WykwalifikowanyProgramista2000/Moj_Chwd_Pytak/Piękne chwytacisko.PNG

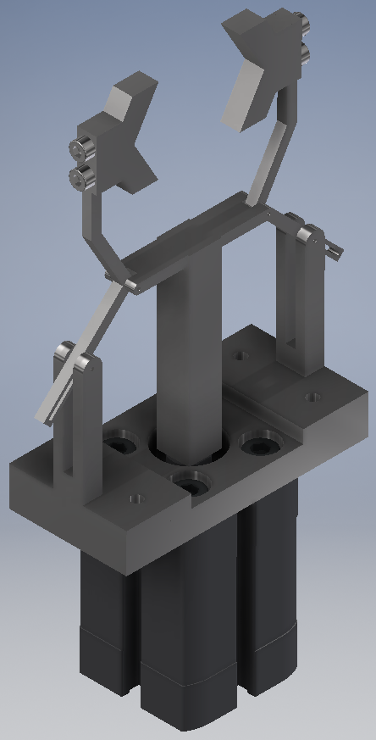
Piękne chwytacisko.PNG
