WykwalifikowanyProgramista2000/Moj_Chwd_Pytak/Fajne Chwytaki/Chwytak.pdf

# Projekt techniczny chwytaka typu

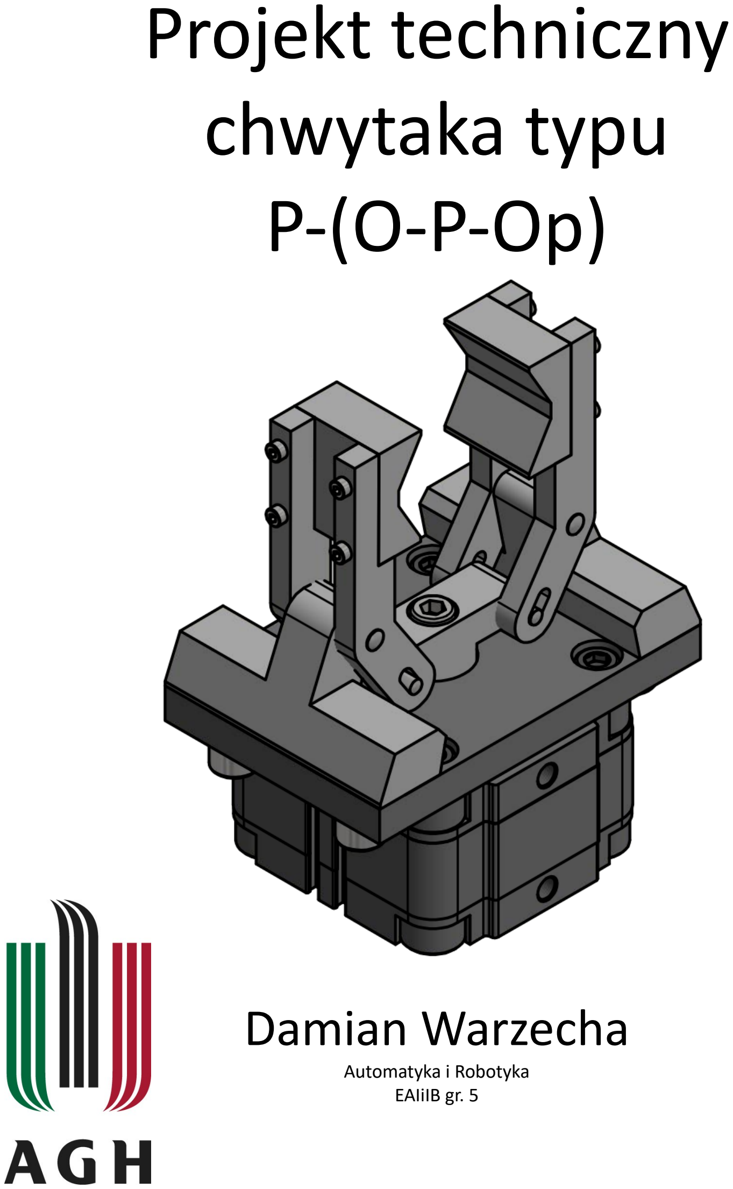
[picture p29: page 1]

# P-(O-P-Op)

# Damian Warzecha

Automatyka i Robotyka
EAIiIB gr. 5

Zadanie projektowe:
Zaprojektować chwytak do manipulatora przemysłowego o zadanym schemacie kinematycznym spełniający następujące wymagania:
- chwytak ma za zadanie uchwycić transportowany obiekt znajdujący się w położeniu początkowym, utrzymywać go w trakcie transportu, oraz wypuścić w położeniu docelowym,
- transportowanym obiektem są wałki stalowe o średnicy d = 70mm oraz długości
maksymalnej lmax | 500 mm,
- siłownik chwytaka zasilany jest sprężonym powietrzem o ciśnieniu pn | 0,6 MPa ,
- należy uwzględnić transport wałków w pozycji pionowej.

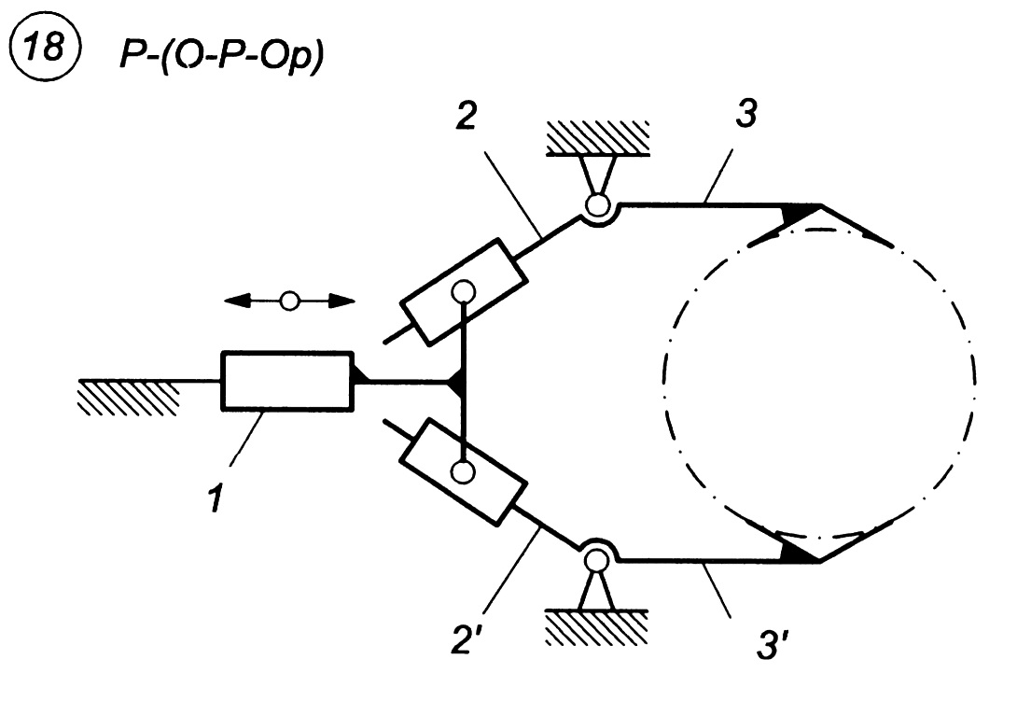
[picture p30: figure]

Rys. 1. Zadany schemat kinematyczny

### 1. Obliczenie ruchliwości chwytaka

Jako, że elementy chwytaka mogą poruszać się tylko w jednej płaszczyźnie, to ruchliwość chwytaka w obliczam ze wzoru:
w=3⋅n−p4−2⋅p5

, gdzie n to ilość członów ruchomych, a px to ilość par kinematycznych klasy x.

W moim przypadku n = 5, p4 = 0, p5 = 7 – {(0,1),(1,2),(1,2'),(2,3),(2,3'),(0,3),(0,3')}
w=3⋅5−0−2⋅7=1
Można z tego wyniku wyciągnąć wniosek, że do pracy chwytak będzie wymagał jednego siłownika liniowego.

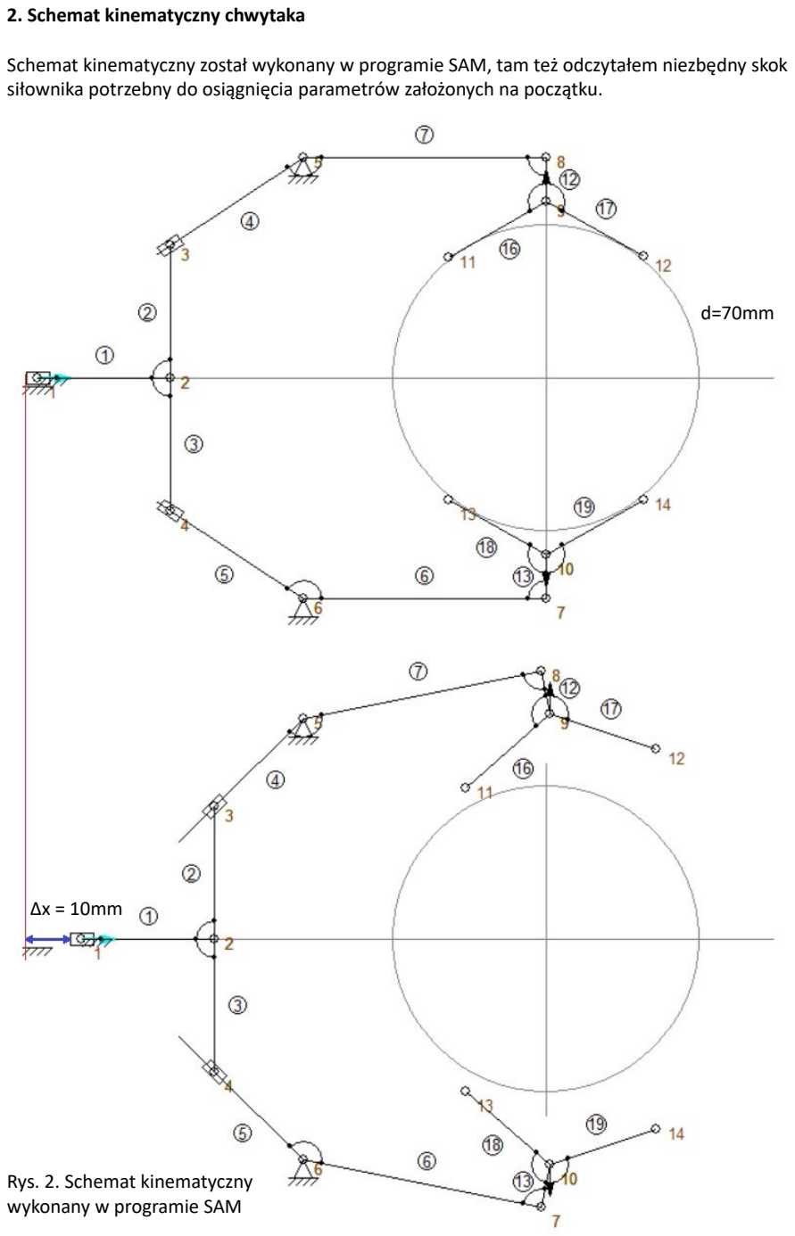
[picture p31: page 3]

### 2. Schemat kinematyczny chwytaka

Schemat kinematyczny został wykonany w programie SAM, tam też odczytałem niezbędny skok siłownika potrzebny do osiągnięcia parametrów założonych na początku.

d=70mm

Δx = 10mm

Rys. 2. Schemat kinematyczny wykonany w programie SAM

### 3. Obliczenie wymaganej siły chwytu

Maksymalny ciężar przenoszonego przedmiotu wyznaczam ze wzoru: , gdzie:
d – średnica transportowanego obiektu,
lmax – maksymalna długość obiektu,
- ciężar właściwy materiału, z którego wykonany jest przedmiot.

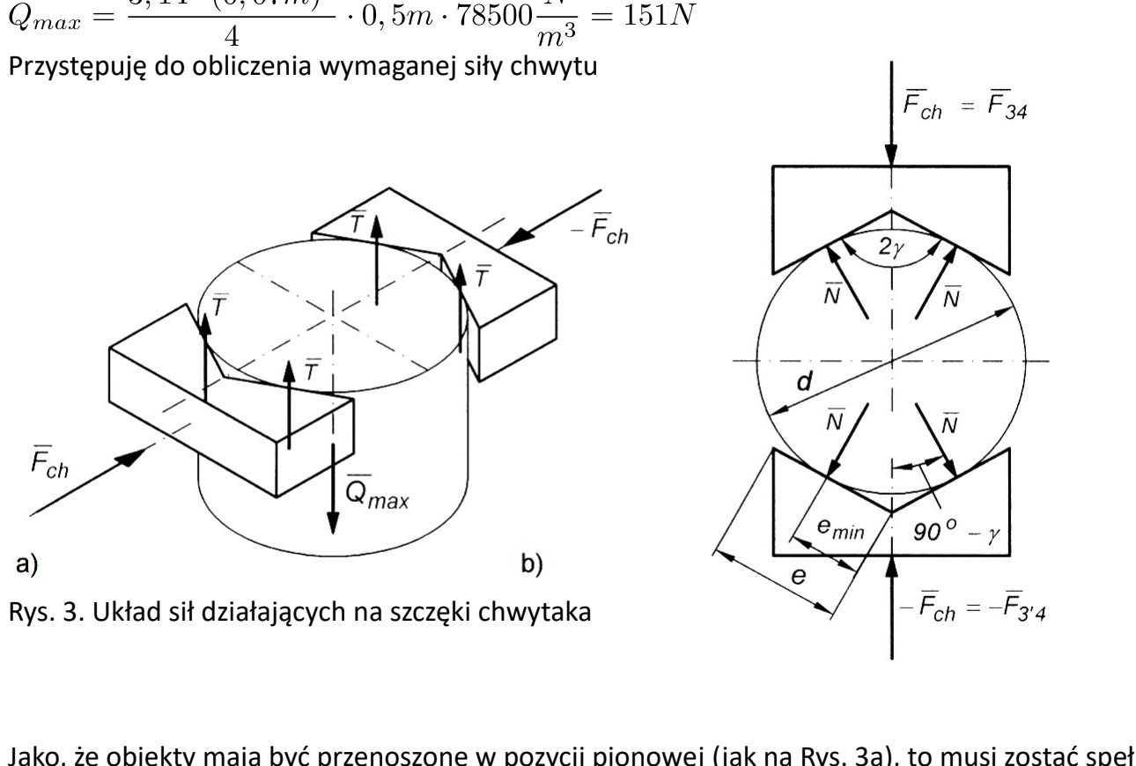
[picture p32: figure]

Przystępuję do obliczenia wymaganej siły chwytu

Rys. 3. Układ sił działających na szczęki chwytaka

Jako, że obiekty mają być przenoszone w pozycji pionowej (jak na Rys. 3a), to musi zostać spełniony warunek:
, gdzie n – współczynnik przeciążenia.

Z zależności trygonometrycznych na podstawie Rys. 4b wyznaczam :

po przekształceniu:

Korzystam teraz ze wzoru na tarcie statyczne:

Stąd otrzymujemy:

Ponownie przekształcamy wzór do ostatecznej postaci:

,
(uznaję, że w momencie rozruchu chwytak doznaje przyspieszenia równego g), ,
(współczynnik tarcia statycznego stal-stal),

Po podstawieniu do wzoru:

Od razu wyznaczam rozmiar szczęki e, jako: e > emin Aby wyznaczyć emin korzystam z zależności:
,
a więc przyjmuję rozmiar e swoich szczęk = 25mm

### 4. Charakterystyka przemieszczeniowa chwytaka

Wykres charakterystyki przemieszczeniowej został wykonany w programie SAM dla węzła nr 8

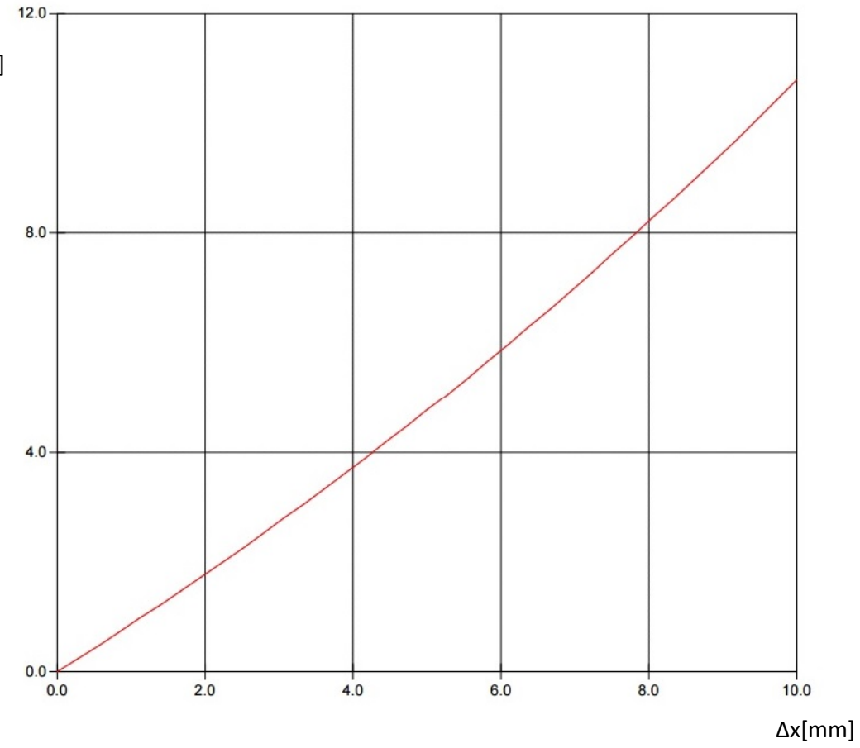
[picture p33: figure]

Δy[mm]

Rys. 4. Charakterystyka przemieszczeniowa chwytaka

## fv max = 1,4

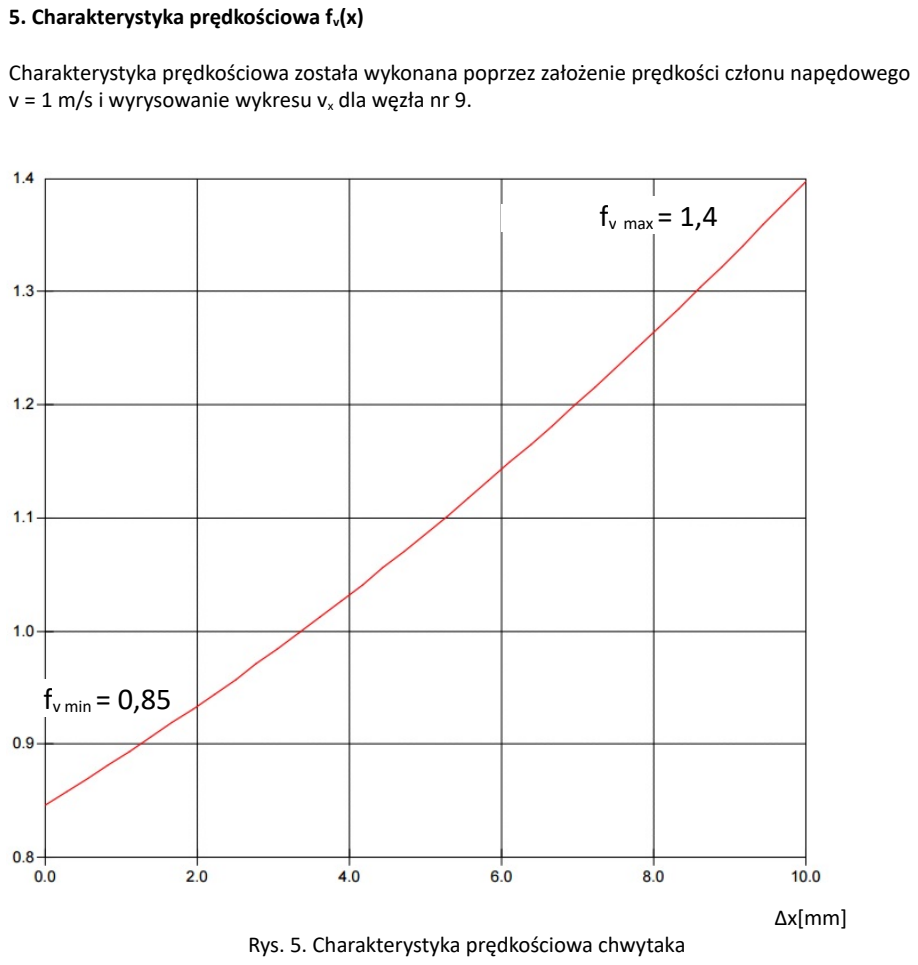
[picture p34: page 6]

### 5. Charakterystyka prędkościowa fv(x)

Charakterystyka prędkościowa została wykonana poprzez założenie prędkości członu napędowego v = 1 m/s i wyrysowanie wykresu vx dla węzła nr 9.

## fv min = 0,85

Δx[mm]
Rys. 5. Charakterystyka prędkościowa chwytaka

### 6. Charakterystyka siłowa chwytaka

Charakterystykę tą wykonałem poprzez obciążenie symetrycznie szczęk chwytaka siłami, których wartość jest równa uprzednio wyliczonej Fch i odczytanie wartości siły w kierunku x na członie zasilającym.

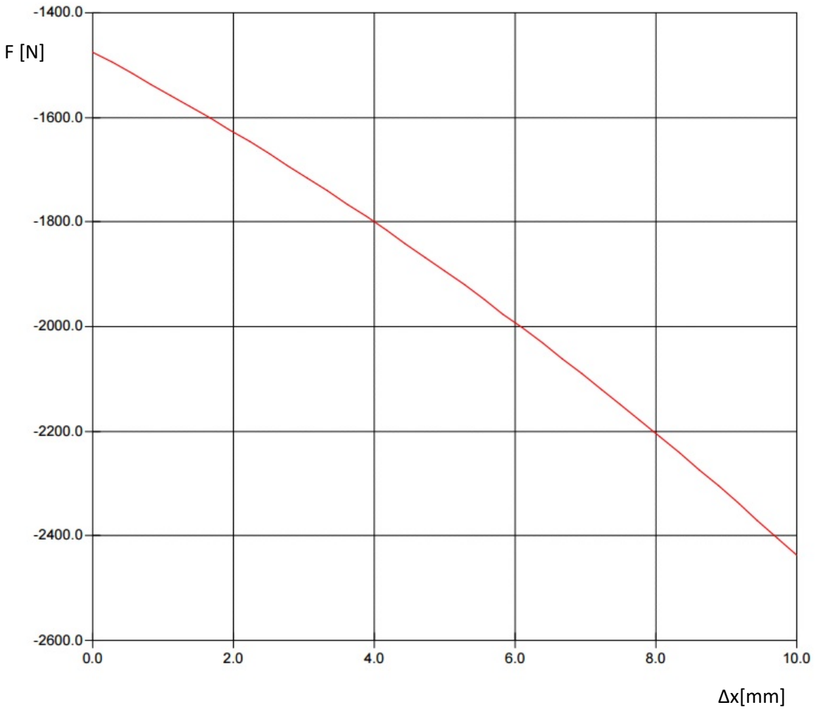
[picture p35: figure]

Rys. 6. Charakterystyka siłowa chwytaka

Jak widać w chwili zaciśnięcia szczęk chwytaka siła, jaką musi dostarczyć siłownik aby utrzymać wałek w pozycji zamkniętej jest równa 1500N. Nie przewiduję możliwości transportowania nim wałków o innych średnicach, więc pomijam pozostałą część wykresu.

Jednak siła F=1500N jest jedynie teoretyczną wartością i należy uwzględnić pewien współczynnik przeciążenia k, który zazwyczaj przyjmuje się jako k = 1,2 ÷ 1,5. Jest to dodatkowa forma zabezpieczenia, która uwzględnia np. sytuacje uderzenia przenoszonym elementem w pewną przeszkodę.
Ja przyjmę współczynnik k = 1,5 ponieważ transportowane przez mój chwytak elementy będą posiadały maksymalną masę równą 15kg, przez co upuszczone mogą stanowić znaczne zagrożenie.

A więc siła, którą będę używał do dalszych obliczeń ma wartość Fs = 2250 N.

### 7. Dobór odpowiedniego siłownika pneumatycznego

Chwytak o zadanym schemacie kinematycznym zaciska swe szczęki przy ruchu członu napędowego w kierunku przeciwnym do reszty mechanizmu, a więc siłownik jaki wybiorę musi działać w trybie ciągnącym.

Kolejnym ważnym parametrem siłownika jest średnica jego tłoka, ponieważ to od niej zależy siła, którą będzie mógł on wygenerować.

Siłę siłownika wyraża się wzorem | ,

stąd średnica tłoka

Podstawiam dane uzyskane z charakterystyki siłowej, oraz podane w treści zadania ciśnienie nominalne powietrza zasilającego chwytak.

Jako, że średnice siłowników należą do pewnego szeregu normalnego, to muszę wybrać pierwszą większą od Dmin
Dostępne średnice:
12mm | 16mm | 20mm | 25mm | 32mm | 40mm | 50mm | 63mm | 80mm | 100mm | 125mm

Wybieram średnicę D = 80mm.

Stosowny siłownik znalazłem w ofercie firmy Festo. Jest to model ADVULQ-80-10-P-A o średnicy tłoka 80mm, skoku 10mm oraz obustronnym trybie działania. Jak podaje producent przy ciśnieniu 0,6 MPa siła ciągnąca wynosi 2827 N.

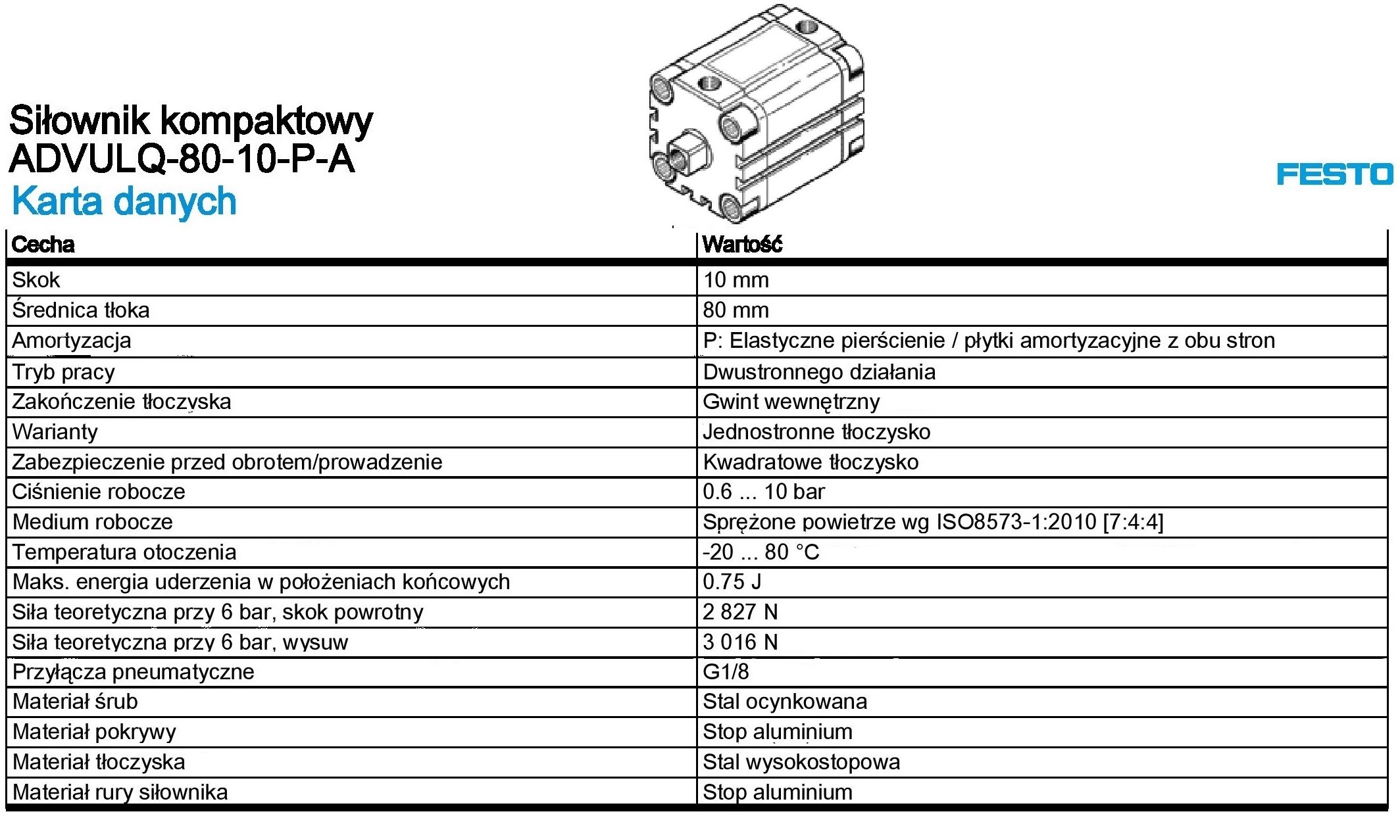
[picture p36: figure]

### 8. Obliczenia wytrzymałościowe – warunek wytrzymałości na ścinanie sworznia

Przy zadanym schemacie kinematycznym tylko 2 symetryczne względem siebie pary kinematyczne posiadają połączenia sworzniowe (węzły 5 i 6 (Rys. 2.)) , a więc wystarczy sprawdzić warunek wytrzymałości na ścinanie dla tylko jednego sworznia.
Warunek wytrzymałościowy na ścinanie ma postać: | , gdzie:
Ft | – siła działająca na sworzeń,
A – pole powierzchni, na które działa siła,

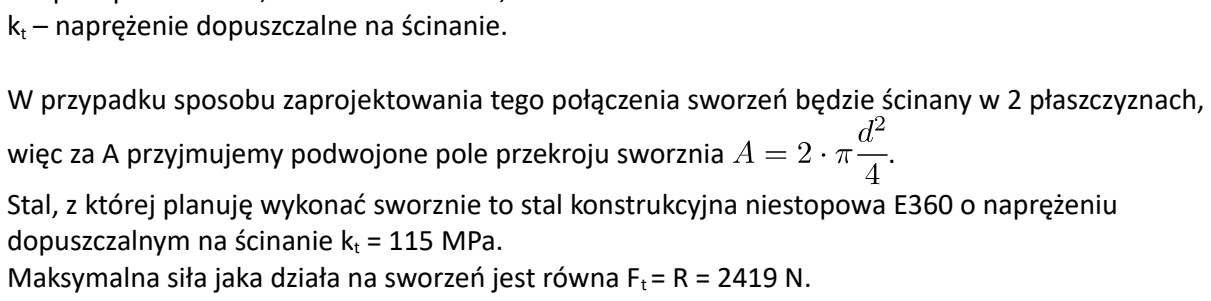
[picture p37: figure]
– naprężenie dopuszczalne na ścinanie.; dopuszczalnym na ścinanie kt; = 115 MPa.

W przypadku sposobu zaprojektowania tego połączenia sworzeń będzie ścinany w 2 płaszczyznach,
więc za A przyjmujemy podwojone pole przekroju sworznia | .
Stal, z której planuję wykonać sworznie to stal konstrukcyjna niestopowa E360 o naprężeniu

Maksymalna siła jaka działa na sworzeń jest równa Ft = R = 2419 N.

Obliczam minimalną średnicę sworznia ze wzoru:

### 9. Obliczenia wytrzymałościowe – warunek wytrzymałościowy na zginanie ramion chwytaka

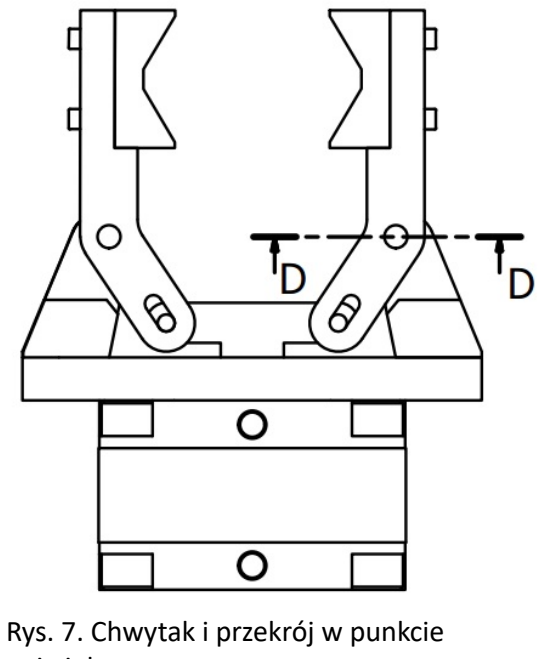
[picture p38: figure]
Rys. 7. Chwytak i przekrój w punkcie
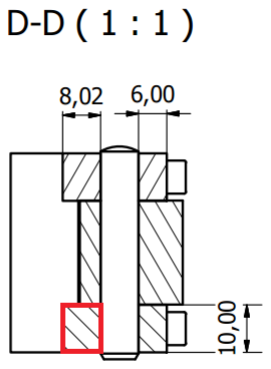
[picture p39: figure]

największego momentu gnącego

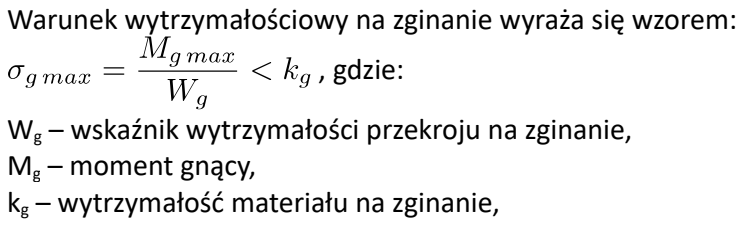
[picture p40: figure]
, gdzie:; Mg – moment gnący,

Warunek wytrzymałościowy na zginanie wyraża się wzorem:

Wg – wskaźnik wytrzymałości przekroju na zginanie,

kg – wytrzymałość materiału na zginanie,

Ramię chwytaka wykonane zostanie ze stali konstrukcyjnej E360 o kg = 210 MPa.

Największy moment gnący będzie występował w przekroju D-D i jego wartość jest równa: ,
zgadza się to z wynikiem uzyskanym w Autodesk ForceEffect

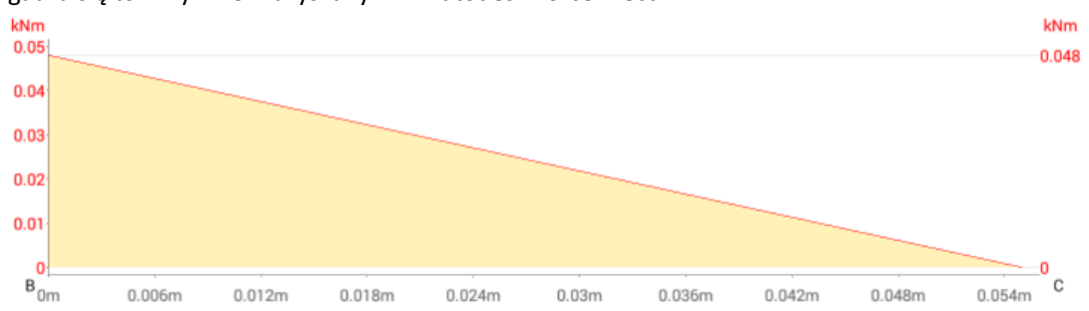
[picture p41: figure]

Jak widać na Rys. 7. przekrój nie jest symetryczny, lecz jeśli policzymy wartość wskaźnika wytrzymałości na zginanie zakładając, że część zaznaczona na czerwono ma tylko 6mm szerokości i pozostałe 2,02mm nie przenosi żadnych obciążeń, to:

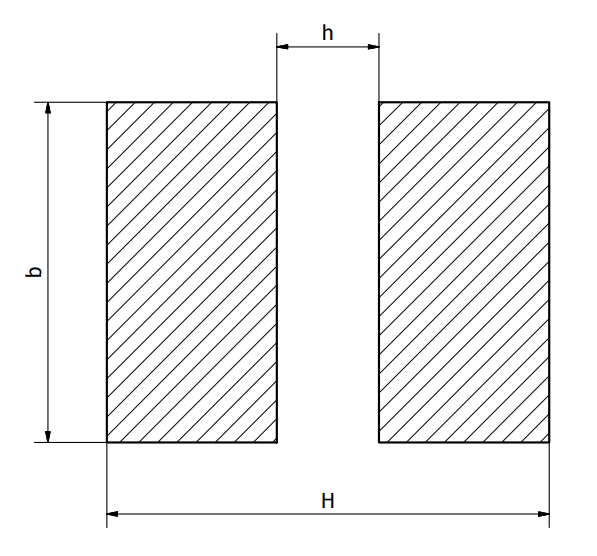
[picture p42: figure]

Jako, że ramie składa się z dwóch elementów, to wielkość b może zostać pomnożona razy 2.

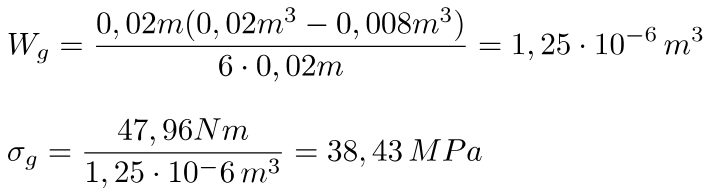
[picture p43: figure]

Czyli jest to zdecydowanie mniej niż dopuszczone dla tego materiału 210 MPa.

### 10. Projekt konstrukcyjny chwytaka

Załączniki:
1. Rysunek złożeniowy chwytaka,
2. Rysunek wykonawczy ramienia chwytaka.
