WykwalifikowanyProgramista2000/Moj_Chwd_Pytak/Fajne Chwytaki/chwytak 20 wzór.pdf

# PROJEKT CHWYTAKA

NR 20

## Dariusz Papierniak EAIiE II rok AiR

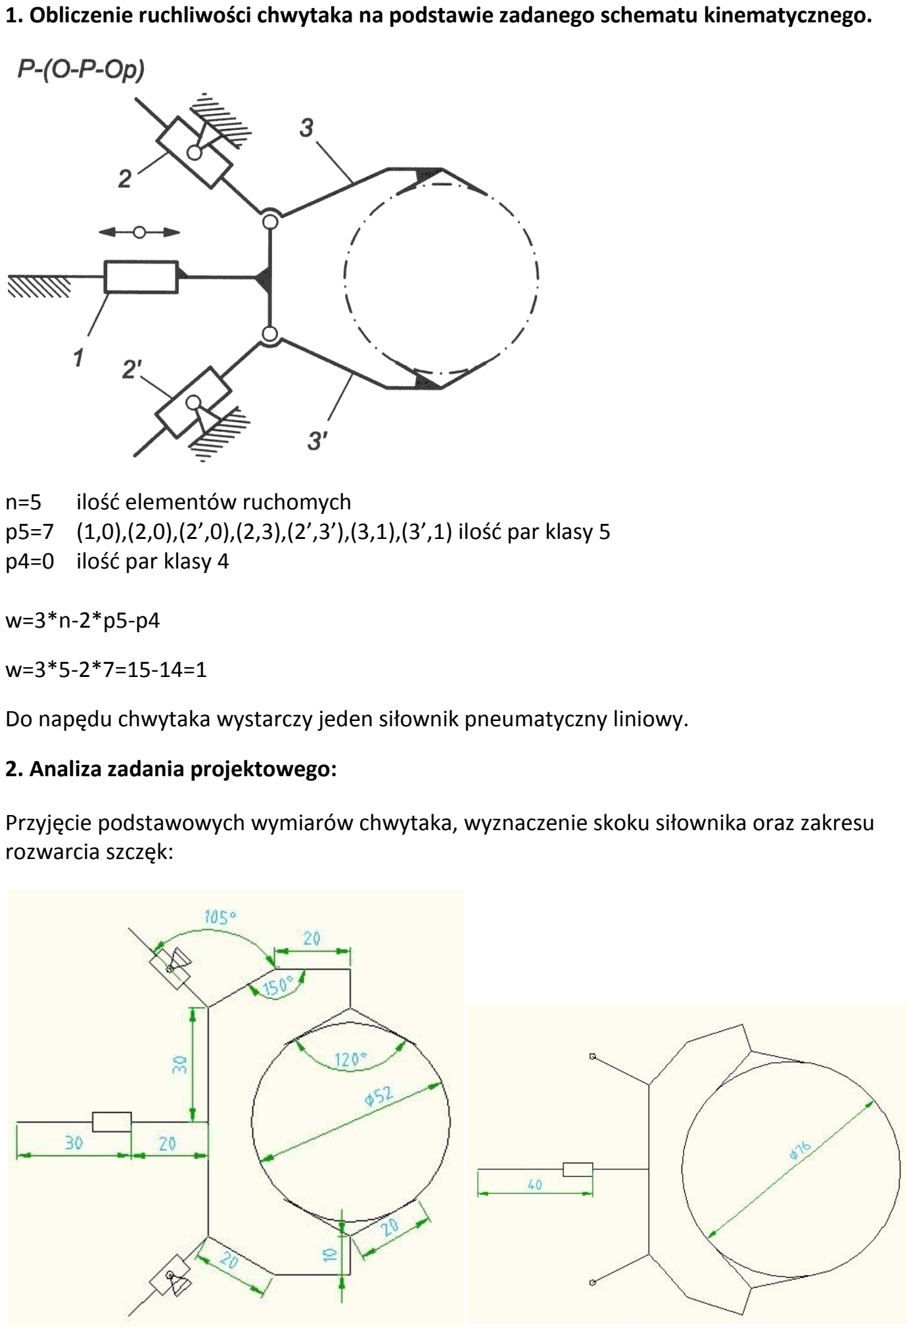
[picture p44: page 2]

1. Obliczenie ruchliwości chwytaka na podstawie zadanego schematu kinematycznego.

n=5 ilośd elementów ruchomych
p5=7 (1,0),(2,0),(2’,0),(2,3),(2’,3’),(3,1),(3’,1) ilośd par klasy 5 p4=0 ilośd par klasy 4

w=3*n-2*p5-p4

w=3*5-2*7=15-14=1

Do napędu chwytaka wystarczy jeden siłownik pneumatyczny liniowy.

### 2. Analiza zadania projektowego:

Przyjęcie podstawowych wymiarów chwytaka, wyznaczenie skoku siłownika oraz zakresu rozwarcia szczęk:

Maksymalny ciężar obiektu transportowanego obliczam ze wzoru:

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
dmax = 76,00 [mm] = 0,076 [m] | - średnica największego wałka,
dmin = 52,00 [mm] = 0,052 [m] | - średnica najmniejszego wałka,
lmax = 0.4 [m] | - maksymalna długośd chwytanego obiektu,
γ = 78000 [N/m³
] | - ciężar właściwy transportowanego materiału (stal).

Obliczone wartości Q wynoszą:

Q1 = 141,54 N | - maksymalny ciężar obiektu dla dmax
Q2 = 66,26 N | - maksymalny ciężar obiektu dla dmin

Współczynniki przyjmuję następująco:

μ = 0,2 | - współczynnik tarcia (metal-metal)
n = 2 | - współczynnik bezpieczeostwa
2γ = 120° | - kąt nachylenia szczęk chwytaka

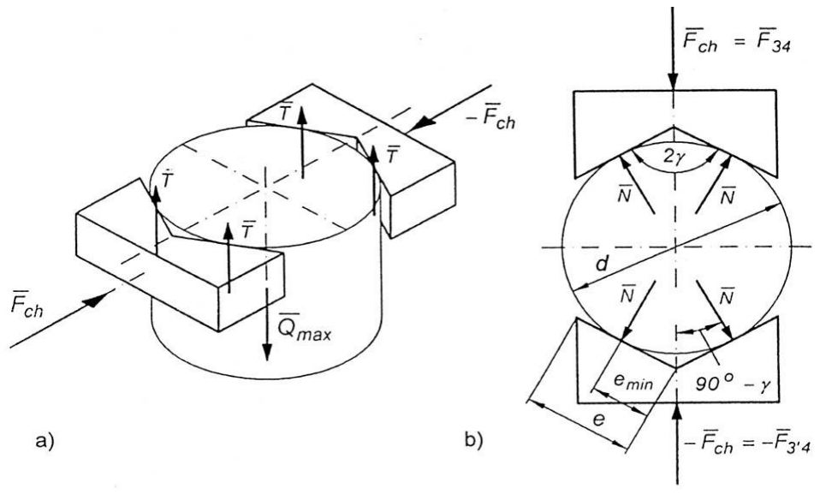
[picture p45: figure]

Wyznaczenie koniecznej siły chwytu Fch i obliczenie wymiarów szczęk:

Układ sił działających na chwytak:

a) rozkład sił tarcia podczas chwytania
b) rozkład sił normalnych podczas chwytania

F = 2N cos(90°-γ )
ch | 2cos(90 | γ ) | 2sinγ
Fch | Fch N | =
| ° -

=

γ

µ
µ
2sin

·
= | =
Fch T | N

Siły tarcia muszą spełniad warunek:

Q n

F
T
ch | ≥ ·

·
=
γ

µ
sin

2
4

stąd

µ

γ
2

Q nsin Fch
·
≥

Wstawiając dane do równania (ciężar obiektu Q2) otrzymuję:

Fch=286,91 N

Do dalszych obliczeo przyjmuję Fch=300 N

Obliczenie minimalnej wielkości szczęk

tgγ

d
e
2

min =

w moim przypadku emin=15,01 mm

Przyjęte przeze mnie e=20 mm

### 3. Obliczenie charakterystyki przesunięciowej chwytaka

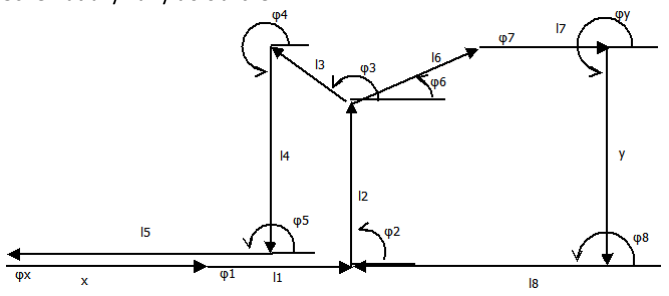
[picture p46: figure]

Schemat używany do obliczeo:

Każdemu wektorowi odpowiada kąt skierowany. Wielkości które nie ulegają zmianie w trakcie ruchu chwytaka to:

l1=20 mm, l2=30 mm, l4=40 mm, l5= 40 mm, l6=20 mm, l7=20 mm,

φx=0° , φ1=0°, φ2=90°, φ4=270°, φ5=180°, φy=270°, φ8=180°

ponadto znane są zależności:

φ6=φ3-105°, φ7=φ3-135°

Pozostałe wielkości zależą od wartości x.

Zgodnie z przyjętymi wcześniej wielkościami x zmienia się w przedziale od 30 do 40 mm

Korzystam z metody analitycznej.

Dla zamkniętego wieloboku wektorowego zapisuję równanie:

Z którego wyznaczam wartośd φ3 potrzebną do dalszych obliczeo:

Rzut na oś x:

xcos(φx)+l1cos (φ1)+ l2cos (φ2)+ l3cos (φ3)+ l4cos (φ4)+ l5cos (φ5)=0

Po uwzględnieniu znanych kątów:

x+l1+l3cos(φ3)-l5=0

więc

l3cos(φ3)=l5-x-l1

Rzut na oś y:

xsin(φx)+l1sin(φ1)+ l2sin(φ2)+ l3sin(φ3)+ l4sin(φ4)+ l5sin(φ5)=0

Po uwzględnieniu znanych kątów:

l2+l3sin(φ3)-l4=0

więc

l3sin(φ3)=l4-l2 po wyrugowaniu l3 otrzymuję:

funkcja arctg zwraca kąt z przedziału -90°,90°, ponieważ kąt φ3 jest kątem rozwartym

Natomiast z jedynki trygonometrycznej otrzymuję:

l3=

Zapisuję równanie wektorowe dla drugiego wieloboku:

Do wyznaczenia wartości y wystarczy rzut na oś y:

ysin(φy)+l2sin(φ2)+ l6sin(φ6)+ l7sin(φ7)+ l8sin(φ8)=0

Po wstawieniu znanych wartości kątów:

y=l2+l6sin(φ3-105°)+ l7sin(φ3-135°)

Oto charakterystyka przesunięciowa otrzymana za pomocą programu Excel:

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
30 | 31 | 32 | 33 | 34 | 35 | 36 | 37 | 38 | 39 | 40 y, mm

x, mm

Charakterystyka przesunięciowa chwytaka

4. Wyznaczenie charakterystyki prędkościowej chwytaka.

W celu otrzymania charakterystyki prędkościowej chwytaka należy zróżniczkowad charakterystykę przesunięciową.

fV(x)=

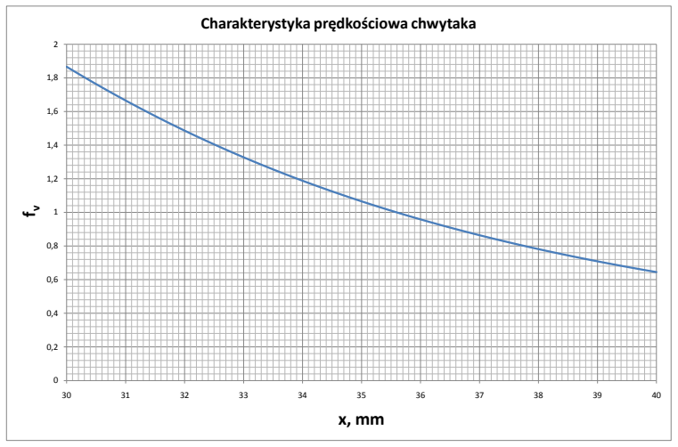
[picture p47: figure]
Charakterystyka prędkościowa chwytaka

Powyżej znajduje się charakterystyka prędkościowa uzyskana za pomocą programu Excel. Poniżej zamieszczam natomiast obie charakterystyki uzyskane w programie SAM.

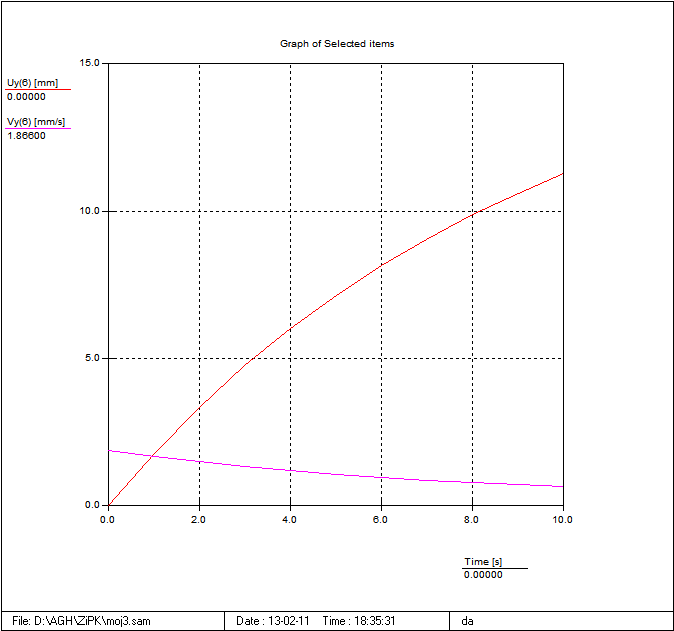
[picture p48: figure]

W obu przypadkach charakterystyki te są identyczne.

### 5. Wyznaczenie charakterystyki siłowej chwytaka

gdzie:

- siła chwytu
- siła na wyjściu siłownika
- przełożenie siłowe mechanizmu chwytaka

Model obliczeniowy do wyznaczenia charakterystyki siłowej

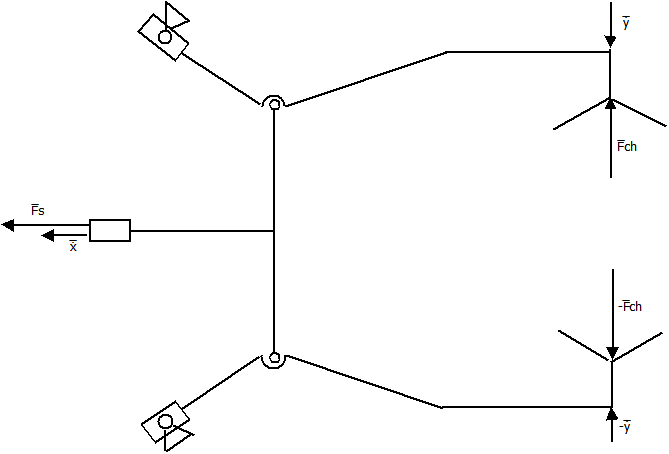
[picture p49: figure]

Dokonuję obliczeo dla chwytaka w pozycji zamkniętej. Wówczas stosując te same oznaczenia kątów i wektorów co w pkt 3:

φ3=135°, φ6=30°, φ7=0 °

Po uwolnieniu od więzów górne ramię wygląda następująco:

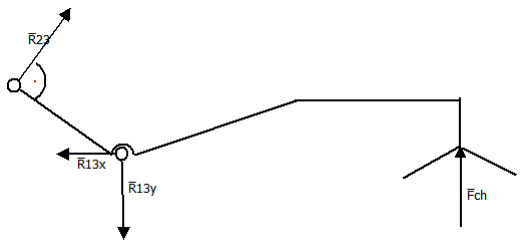
[picture p50: figure]

Siła R23 jest prostopadła do l3, zatem jest pod kątem φ3-90°. W rozpatrywanej sytuacji

R23x= R23y= R23

Z warunków równowagi dla sił i momentów możemy zapisad:

skąd otrzymuję następujące zależności:

R23x=R13x

R13y=Fch+R23y

korzystając z wcześniej obliczonego wzoru na l3 mogę zapisad:

skąd dla Fch=300N

R23=791,68 N więc R23x=R23y=559,8 N

Dla pozostałej części chwytaka mamy:

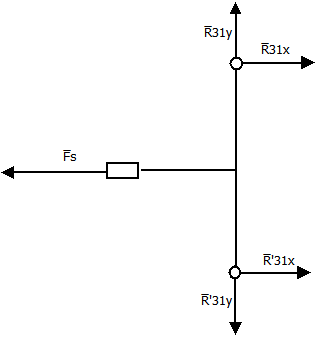
[picture p51: figure]

ponieważ R31=R’31 mamy:

Fs=2 R31x

ponadto

więc w początkowym położeniu wymagana siła Fs=1119,6 N

Wprowadzając zależności analityczne możemy równanie momentów dla ramienia zapisad następująco:

minus przy cos po prawej stronie pojawił się gdyż interesuje nas długośd rzutu wektora l3 na oś x.

Ponieważ R23 ma byd prostopadłe do l3 mamy zależnośd między składową poziomą i pionową:

ponadto:

Otrzymuję

po uwględnieniu wcześniej wyprowadzonych wzorów otrzymuję:

6. Sprawdzenie charakterystyki siłowej metodą mocy chwilowych. Model chwytaka do wyznaczenia bilansu mocy chwilowych:

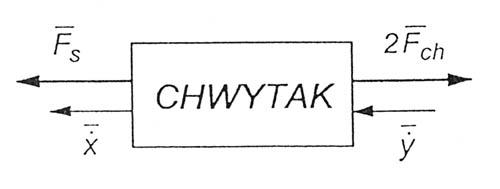
[picture p52: figure]

Bilans mocy chwilowych przy pominięciu tarcia, sił ciężkości oraz bezwładności:

NWE+NWY=0

2 ( )

1
( )
2 | 0

f x

f x

F x | F | y

v

F

S | ch
=
- - · =

Otrzymana charakterystyka jest identyczna jak w pkt 5. Oto jej wykres:

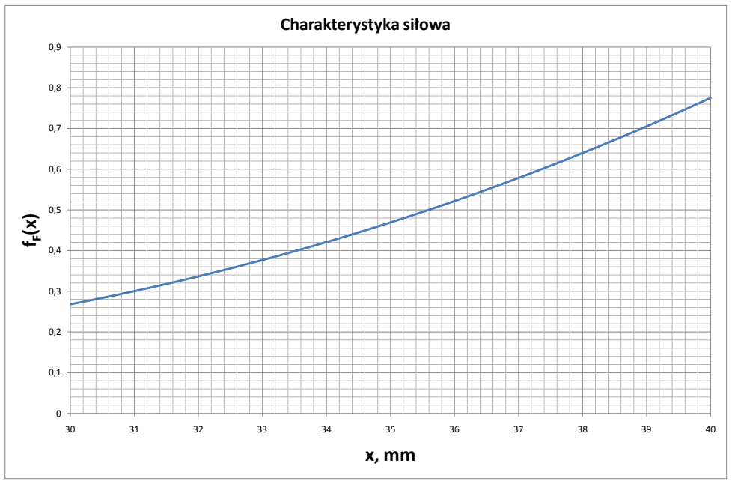
[picture p53: figure]
Charakterystyka siłowa

### 7. Obliczenia wytrzymałościowe

a) najbardziej obciążonego sworznia na ścinanie

Najbardziej obciążonym sworzniem jest ten, na którym obraca się ramię. Działa na niego siła F31. Dla położenia x=30 mm jest ona największa i wynosi około 800N (wartośd wyliczona na podstawie równao z pkt 5). Siła tnąca T wynosi więc 400N, gdyż ramię chwytaka jest podwójne. Sworzeo ma średnicę 5mm i jest wykonany ze stali st3, dla której dopuszczalne naprężenie na ścinanie wynosi kt=54 MPa.

a więc warunek wytrzymałości na ścinanie został spełniony.

b) ramienia na zginanie

Maksymalny moment gnący występuje w miejscu w którym przez ramię przechodzi sworzeo dla x=30 mm. Działający wówczas na ramię moment wynosi:

11,2 Nm

Ramię jest podwójne więc na każdą częśd działa moment równy 5,6 Nm.

Każda częśd ramienia będzie miała w przekroju kwadrat o boku 10mm. Ponieważ przez ramię w tym miejscu przechodzi sworzeo o średnicy 5mm przyjmuję h=5 mm.

wzór na naprężenie:

po wstawieniu danych daje wartośd

Dla stali st5, z której zostanie wykonane ramię kg=160 MPa, więc również ten warunek wytrzymałości został spełniony.

8. Obliczenie wymaganych parametrów napędu pneumatycznego chwytaka.

Teoretyczna siła pchająca sylindra pneumatycznego:

Teoretyczna siła ciągnąca napędu pneumatycznego:

Siłownik musi spełniad zasadę:

Fs max obliczam z charakterystyki siłowej i wynosi ona:

Fs max | N

dla k=1,5 potrzebna siła ciągnąca wynosi 1680 N

Z katalogu firmy FESTO wybieram standardowy siłownik o średnicy tłoka 63mm i skoku 10mm

Podana przez producenta siła ciągnąca wynosi 1750 N.

Oznaczenie siłownika to ADVC-63-10-A-P.
