WykwalifikowanyProgramista2000/Moj_Chwd_Pytak/Gotowy projekt v1.pdf

Zapis i Podstawy Konstrukcji. Projekt chwytaka P-(O-P-Op)

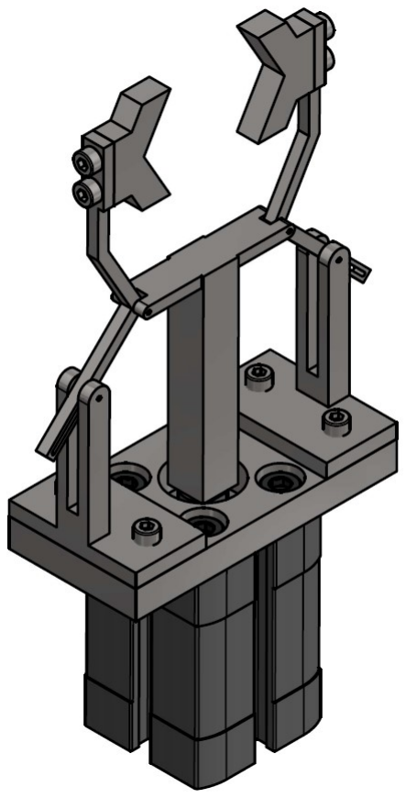
[picture p54: figure]

1

# PROJEKT CHWYTAKA TYPU P-(O-P-Op)

# Wojciech Dziuba

### Automatyka i Robotyka

### WEAIiIB


2

## Zadanie projektowe

Zaprojektować chwytak do manipulatora przemysłowego według zadanego schematu kinematycznego spełniający następujące wymagania:

a) w procesie transportu urządzenie chwytające ma za zadanie pobrać (uchwycić) obiekt w położeniu początkowym, trzymać go w trakcie trwania czynności transportowych i uwolnić go w miejscu docelowym
b) obiektem transportu są wałki oraz tuleje ze stali o średnicy d = 34mm
i długości l = 100mm
c) manipulator zasilany jest sprężonym powietrzem o ciśnieniu nominalnym pn = 0,6 MPa.
d) wałki transportowane są wyłącznie w pozycji pionowej

Rys. 1. Schemat kinematyczny chwytaka

## 1. Obliczenie ruchliwości chwytaka

Ruchliwość mechanizmu chwytaka obliczono korzystając z poniższego wzoru

w = 3n − 2p5 − p4 | (1)

Gdzie:

w | – ruchliwość chwytaka
n | - liczba członów ruchomych
p5 | - liczba par kinematycznych klasy piątej obrotowych i postępowych
p4 | - liczba par klasy czwartej

Zapis i Podstawy Konstrukcji. Projekt chwytaka P

Dla chwytaka P-(O-P-Op):

n = 5 | p5 = 7 (1,0) (2,0

Ruchliwość mechanizmu chwytaka w = 1, w związku z czym do napędzania chwytaka wykorzystano pojedynczy siłownik pneumatyczny o ruchu liniowym.

## 2. Analiza zadania projektowego


Rys. 2. Schemat kinematyczny chwytaka w założonych położeniach krańcowych wykonany w programie SAM 7.0
Pozycja A –
Pozycja B – rozwarcie maksymalne szczęk d

3

) (2’,0) (2,3) (2’,3’) (3,1) (3’,1)

w = 3 ∗ 5 − 2 ∗ 7 − 0 = 1

emat kinematyczny chwytaka w założonych położeniach krańcowych przy skoku członu napędzającego rozwarcie minimalne szczęk dA = 34mm rozwarcie maksymalne szczęk dB = 60mm

p4 = 0

∆x = 15mm

mm

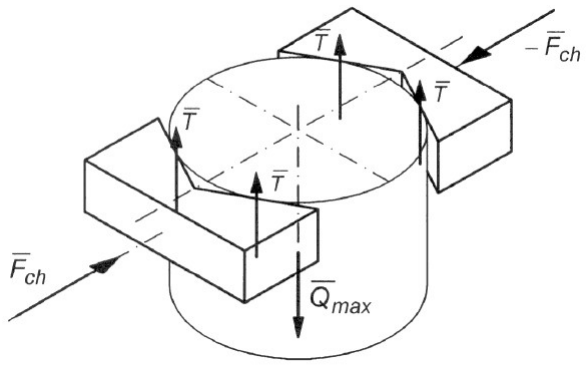
[picture p55: figure]

4

## 3. Wyznaczenie koniecznej siły chwytu Fch

Transportowany obiekt powinien być chwytany w pozycji którą pokazano na Rys. 3. oraz Rys. 4.

Rys. 3. Rozkład sił tarcia podczas chwytania obiektu


Rys. 4. Rozkład sił
normalnych podczas
chwytania obiektu

Maksymalny ciężar transportowanego obiektu Qmax wyznaczono ze wzoru (2) rozpatrując sytuację w pozycji A Rys. 2.

Qmax =

π dmax

2
4
lmax ∗ ρ [N] | (2)

Gdzie:

dmax | - maksymalna średnica przenoszonego obiektu
lmax | - maksymalna długość przenoszonego obiektu
ρ | - ciężar właściwy transportowanego obiektu

Zatem:

Dla pozycji A | QA max =

π ∙ 0,0342
4
- 0, 1 ∙ 78, 5 ∙ 103
≅ 7, 20 [N]

5

Następnie konieczną siłę chwytu szczęk chwytaka wyznaczono za pomocą przekształconego wzoru (3) w następujący sposób

Fch = 2Ncos(90° − γ) = 2Nsin(γ) | (3)

N =

Fch
2sin(γ)

T = μN =

μFch
2sin(γ)
Aby transportowany element został uchwycony prawidłowo musi być spełniony warunek:

4T =

2μFch
sin(γ)
≥ Q ∙ n | stąd | Fch ≥

Qn sinγ
2μ

Gdzie:

N - siła normalna
2γ | - kąt rozwarcia szczęk chwytaka
μ | - współczynnik tarcia pomiędzy stalowymi szczękami chwytaka, a
stalowym obiektem
n | - Współczynnik przeciążenia chwytaka (przyjęty za równy 2)

Dla pozycji A z Rys. 2. wymagana siła chwytu Fch wynosi:

FA ch ≥

7, 2 ∙ 2 ∙ sin(60°)
2 ∙ 0, 15 ≅ 42 [N]

Minimalne wymiary szczęki chwytaka obliczono na podstawie poniższych wzorów, kształtu ramion chwytaka (Rys. 4.) oraz kształtu transportowanego obiektu:

tgγ =

d

2emin

stąd | e > emin =

d
2tgγ
Zatem dla przenoszenia wałków o średnicy d = 34 mm:

emin =

34
2 ∙ tg(60°) ≅ 11 mm

Dla dalszych obliczeń przyjęto zatem e = 15 mm.


6

## 4. Charakterystyka przemieszczeniowa chwytaka

Rys. 5. Model chwytaka do wyznaczania charakterystyki przemieszczenia przy wykorzystaniu metody zamkniętego wieloboku.

Wielkości stałe:

l1 | = 25mm
l2 | = 20mm
l4 | = 34mm
l5 | = 31mm
l6 | = 20mm
l7 | = 20mm
φx | = 0°
φy | = 270°
φ1 | = 0°
φ2 | = 90°
φ4 | = 270°
φ5 | = 180°
φ8 | = 180°
Pozostałe wielkości:
φ6 = φ3 – 105 | φ7 = φ3 – 135

Są one zależne od wartości x. Delta x wynosi ∆x = 15mm, a długość x zmienia się od 20mm do 35mm.

### 4.1 Wielobok L

Korzystając z metody analitycznej suma wszystkich wektorów wieloboku wektorowego L musi być równa 0.

x + l1 ⃗ + l2 ⃗ + l3 ⃗ + l4 ⃗ + l5 ⃗ = 0

Następnie wykonano rzut na OY oraz OX.

xcos(φx) + l1cos(φ1) + l2cos(φ2) + l3cos(φ3) + l4cos(φ4) + l5cos(φ5) = 0 xsin(φx) + l1sin(φ1) + l2sin(φ2) + l3sin(φ3) + l4sin(φ4) + l5sin(φ5) = 0

15 Przemieszczenie [mm]; Wysunięcie suwaka [mm]; Charakterystyka przemieszczeniowa

7

x + l1 + l3cos(φ3) − l5 = 0 l2 + l3sin(φ3) − l4 = 0

l3cos(φ3) = l5 − x − l1
l3sin(φ3) = l4 − l2
Zatem:

l3sin(φ3)
l3cos(φ3)

= tg(φ3) =

l4 − l2
l5 − x − l1 | φ3 = arctg

l4 − l2
| l5 − x − l1 + 180°
[l3cos(φ3)]

2 = [l5 − x − l1]

2
[l3sin(φ3)]

2 = [l4 − l2]

2

l32cos(φ3) | 2 + sin(φ3) 2 = [l5 − x − l1]

2 + [l4 − l2]

2

l3 = [l5 − x − l1]2 + [l4 − l2]2

### 4.2 Wielobok P

Równanie dla wieloboku P:

y⃗ + l2 ⃗ + l6 ⃗ + l7 ⃗ + l8 ⃗ = 0

ysin(φy) + l2sin(φ2) + l6sin(φ6) + l7sin(φ7) + l8sin(φ8) = 0

y = l2 + l6sin(φ3 − 105°) + l7sin(φ3 − 135°)

Rys. 6. Charakterystyka przemieszczeniowa otrzymana w programie Excel 2007


8

Rys. 7. Charakterystyka przemieszczeniowa otrzymana w programie SAM 7.0 Oś pozioma x – wysunięcie suwaka [mm] Oś pionowa y – przemieszczenie [mm]

Otrzymane charakterystyki są bardzo zbliżone i różnice pomiędzy kolejnymi wartościami znajdują się na drugim miejscu po przecinku

| Wysunięcie suwaka [mm] | Przemieszczenie [mm]
Początkowe | 0 | 0
Końcowe | 15 | 11,744

## 5. Charakterystyka prędkościowa chwytaka

Charakterystykę prędkościową chwytaka wyznaczono różniczkując charakterystykę przesunięciową po x

dy
dx =

d
dx (l2 + l6 sin(φ3 − 105°) + l7 sin(φ3 − 135°))

dy
dx = l2

dφ3
dx + l6 sin(φ3 − 105°)

dφ3
dx + l7 sin(φ3 − 135°)

dφ3
dx

dy
dx = l6 ∙ sin(φ3 − 105°)

dφ3
dx + l7 ∙ sin(φ3 − 135°)

dφ3
dx

dφ3
dx =

l4 − l2
(l5 − x − l1)

2 + (l4 − l2)

2

fv

(x) =

dy
dx =

(l4 − l2) ∙ ((l6 ∙ cos(φ3 − 105°) + l7 ∙ cos(φ3 − 135°)) (l5 − x − l1)2 + (l4 − l2)2

15 Prędkość [mm/s]; Wysunięcie suwaka [mm]; Charakterystyka prędkościowa fv

9

Rys. 6. Charakterystyka prędkościowa otrzymana w programie Excel 2007

Rys. 7. Charakterystyka prędkościowa otrzymana w programie SAM 7.0 Oś pozioma x - wysunięcie suwaka [mm]
Oś pionowa y – prędkość [mm/s]
| Wysunięcie suwaka [mm] | Prędkość [mm]
Początkowe/a | 0 | 0
Końcowe/a | 15 | 11,744

Zapis i Podstawy Konstrukcji. Projekt chwytaka P

## 6. Charakterystyka siłowa chwytaka

Charakterystyka siłowa określona jest poniższym wzorem

Gdzie:
fF(x) | - Przełożenie siłowe mechanizmu chwytaka
Fch | - Siła chwytu
Fs | - Siła na wyjściu zespołu napędowego (siłownika) chwytaka

Można ją jednak wyznaczyć stosując metod
wykorzystać wzór fv(x) wcześniej policzonej charakterystyki prędkościowej chwytaka

Gdzie:
fF(x) | - Przełożenie siłowe mechanizmu chwytaka
fv(x) | - Charakterystyka prędkościowa
| fF (x) = 2(l4 −

Zamiast charakterystyki siłowej wyrażonej powyższym wzorem wykonano charakterystykę siły na członie napędzającym
założeniu, obciążenia ramion chwytaka symetrycznym układem sił Maksymalna siła na członie napędzającym wyniosła


Rys. 8. Model do wykonania charakterystyki siłowej w programie SAM 7.0

10

fF

(x) =

Fch
FS

Przełożenie siłowe mechanizmu chwytaka

Siła na wyjściu zespołu napędowego (siłownika) chwytaka

ę mocy chwilowych, w której można wcześniej policzonej charakterystyki prędkościowej

fF

(x) =

1
2 ∙ fv(x)

Przełożenie siłowe mechanizmu chwytaka

(l5 − x − l1)

2 + (l4 − l2)

2
l2) ∙ ((l6 ∙ cos(φ3 − 105°) + l7 ∙ cos(φ3 − 135

w programie SAM 7.0

FSmax = 111N

Model do wykonania charakterystyki siłowej w programie SAM 7.0

135°)

przy
Fch = 42N

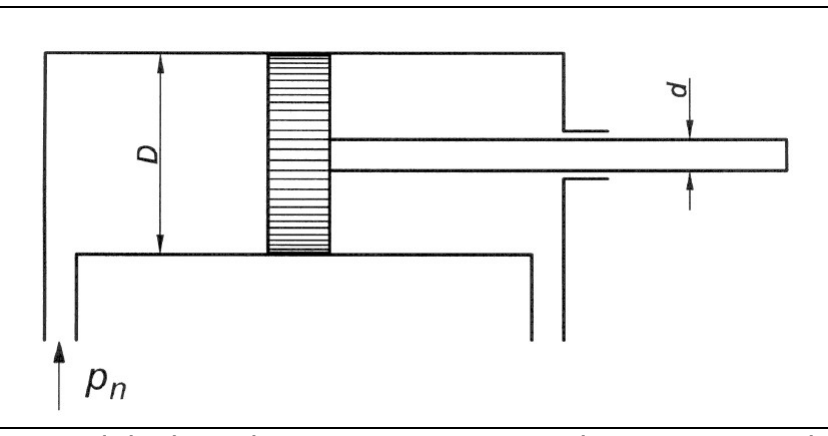
[picture p56: figure]

11

Rys. 9. Charakterystyka siły na członie napędzającym wykonana w SAM 7.0 Oś pozioma – wysunięcie suwaka [mm] Oś pionowa – siła na członie napędzającym (suwaku) [N]

## 7. Obliczenie wymaganych parametrów napędu pneumatycznego chwytaka

Rys. 10. Model siłownika pneumatycznego dwustronnego działania

Przy założeniu ciśnienia zasilania pneumatycznego pn = 0,6MPa i sile na członie napędzającym FS = 111N wymaganą minimalną średnicę tłoka Dmin obliczono za pomocą poniższego wzoru

Dmin =
4 ∙ FSmax
π ∙ pn

≅ 0, 016 m

Następnie na podstawie wyznaczonej minimalnej średnicy tłoka dobrano odpowiedni siłownik stosując zasadę


12

Pt

≥ Pw = k ∙ FSmax
Gdzie:
Pt | - teoretyczna siła pchająca lub ciągnąca siłownik
Pw | - obliczona wymagana siła na tłoczysku
k = 1,2 | - współczynnik przeciążenia
FSmax | - Siła na wyjściu siłownika chwytaka

Zatem:

Pt

≥ Pw = 1, 2 ∙ 111 ≅ 134N
Oznacza to że interesuje nas siłownik o parametrach
Pt ≥ 134N | D ≥ 16mm | ∆x = 15mm

## 8. Dobór siłownika na podstawie wymaganych parametrów

Biorąc pod uwagę wymagania wyznaczone w punkcie 7. dobrano odpowiedni siłownik z oferty firmy Festo[1]

Rys. 11. Karta danych siłownika


13

## 9. Obliczenia wytrzymałości chwytaka

### 9.1 Sprawdzenie warunku wytrzymałościowego na ścianie dla najbardziej obciążonego sworznia

Rys. 13. Charakterystyka siły Fabs absolutnej działającej w przegubie 10 (Rys.8.) zestawiona z charakterystyką siły Fx na członie napędzającym

Na podstawie Rys. 13. oraz Rys. 8. można określić że największe obciążenie występuje w sworzniu 10 oraz 11 w pozycji chwytu. Siła reakcji na tym przegubie wynosi Rs

≅ 79N i jest jednocześnie maksymalną siłą reakcji ma tym przegubie.

Na materiał do wykonania sworzni oraz konstrukcji chwytaka została wybrana stal 20HG, [2] której wytrzymałość na ścinanie wynosi kt = 240 MPa, a sworznie w całym mechanizmie mają średnicę d = 1mm.
Sworznie ścinane są w dwóch płaszczyznach zatem warunek wytrzymałościowy ma postać

τmax =

2 ∙ Rs
π ∙ d2 ≅ 51 MPa < kt = 240 MPa

Wynika z tego że warunek wytrzymałości na ścinanie został spełniony.

Ponieważ obliczenia były wykonywane dla najbardziej obciążonego sworznia można uznać, że pozostałe sworznie również będą odporne na ścinanie

### 9.1 Sprawdzenie warunku wytrzymałościowego na zginanie ramion chwytaka

Moment gnący ramię obliczono na podstawie wzoru

Mg = r ∙ Fch

Gdzie:
r | - ramię siły
F - siła chwytu

14

Maksymalny moment gnący znajduje się w miejscu w którym ramię przechodzi przez sworzeń przy zamkniętym położeniu szczęk chwytaka. Moment siły w tamtym miejscu to:

Fch ∙ (l6 cos(30°) + l7) ≅ 1, 6 Nm
Co pokrywa się z wartością wyliczoną przez SAM 7.0, który podaje Mg ≅ 1,6 Nm.

Ramie chwytaka ma przekrój kwadratu o boku a = 3mm, a sworzeń przechodzący przez ramię w miejscu przegubu osłabia konstrukcję, więc wzór na wskaźnik wytrzymałości przyjmuje postać

Wg =

a(a

3 − d

3
)
6a ≅ 4, 3 ∙ 109 m3

Na podstawie wyżej wyznaczonych wartości wyznaczono warunek wytrzymałościowy wyrażony poniższym wzorem

σgmax =

Mg
Wg

≅ 370 MPa < kg = 450 MPa

Stal 20HG[2] hartowana i nawęglana którą wybrano na wykonanie ramion chwytaka posiada wytrzymałość na zginanie kg = 450 MPa, co oznacza że warunek wytrzymałości na zginanie został spełniony.

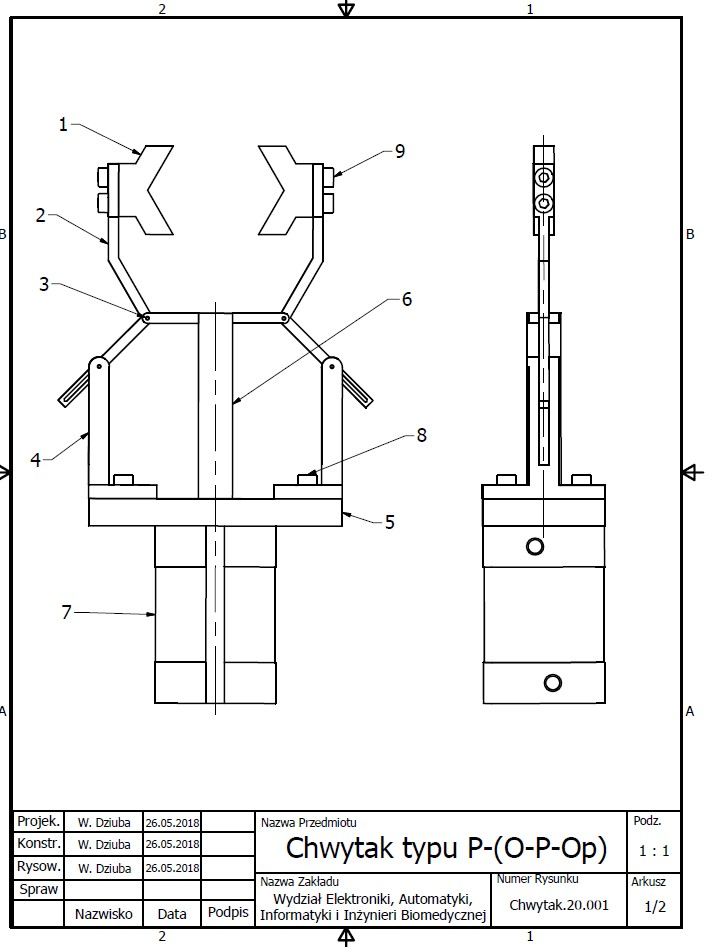
[picture p57: figure]

15

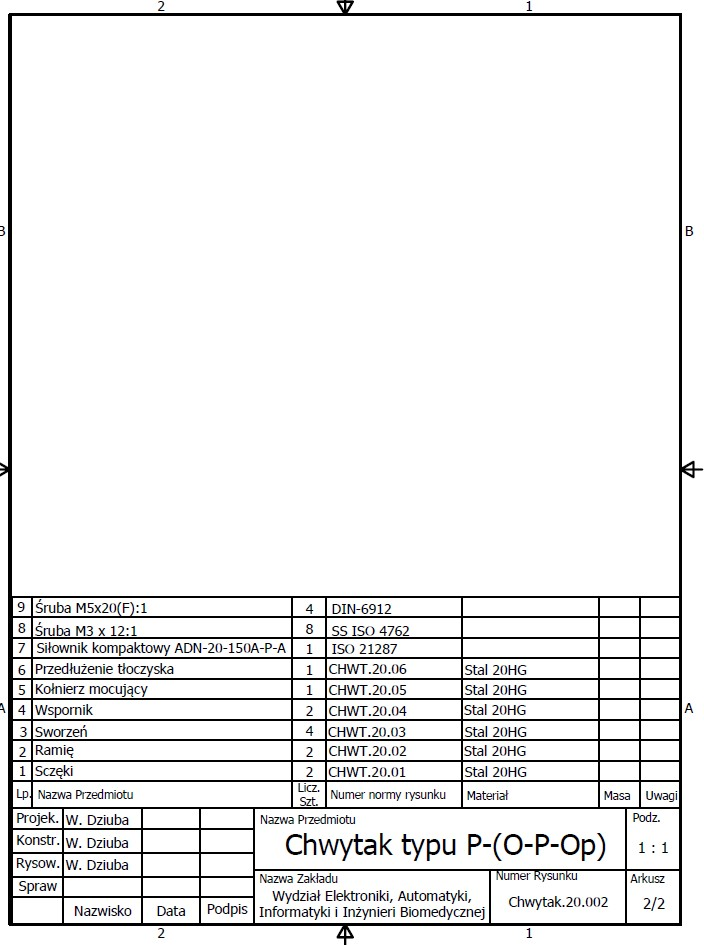
[picture p58: figure]

16

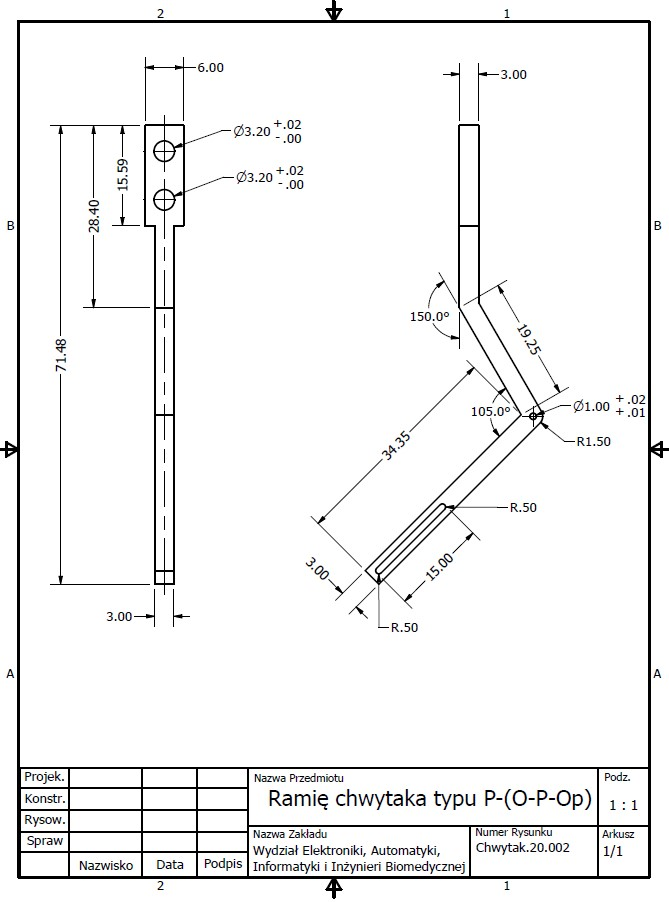
[picture p59: figure]

17

18

## Bibliografia

[1] https://www.festo.com/cat/pl_pl/products 25.05.2018
[2] http://gemini.net.pl/~marshall/pkm/tablice/tab01.htm 26.05.2018
