WykwalifikowanyProgramista2000/Moj_Chwd_Pytak/DO DRUKU/3 Chwytak-20-001 Rysunek główny 2.pdf

1

2

B | B

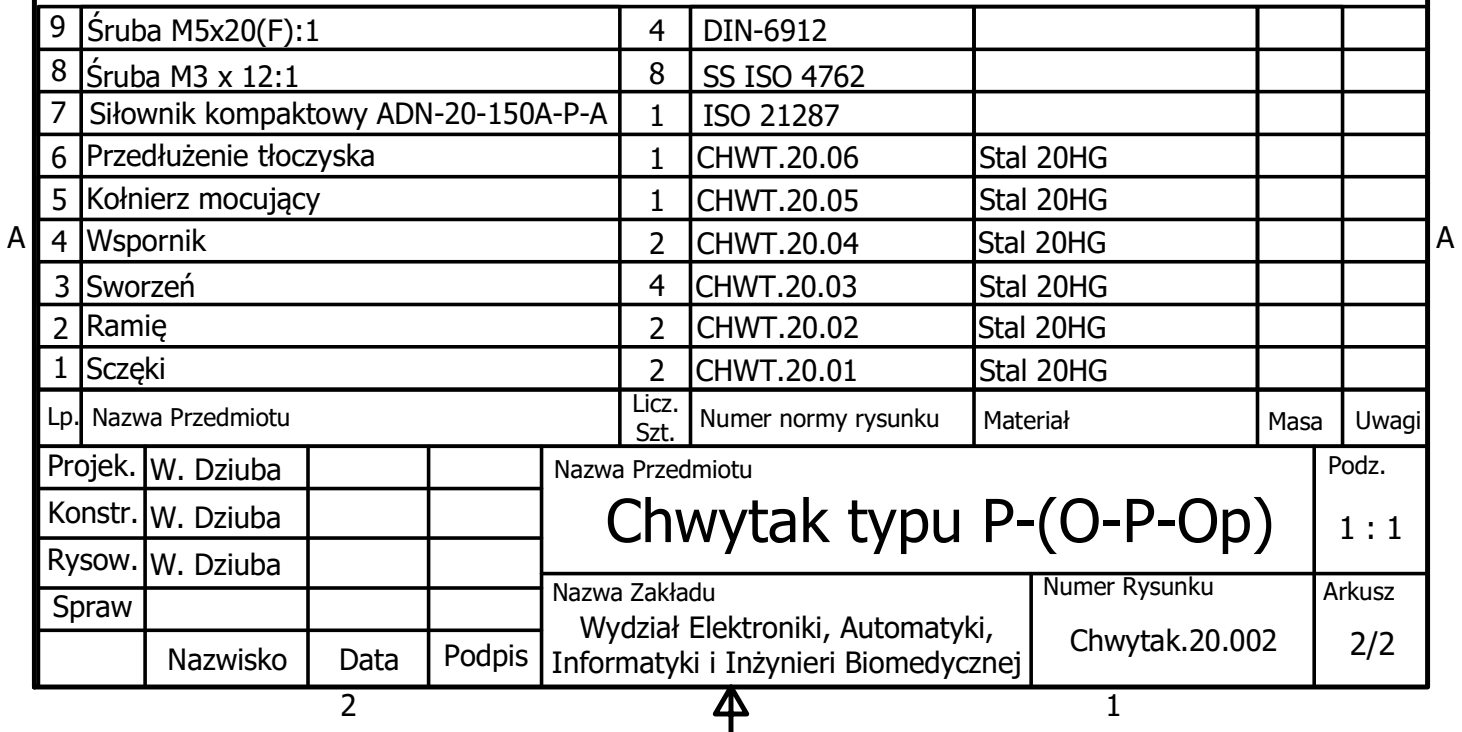
[picture p60: figure]
Projek.; Konstr.; Rysow.; Spraw; Nazwisko; Data; Podpis; Nazwa Zakáadu Wydziaá Elektroniki, Automatyki, Informatyki i Inynieri Biomedycznej; Nazwa Przedmiotu Chwytak typu P-(O-P-Op); Podz.; Numer Rysunku; Chwytak.20.002; Arkusz; Nazwa Przedmiotu; Licz. Szt.; Numer normy rysunku; Materiaá; Masa; Uwagi; Sczki; Rami; Sworze; Wspornik; Koánierz mocujcy; Przedáuenie táoczyska; Siáownik kompaktowy ADN-20-150A-P-A; ruba M3 x 12:1; SS ISO 4762; ruba M5x20(F):1; DIN-6912; ISO 21287; CHWT.20.01; CHWT.20.02; CHWT.20.03; CHWT.20.04; CHWT.20.05; CHWT.20.06; Stal 20HG; W. Dziuba
