WykwalifikowanyProgramista2000/Moj_Chwd_Pytak/Fajne Chwytaki/Projekt chwytaka 2017 numer 10.pdf

# PROJEKT CHWYTAKA

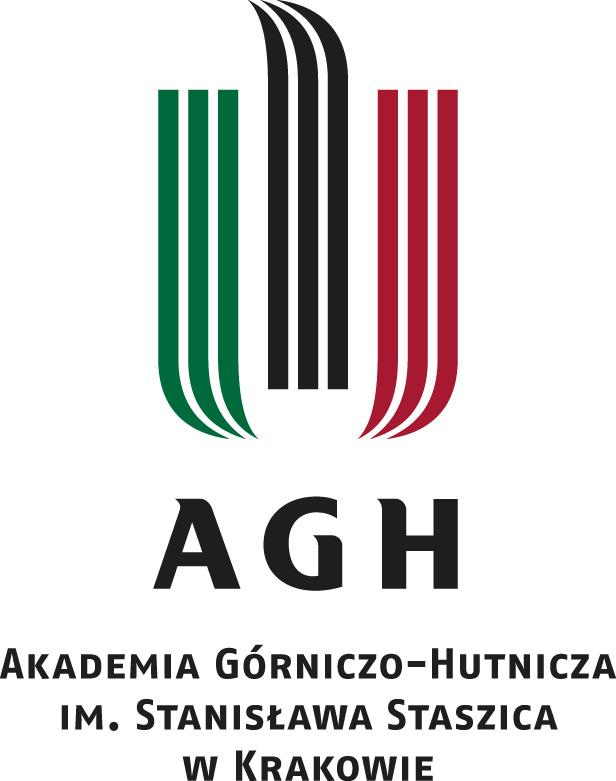
[picture p61: figure]

### PRZYGOTOWAŁA: Zuzanna Gunia

AUTOMATYKA I ROBOTYKA
WEAIIB

### Zapis i Podstawy Konstrukcji. Projekt chwytaka P-(O-O-O)

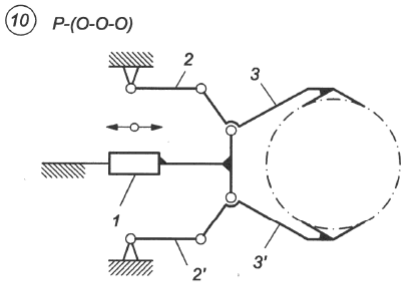
[picture p62: figure]
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

Zaprojektować chwytak do manipulatora przemysłowego wg zadanego schematu kinematycznego spełniający następujące wymagania:

1) w procesie transportu urządzenie chwytające ma za zadanie pobrać (uchwycić) obiekt w położeniu początkowym, trzymać go w trakcie trwania czynności transportowych i uwolnić go w miejscu docelowym,
2) obiektem transportu są wałki ze stali o średnicy d =90mm, długości
l = 100mm ,
3) siłownik chwytaka zasilany jest sprężonym powietrzem o ciśnieniu nominalnym ......pn = 0.6 MP
d) wałki transportowane są w pozycji pionowej.

OBLICZENIE RUCHLIWOŚCI CHWYTAKA NA PODSTAWIE ZADANEGO SCHEMATU KINEMATYCZNEGO

Ruchliwość chwytaka obliczamy ze wzoru ogólnego (dla mechanizmów płaskich):

W = 3n − 2p5 − p4

Gdzie:

n – liczba członów ruchomych,
p5 – liczba par kinematycznych klasy V (obrotowych i postępowych), p4 – liczba par kinematycznych klasy IV (obrotowych i postępowych),

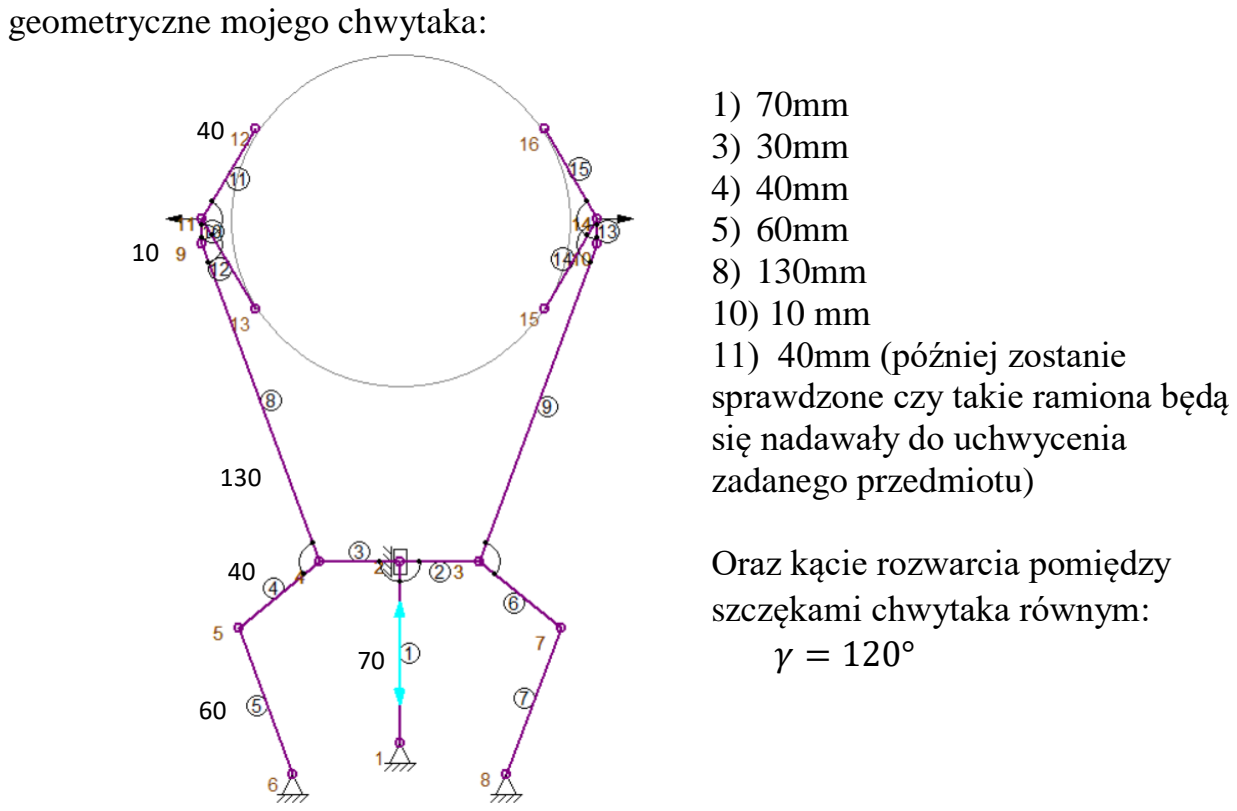
[picture p63: figure]
geometryczne mojego chwytaka:; 1) 70mm 3) 30mm 4) 40mm 5) 60mm 8) 130mm 10) 10 mm 11) 40mm (później zostanie sprawdzone czy takie ramiona będą się nadawały do uchwycenia zadanego przedmiotu); Oraz kącie rozwarcia pomiędzy szczękami chwytaka równym: γ = 120°

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

Dla zadanego schematu kinematycznego mamy:

Człony ruchome:

n = (1),(2),(2’),(3),(3’) = 5

Pary kinematyczne klasy V:

p5 = (0,1),(0,2),(0,2’),(1,3),(1,3’),(2,3),(2’,3’) = 7

Pary kinematyczne klasy IV:

p4 = 0

Podstawiam otrzymane dane do wzoru i wyznaczam ruchliwość chwytaka:

W = 3n − 2p5 − p4 = 3 ∙ 5 − 2 ∙ 7 − 0 = 1

Wniosek: Do napędu chwytaka potrzebować będziemy jednego siłownika pneumatycznego.

ANALIZA ZADANIA PROJEKTOWEGO

### 1. Przyjęcie podstawowych wymiarów elementów chwytaka

Na podstawie analizy chwytaka w programie SAM przyjęłam następujące wymiary

Rys.1. Schemat chwytaka w pozycji maksymalnie rozwartej

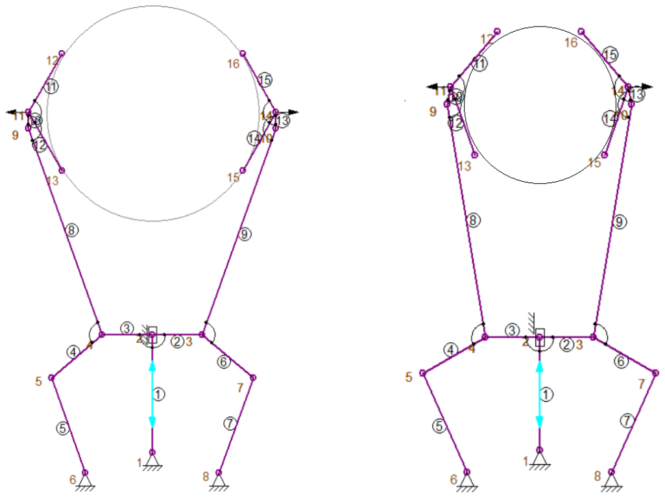
[picture p64: figure]
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

Maksymalny ciężar obiektu transportowanego wyliczam ze wzoru:

Q =

π d

2
4

l γ

gdzie:

d = 0,09 m – średnica wałka l = 0,1 m - wysokość wałka γ = 78300 N
m³

– ciężar właściwy stali

Tak więc po podstawieniu danych otrzymuję ostatecznie:

Q =

3,1415 ∙ (0,09)

2

4

0,1 ∙ 78300 = 49,81 ≅ 50 N

### 2. Wyznaczenie skoku siłownika oraz zakresu rozwarcia szczęk

Rys.2. Pozycja maksymalnie otwarta | Rys.3. Pozycja maksymalnie zamknięta

Przy pomocy programu SAM ustaliłam skok siłownika równy 10mm, oraz sprawdziłam, że

powyższy chwytak będzie mógł przenosić przedmioty o średnicy 90mm, nie osiągając przy

tym swoich skrajnych położeń.

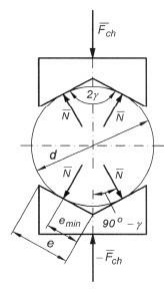
[picture p65: figure]
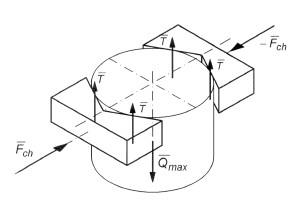
[picture p66: figure]
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

### 3. Wyznaczenie koniecznej siły chwytu i wymiaru szczęk chwytaka

Rys.5 Układ sił działających na chwytak: a) rozkład sił tarcia podczas chwytania obiektu,
b) rozkład sił normalnych podczas chwytania obiektu

b)
a)

Wyznaczanie siły chwytu:

Fcℎ = 2N cos(90° − β) | N =

Fcℎ
2 cos(90° − γ)

=

Fcℎ
2 sinγ

T = μN =

Fcℎ μ
2 sinγ

Aby prawidłowo uchwycić obiekt musi być spełniony poniższy warunek:

Qn

F
T

ch ≥·

- =
γ

µ
sin

2
4

stąd siła chwytu:

µ

γ
2

Qnsin Fch≥

Po podstawieniu danych:

Q = 50 [N] | - wyliczony ciężar wałka
n = 2 | - współczynnik przeciążenia
γ = 60º | - połowa kąta rozwarcia szczęk
μ = 0,15 | - współczynnik tarcia między szczękami chwytaka a obiektem

Otrzymujemy nierówność:

Fcℎ ≥

Qnsinγ
2μ

=

50 ∙ 2 ∙

√3
2
2 ∙ 0,15 = 288,68

Wniosek: Aby zagwarantować pewne uchwycenie obiektu i efektywne nim manipulowanie,

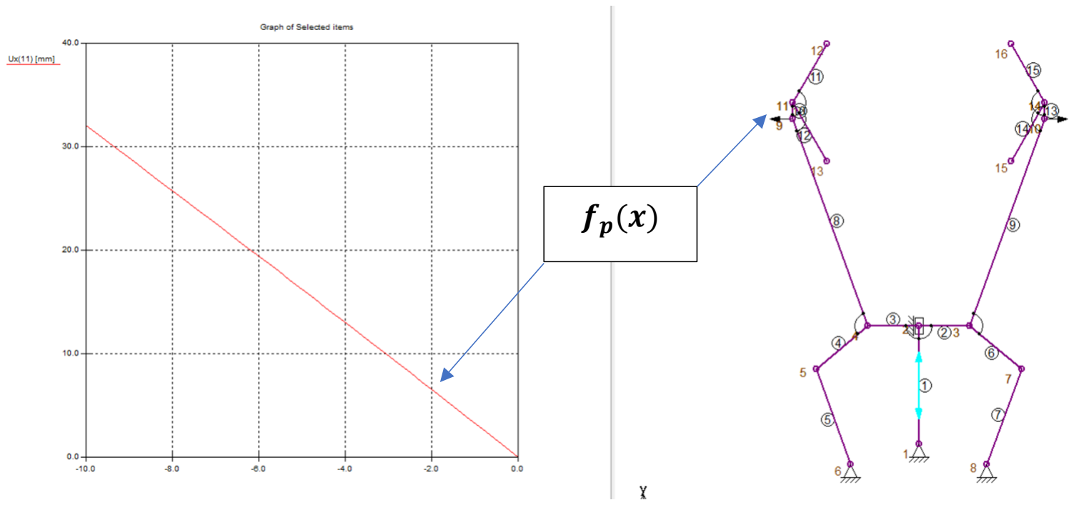
[picture p67: figure]
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

musi być spełniony warunek:

Fcℎ≥ 288,68 [N ]

Dla dalszych obliczeń przyjmuję Fcℎ= 290 N

Wyznaczenie wymiaru szczęki

Dodatkowo do prawidłowego uchwycenia wałka potrzeba tak dobrać wymiary szczęk, aby spełniały warunek:

e > emin =

d
2tgγ

, (wyznaczono z: tgγ =

d

2emin

)

Po podstawieniu danych otrzymujemy e > 25,98mm ≅ 26 mm, a więc przyjęte początkowo wymiary szczęk chwytaka spełniają powyższy warunek.

### 4. Wyznaczanie charakterystyki przemieszczeniowej chwytaka y = fp(x)

Charakterystyka przemieszczeniowa chwytaka została wyznaczona w programie SAM

Rys.5. Charakterystyka przemieszczeniowa chwytaka

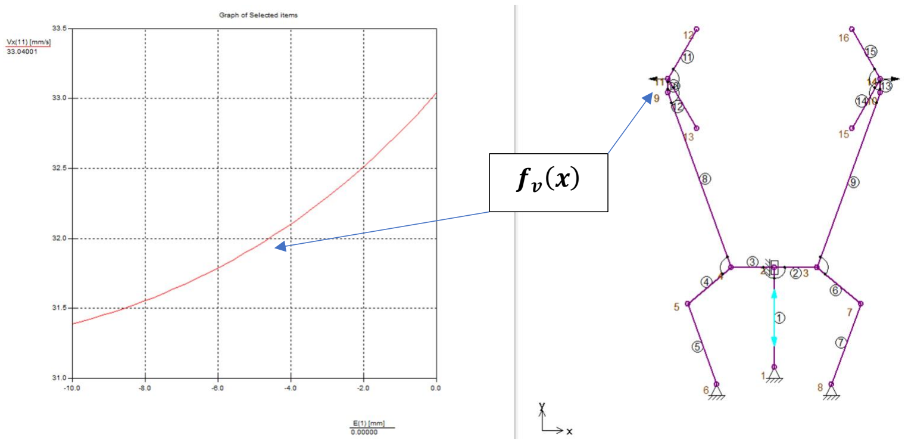
[picture p68: figure]
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

### 5. Wyznaczenie charakterystyki prędkościowej chwytaka fv

(x) =

ẏ
ẋ
W przypadku przyjęcia prędkości członu napędzającego v=1 m/s otrzymamy w programie SAM fv

(x) = ẏ(x)

Rys.6. Charakterystyka prędkościowa chwytaka fv

(x) = ẏ

Analiza wykresu w programie umożliwia wyznaczenie:

fv min = ẏmin = 31.4

mm
s

fv max = ẏmax = 33 mm
s
Oraz w pozycji chwytu:
fv cℎ = ẏcℎ ≈ 31.6

mm
s

### 6. Charakterystyka siłowa chwytaka

Charakterystyka siłowa fF

(x) =

Fcℎ
Fs

gdzie:
Fs − siła na wyjściu zespołu napędowego (siłownika) chwytaka, Fcℎ − siła chwytu,
fF

(x) − przełożenie siłowe mechanizmu chwytaka

Zamiast charakterystyki siłowej zgodnie z powyższym wzorem znacznie prostsze jest sporządzenie charakterystyki siły na członie napędzającym fs

(x) w programie SAM.

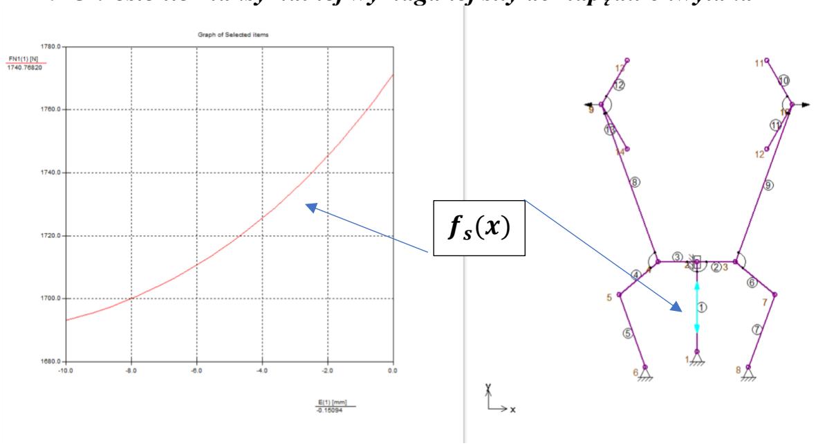
[picture p69: figure]
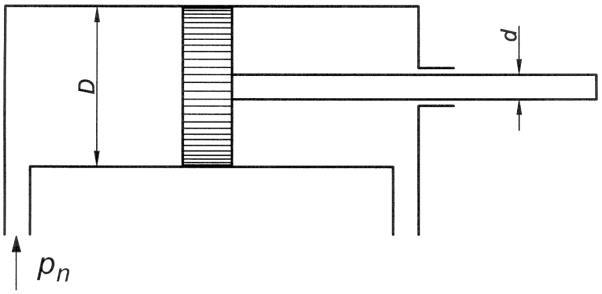
[picture p70: figure]
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

Przy założeniu obciążenia ramion chwytaka symetrycznym układem sił
Fcℎ = 290N otrzymam wymaganą do realizacji zadania projektowego (utrzymania przedmiotu) siłę na siłowniku. Na tej podstawie dobiorę odpowiedni siłownik.

### 7. Określenie maksymalnej wymaganej siły do napędu chwytaka

Rys.7. Charakterystyka siły na członie napędzającym fs(x)

Analiza wykresu w programie umożliwia wyznaczenie:

FS max = 1771 N

Dla wybranej średnicy oraz wysokości przenoszonych walców FS ≈ 1700 N

### 8. Obliczenie średnicy tłoka siłownika napędowego przy założeniu

ciśnienia zasilania pneumatycznego 0,6 MPa

Wymaganą średnicę D tłoka obliczymy przy założeniu Fs = 1700 N

Fs =

πD2
4
pn | Dmin = √
4Fs
| πpn

pn

= 0,6MP

Więc po podstawieniu danych otrzymuję:
Dmin = √
4 ∙ 1700
π ∙ 0,6 ∙ 10⁶ = 0,06 m

Tak więc należy dobrać siłownik o średnicy:
Rys.8 Model siłownika pneumatycznego
D ≥ 60 mm | obustronnego działania

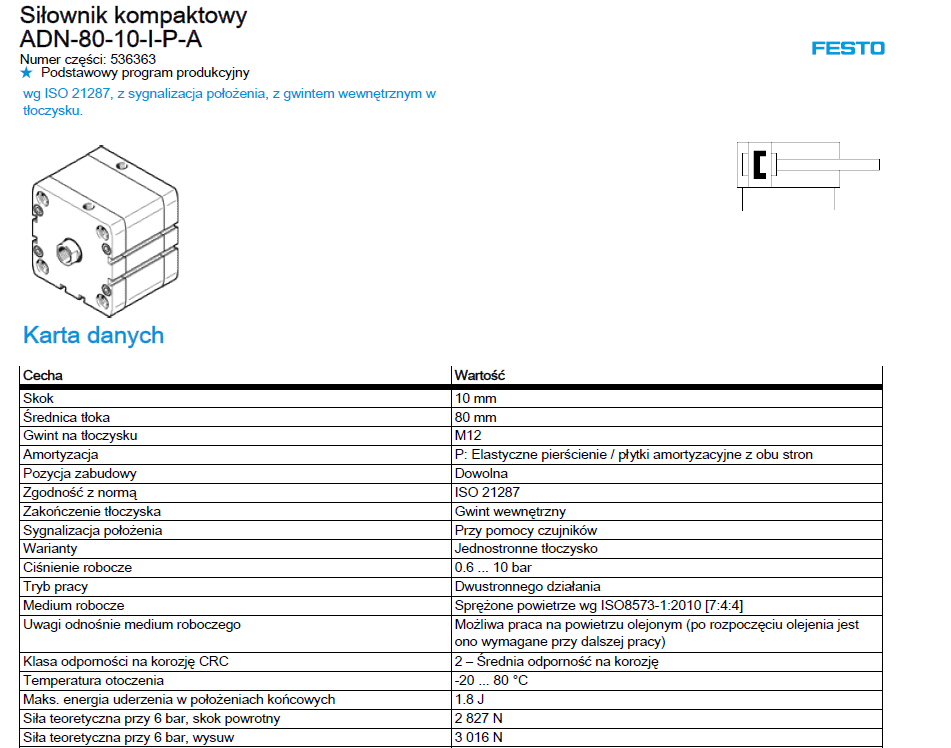
[picture p71: figure]
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

### 9. Dobór siłownika na podstawie wymaganej średnicy tłoka i skoku tłoka

oraz siły pchającej na tłoczysku

Zasada doboru siłownika: Pt ≥ Pw = k ∙ Fs

gdzie:
Pt
- teoretyczna siła pchająca lub ciągnąca siłownika,
k = 1,2 ÷ 1,5 - współczynnik przeciążenia (przyjmuję k=1,25),

Po podstawieniu danych otrzymuję więc:

Pt ≥ Pw = k ∙ Fs = 1,25 ∙ 1700 N = 2125 N

Biorąc pod uwagę otrzymane dane dobieram odpowiedni siłownik z katalogu Festo (www.festo.com). Dobieram siłownik ADN-80-10-I-P-A. o średnicy tłoka D=80 mm i skoku s =10 mm. Dodatkowo dobieram mocowanie kołnierzowe na którym zostanie posadowiony mechanizm chwytaka.

Rys.9 Karta dobranego siłownika

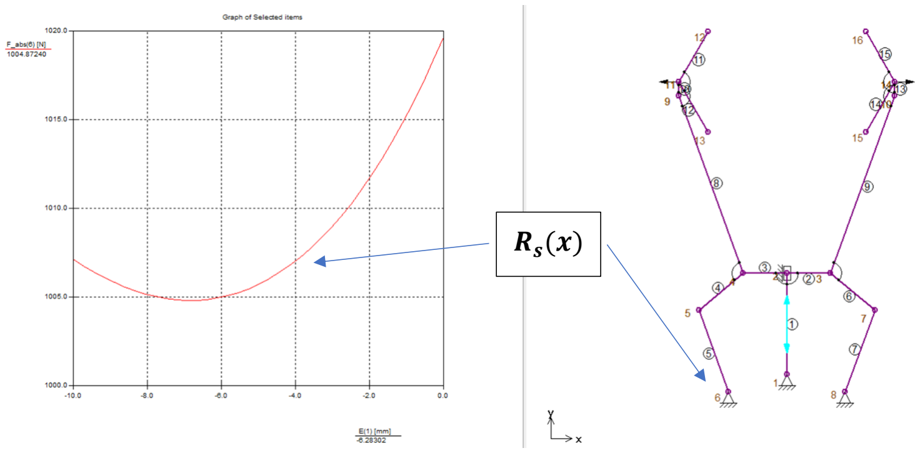
[picture p72: figure]
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

10.Obliczenia sił przyłożonych do elementów konstrukcyjnych chwytaka

Siły wywołujące naprężenia w elementach konstrukcyjnych chwytaka zostały wyznaczone na podstawie modeli w programie SAM.

Rys.10 Charakterystyka siły reakcji Rs

(x) w przegubie chwytaka

Analiza wykresu w programie umożliwia wyznaczenie:

RS max = 1019 N

W pozycji, w której chwytak będzie chwytał wybrany walec RS ≈ 1006 N, co jest wartością bliską wartości minimalnej RS min = 1004 N .

Obliczenia sprawdzające sił reakcji w parach kinematycznych chwytaka

Obliczenia sprawdzające zostały wykonane przy użyciu programu ForceEffect w pozycji chwytu chwytaka.

Analiza chwytaka w programie Force effect wykazała, że wyznaczone przeze mnie w programie SAM siły działające na poszczególne fragmenty konstrukcyjne chwytaka zostały wyznaczone poprawnie. Drobne różnice wynikają z minimalnie niedokładnego rysunku stworzonego w programie Force effect.

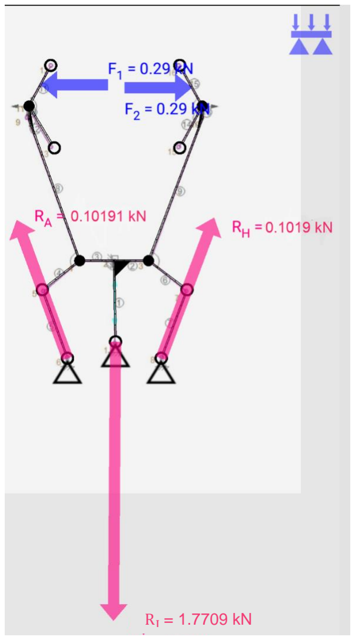
[picture p73: figure]
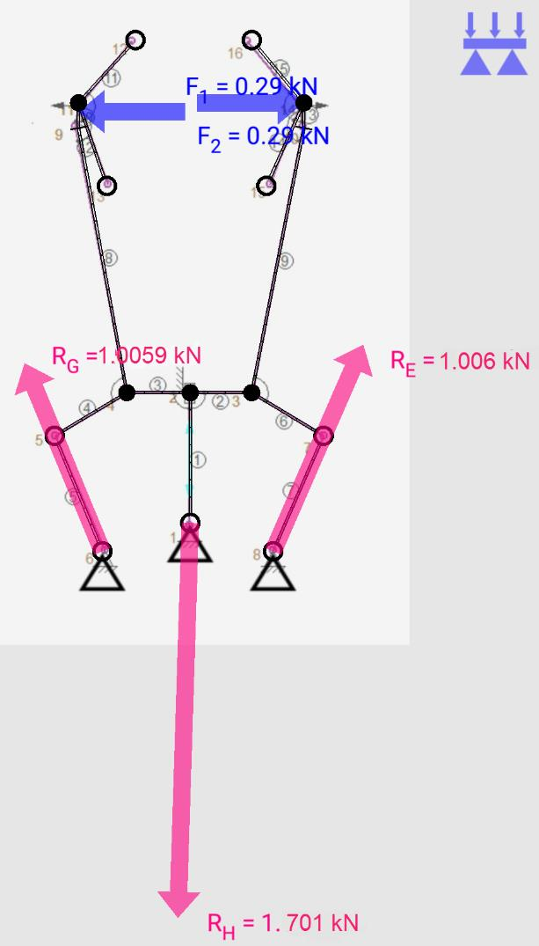
[picture p74: figure]
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

Rys.11 Rozkład sił w chwytaku wyznaczony za pomocą programu Force effect (po lewej dla maksymalnie rozwartych szczęk, po prawej w pozycji chwytu)

OBLICZENIA WYTRZYMAŁOŚCIOWE CHWYTAKA

### 1. Sprawdzenie warunku wytrzymałościowego na zginanie ramion

chwytaka:

Moment gnący ramię wyraża się wzorem:
Mg = r ∙ Fcℎ
gdzie:
r – odległość punktu od końcówki ramienia na którą działa siła Fch

Można zauważyć, że moment gnący jest największy, wtedy kiedy r jest największe - czyli równe długości ramienia. Zatem najbardziej narażonym na uszkodzenia jest miejsce, w którym ramię obraca się na osi. Dodatkowo przekrój w tym miejscu jest pomniejszony o otwór na sworzeń, co osłabia konstrukcję.

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

Zatem w miejscu obrotu ramienia moment gnący wynosi:

Mg = 0,13 ∙ 290 = 37,7 m ∙ N

Jako, że prostokątny przekrój ramienia jest osłabiony otworem na sworzeń o średnicy d=5mm, wzór na wskaźnik wytrzymałości przyjmuje postać:

Wg =

b(ℎ

3 − d

3
)
6h

Znając moment gnący jak i wskaźnik wytrzymałości policzyć można naprężenia normalne występujące w danym miejscu konstrukcji:

σg =

Mg
Wg

Aby spełniony był warunek na zginanie dla ramienia, maksymalne naprężenie musi być mniejsze od dopuszczalnej wytrzymałości na zginanie materiału konstrukcyjnego. W tym przypadku materiałem konstrukcyjnym będzie stal E295 (według normy PN-EN 10277-2:2002). Jej współczynnik wytrzymałości na zginanie wynosi kg =170 [MPa], zatem:

σgmax =

Mg
Wg

=

Mg
b(ℎ

3 − d

3)
6h

< kg

Przyjmijmy w tym miejscu wymiary ramienia i średnicę otworu na sworzeń: b = 15mm
h = 20mm
d = 5mm //średnica sworznia

σgmax =

37,7
(0,015)((0,02)

3 − (0,005)

3)
6(0,02)

[Pa] = 38,3[MPa]

Warunek wytrzymałościowy na zginanie ramienia ma postać:

σgmax < kg

Tak więc po podstawieniu danych otrzymuję

38,3 [MPa] < 170[MPa]

Obliczenia wytrzymałościowe wykazały, że zaproponowana konstrukcja chwytaka spełnia warunki wytrzymałościowe z dużym zapasem wytrzymałości. Oznacza to możliwość przenoszenia wałków o znacznie większej masie.

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

### 2. Sprawdzenie warunku wytrzymałościowego na ścinanie dla najbardziej

obciążonego sworznia:

Pary obrotowe (przeguby) w mechanizmie chwytaka są zrealizowane jako połączenia sworzniowe. Wszystkie sworznie posiadają średnicę d = 5mm.

Na podstawie analizy sił (Rys. 10,11) wiadomo, że największe obciążenie występuje w sworzniu łożyskowym dźwigni ramienia chwytaka i w pozycji chwytu wynosi Rs = 1006N Jako materiał sworzni przyjęto stal C45, o wytrzymałości na ścinanie kt = 130MPa. Każdy sworzeń ścinany jest w dwóch płaszczyznach, a więc:

τmax =

Ft max
2A

=

Rs
2A =

4Rs
2πd

2

Warunek wytrzymałościowy na ścinanie przyjmuje postać:

τmax < kt
gdzie:

Ft max - maksymalna siła tnąca,

kt
- naprężenia dopuszczalne na ścinanie materiału sworznia,

A = 2π

d

2

4

– powierzchnia przekroju sworznia, w przypadku ścinania sworznia w dwóch

płaszczyznach przyjmujemy 2A

d - średnica sworznia

Tak więc w przypadku mojego chwytaka otrzymuję:

τmax =

4Rs
2πd

2 =

4 × 1006
2π(0,005)

2

[Pa] = 25,62[MPa] < kt = 65[MPa]

Z powyższej nierówności wynika, że warunek wytrzymałości na ścinanie został spełniony dla najbardziej narażonego na ścinanie sworznia, można więc stąd wyciągnąć wniosek, że także pozostałe sworznie będą odporne na ścinanie.

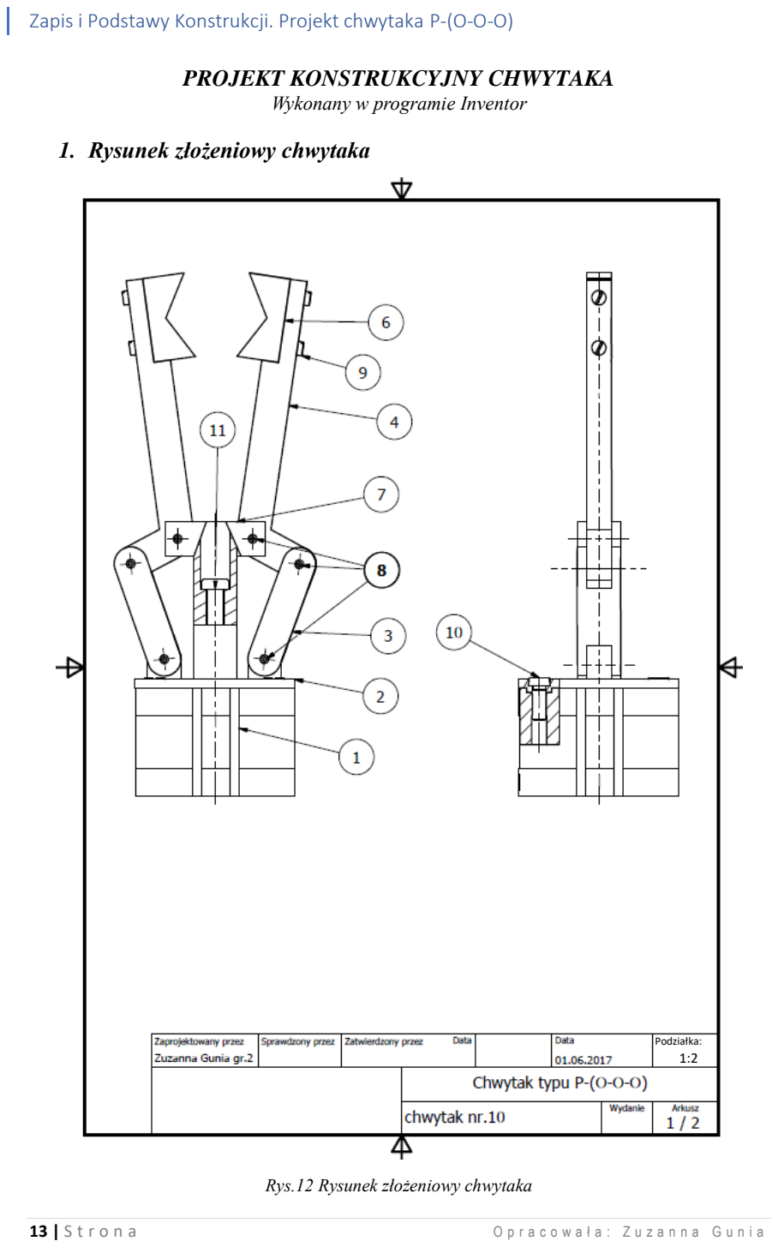
[picture p75: page 14]
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

PROJEKT KONSTRUKCYJNY CHWYTAKA Wykonany w programie Inventor

### 1. Rysunek złożeniowy chwytaka

Rys.12 Rysunek złożeniowy chwytaka

Podziałka:
1:2

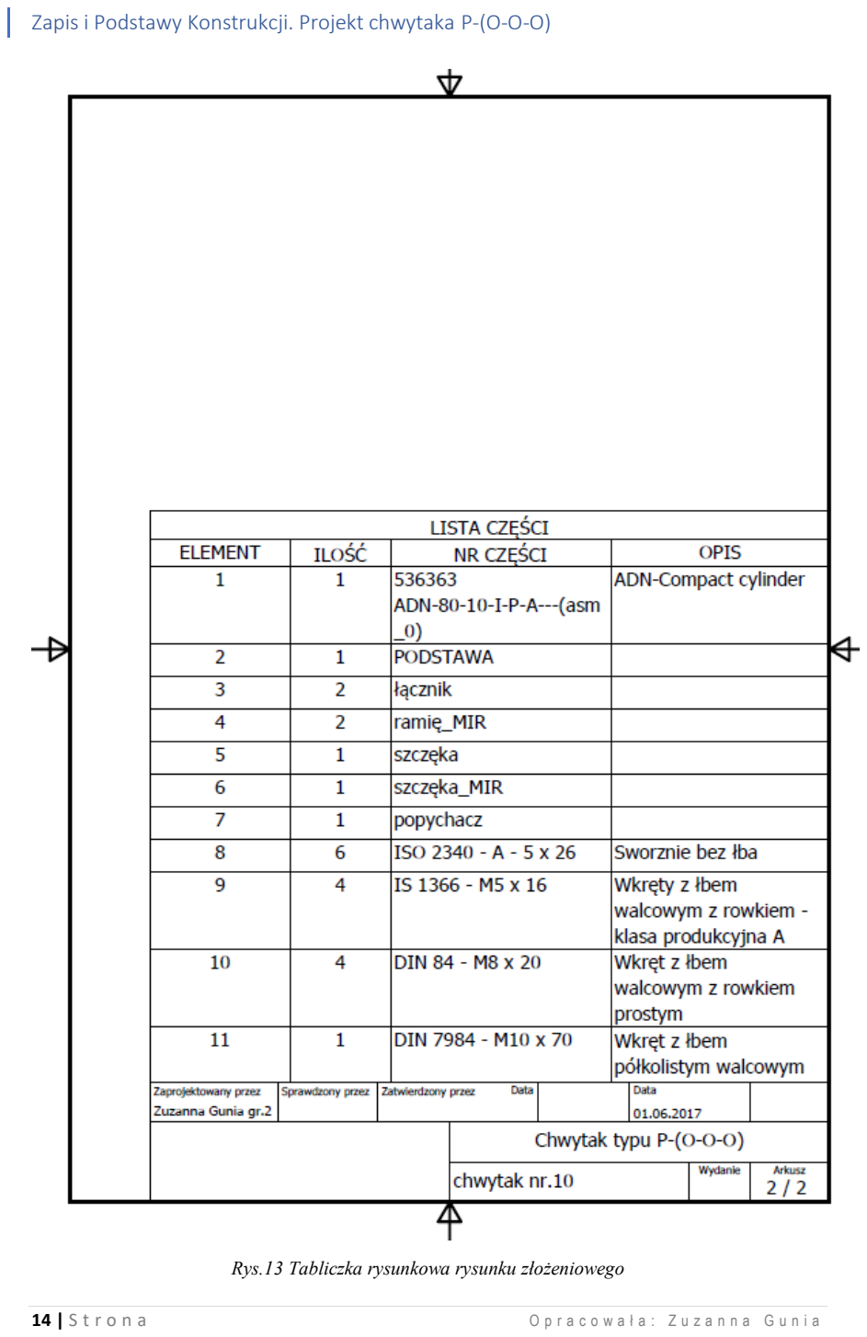
[picture p76: page 15]
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

Rys.13 Tabliczka rysunkowa rysunku złożeniowego

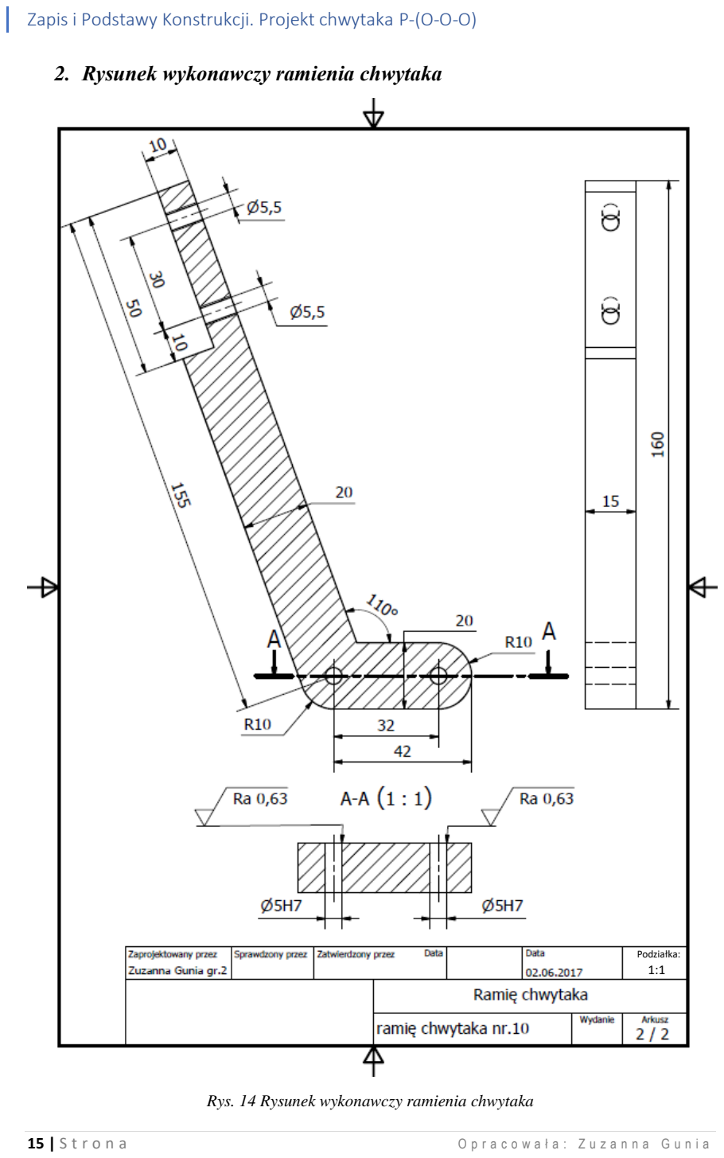
[picture p77: page 16]
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

### 2. Rysunek wykonawczy ramienia chwytaka

Rys. 14 Rysunek wykonawczy ramienia chwytaka

Podziałka:
1:1

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

## UWAGI MARCZUKA:

- aż do projektu konstrukcyjnego nie czepił się chyba niczego
- najbardziej cośtam mu nie pasowało przy wymiarowaniu (polecam robić jak najprostsze to wszystko)
- na rysunku złożeniowym brakuje jakiegoś przekroju połączenia
- ogólnie to tabliczka wygenerowana z Inventora została uznana za tragiczną karygodną i beznadziejną. Trzeba numerować w drugą stronę dorobić kolumny osobno norma osobno numer części osobno nazwa itd.

OCENA: 4.0
