WykwalifikowanyProgramista2000/Moj_Chwd_Pytak/Fajne Chwytaki/chwytak_nr2-caly.pdf

# Projekt chwytaka

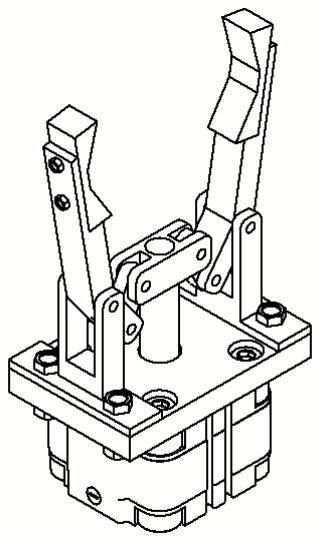
[picture p78: figure]

Dorota Dydo-Rożniecka

Wydział Elektroniki, Automatyki, Informatyki i Inżynierii Biomedycznej

Akademia Górniczo-Hutnicza w Krakowie

2016/2017

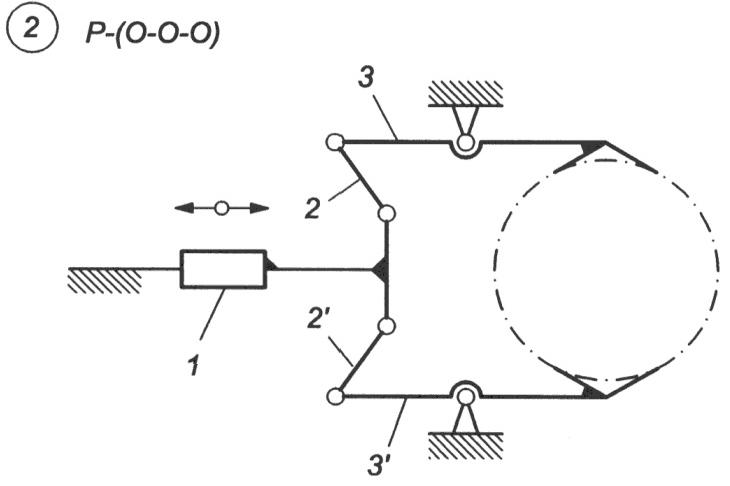
[picture p79: figure]

Projekt Chwytaka, Dorota Dydo-Rożniecka

I. Ogólne zasady zaprojektowanego chwytaka:
- urządzenie zostało zaprojektowane na podstawie schematu z Rys. 1.
- obiektem transportowym są wałki ustawione w pozycji pionowej o zakresie średnic
i długości | .
- urządzenie ma za zadanie uchwycić przedmiot w pozycji początkowej, utrzymać je podczas zmiany położenia oraz pozostawić go w miejscu końcowym

Rys. 1. Schemat kinematyczny chwytaka

II. | Obliczanie ruchliwości chwytaka
5; | ; | ;
Po podstawieniu do wzoru otrzymujemy ruchliwość mechanizmu | . Oznacza to,
że do napędzania mechanizmu wystarczy użyć jednego członu napędzającego.

III. Modelowanie schematu kinematycznego, przyjmowanie wymiarów oraz skoku członu napędowego

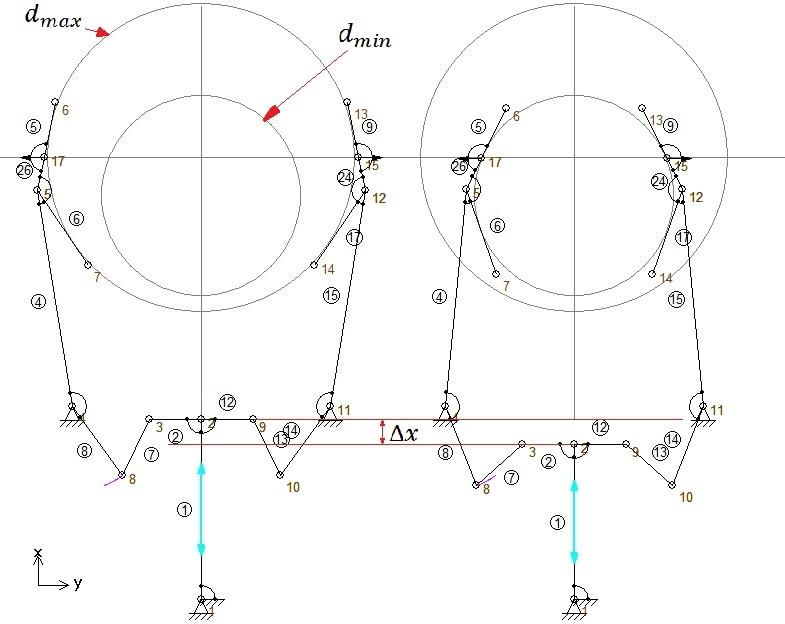
[picture p80: figure]

a) b)

Rys. 2. Model chwytaka w programie SAM. Dwa skrajne położenia przy przyjętym skoku
członu napędzającego | =10mm a) dla maksymalnego rozwarcia szczęk | =60 mm; b)dla
minimalnego rozwarcia szczęk | = 39 mm.
IV. | Wyznaczanie koniecznej siły chwytu do podniesienia wałków o przyjętych wymiarach.

Maksymalny ciężar przedmiotu stalowego przedmiotu obliczono ze wzoru:

Gdzie:

- maksymalna długość przedmiotu o maksymalnej średnicy | ;
– przybliżona gęstość stali;

– przyśpieszenie ziemskie;

Siłę potrzebną do uchwytu przedmiotu o ciężarze obliczono w następujący sposób, korzystając z danych:

– współczynnik tarcia wstępującego między szczękami i przedmiotem stalowym

– współczynnik przeciążenia chwytaka wynikający z uwzględnienia siły bezwładności przy przenoszeniu przedmiotu z pewnym przyspieszeniem (zakładamy maksymalne przyspieszenie przy przenoszeniu równe przyśpieszeniu ziemskiemu)

- kąt rozwarcia szczęk chwytaka, dane odczytane z programu SAM.

Pozycję transportowania przedmiotu ilistruje Rys. 3.

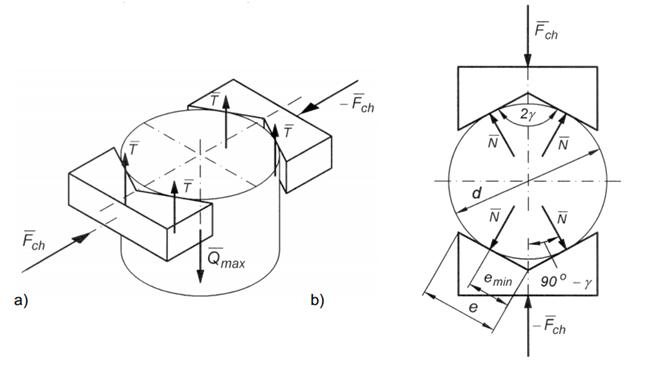
[picture p81: figure]

Rys. 3. Zobrazowanie sił działających na chwytak podczas chwytania przedmiotu: a) rozkład sił tarcia; b) rozkład sił normalnych.

Aby prawidłowo uchwycić przedmiot musi być spełniony warunek:

Stąd wyznaczamy warunek na siłę chwytu:

Dla pozycji początkowej a) warunek wygląda następująco:

V. Charakterystyka przemieszczeniowa

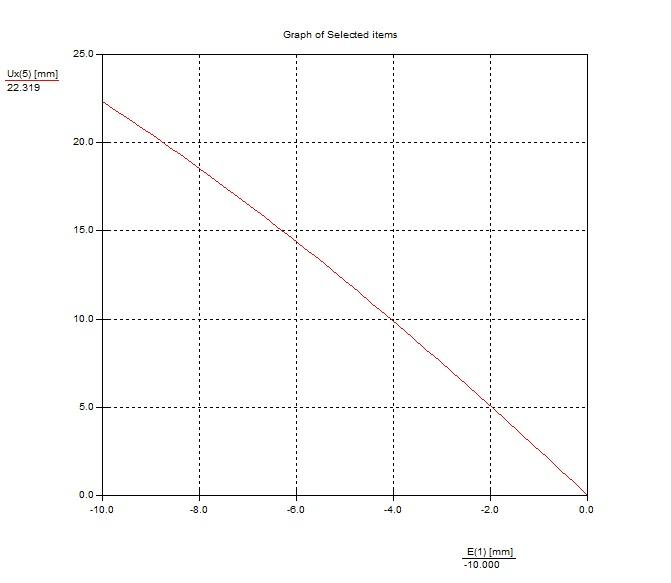
[picture p82: figure]

Wykres 1. Charakterystyka przemieszczeniowa wykonana w programie SAM, na podstawie punktu nr 5 w kierunku osi Y (Rys. 2).

VI. Charakterystyka prędkościowa chwytaka

W przypadku przyjęcia prędkości członu napędzającego

otrzymano w programie
SAM wykres:

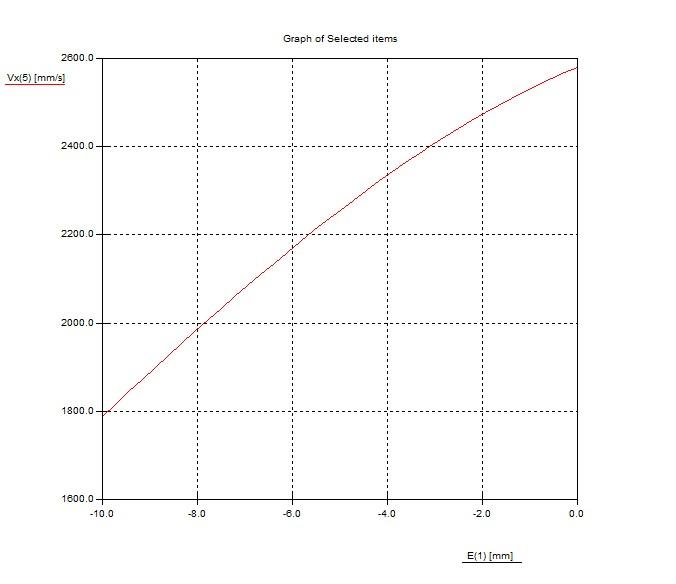
[picture p83: figure]

Wykres 2. Charakterystyka prędkościowa chwytaka

Odczytane wartości prędkości maksymalnej i minimalnej:

,

VII. Charakterystyka siłowa chwytaka

Charakterystyka siłowa

Gdzie:
– siła na wyjściu siłownik napędzającego chwytak,
| – siła chwytu, – przełożenie siłowe mechanizmu chwytaka.

Zamiast wyznaczenia charakterystyki siłowej wyznaczono charakterystykę siły na siłowniku
w programie SAM. Przy założeniu | otrzymano w programie SAM siłę na
siłowniku, na podstawie której dobrano siłownik.

VIII. Dobór siłownika

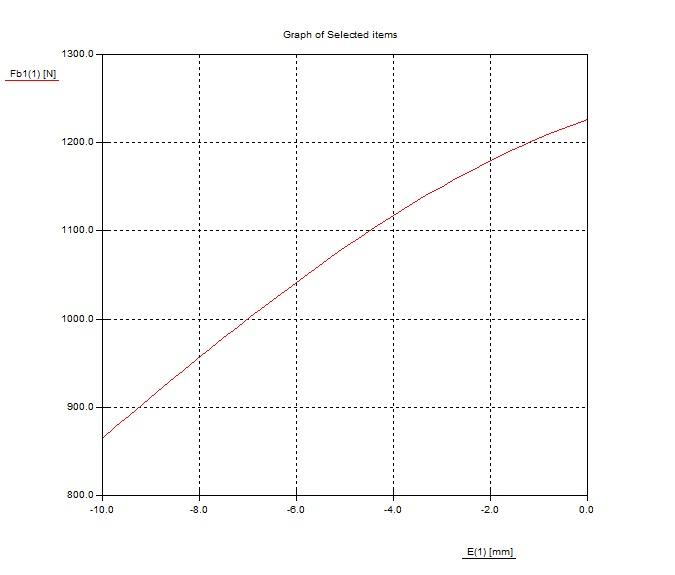
[picture p84: figure]

Wykres 3. Charakterystyka siły na siłowniku chwytaka.

Z wykresu odczytano w programie siłę maksymalną otrzymaną na członie napędzającym:

Średnicę tłoka siłownika wyznaczono
z wzoru:

, stąd

Gdzie:
– ciśnienie używane w
siłownikach

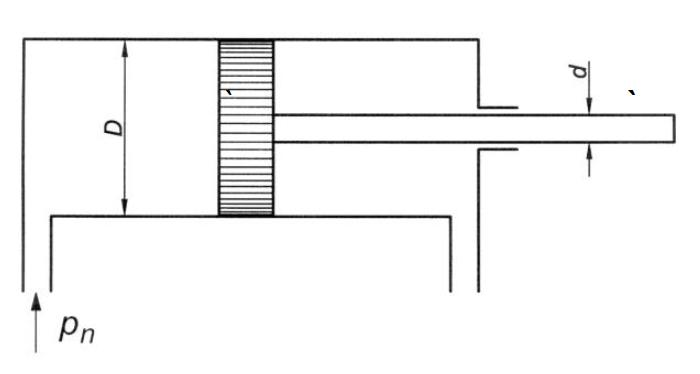
[picture p85: figure]

- siła maksymalna na siłowniku

Zasada doboru siłownika:

Gdzie:
-teoretyczna siła ciągnąca siłownika,
- obliczona wymagana siła na tłoczysku – współczynnik przeciążenia (przyjęto 1,2)

Po podstawieniu otrzymano:

Do wzoru na

zamiast | użyto siły przemnożonej przez współczynnik przeciążenia

Na podstawie obliczeń dobrano za pomocą strony festo.pl siłownik AEVULQZ-63-10-P-A
o średnicy tłoka | i skoku | oraz mocowanie kołnierzowe FUA-63 do
przymocowania części chwytaka do siłownika.

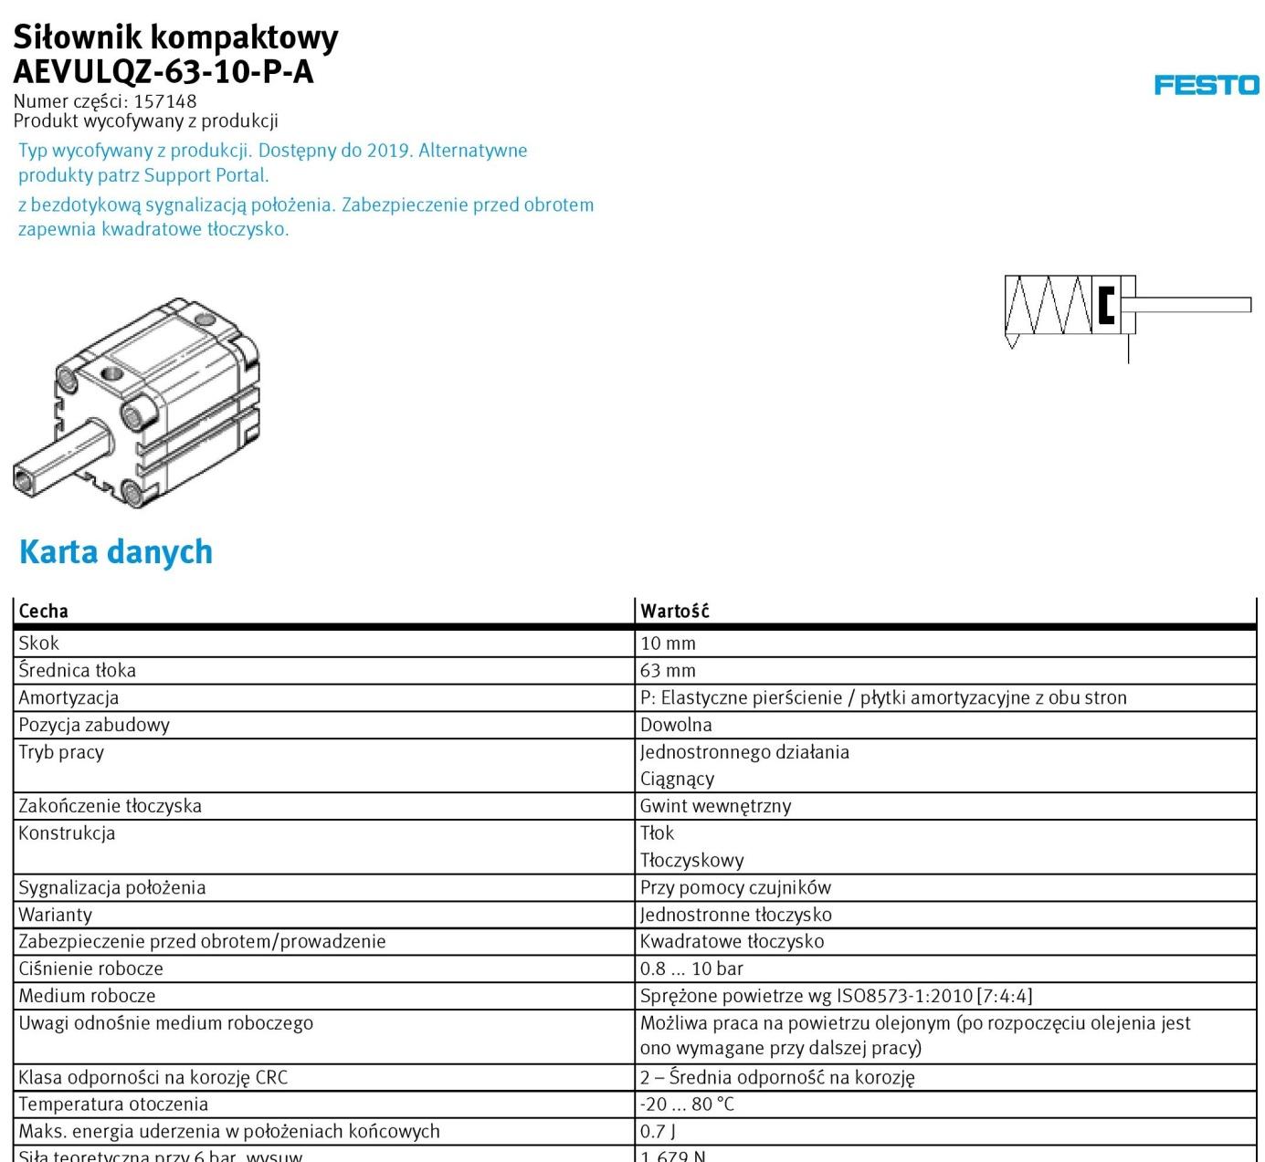
[picture p86: figure]
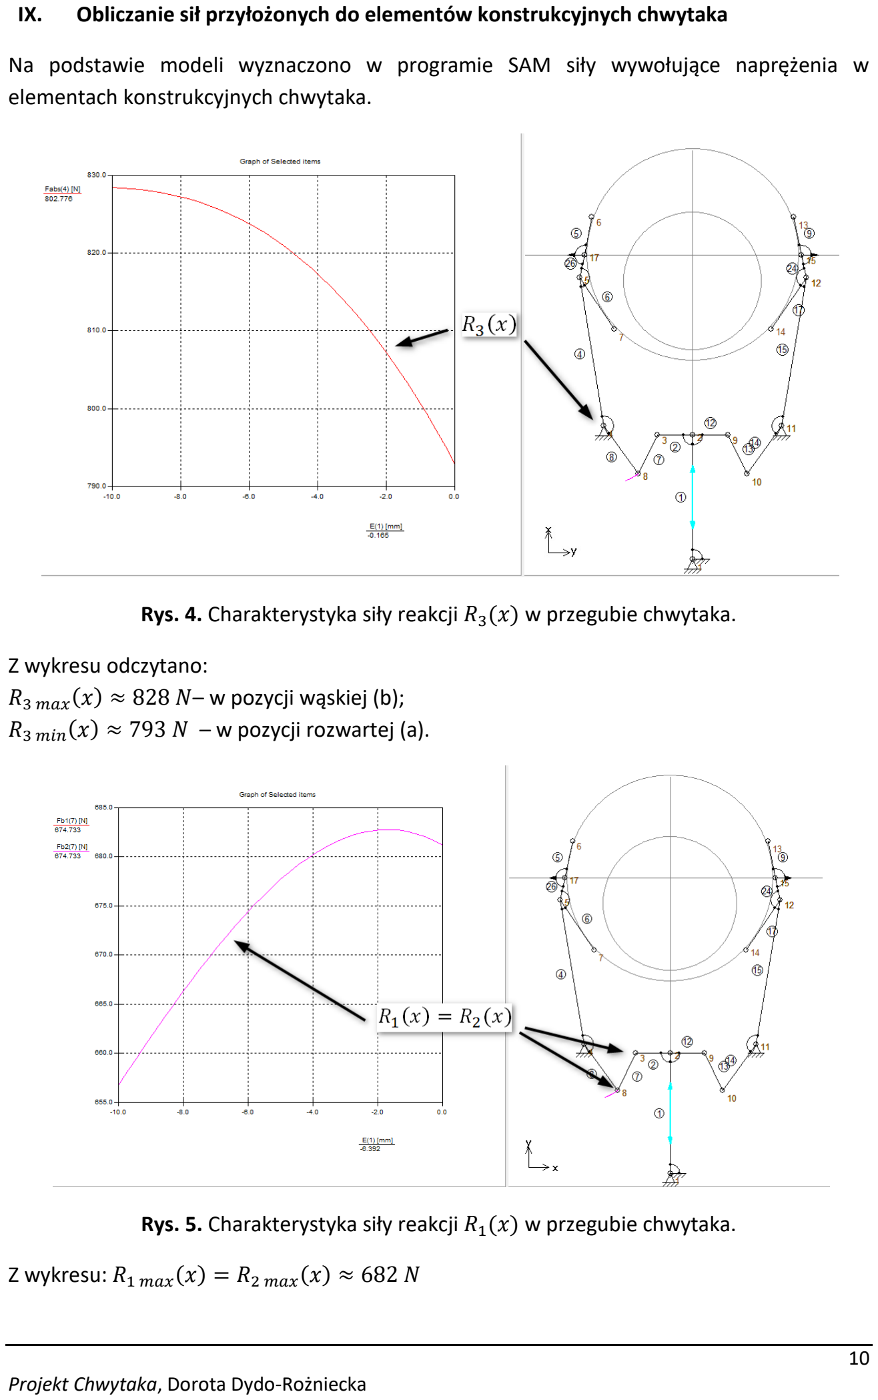
[picture p87: page 10]

IX. Obliczanie sił przyłożonych do elementów konstrukcyjnych chwytaka

Na podstawie modeli wyznaczono w programie SAM siły wywołujące naprężenia w elementach konstrukcyjnych chwytaka.

Rys. 4. Charakterystyka siły reakcji w przegubie chwytaka.

Z wykresu odczytano:
– w pozycji wąskiej (b);
– w pozycji rozwartej (a).

Rys. 5. Charakterystyka siły reakcji w przegubie chwytaka.

Z wykresu:

W programie ForceEffect wykonano obliczenia sprawdzające dla chwytaka w pozycji rozwartej.

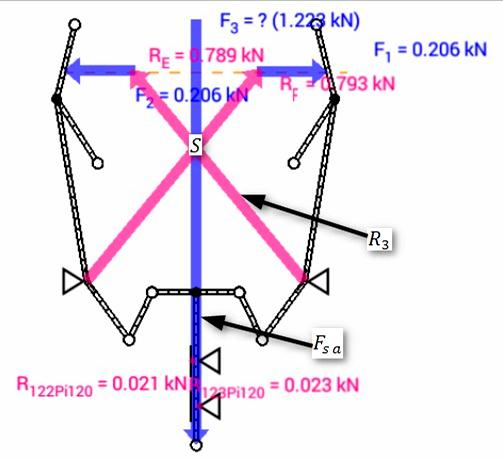
[picture p88: figure]

Rys. 6. Siły reakcji siły

Do ramienia został przyłożony układ trzech sił | . Kierunki tych sił przecinają się w
jednym punkcie . Oznacza to, że zostało spełnione jedno z najważniejszych praw mechaniki.

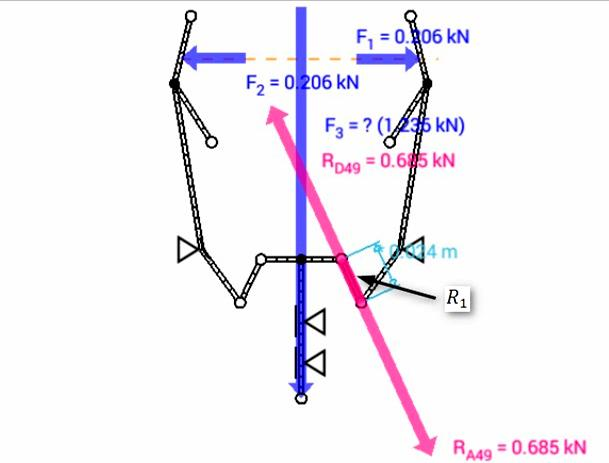
[picture p89: figure]

Rys. 7. Siły reakcji siły

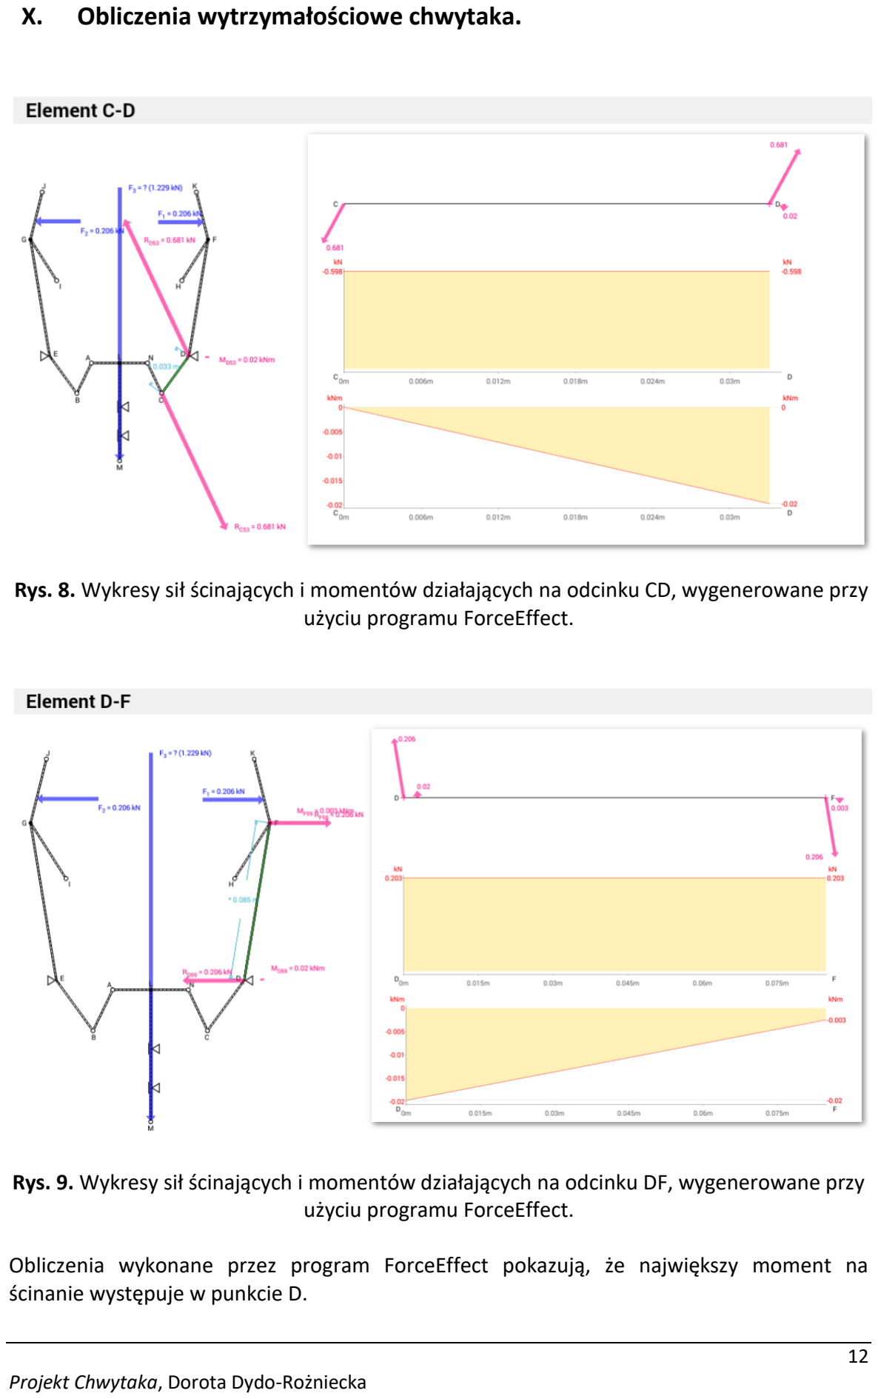
[picture p90: page 12]

X. Obliczenia wytrzymałościowe chwytaka.

Rys. 8. Wykresy sił ścinających i momentów działających na odcinku CD, wygenerowane przy użyciu programu ForceEffect.

Rys. 9. Wykresy sił ścinających i momentów działających na odcinku DF, wygenerowane przy użyciu programu ForceEffect.

Obliczenia wykonane przez program ForceEffect pokazują, że największy moment na ścinanie występuje w punkcie D.

Sprawdzenie warunku wytrzymałościowego na ścinanie dla najbardziej obciążonego sworznia
- Pary obrotowe (przeguby) w mechanizmie chwytaka są zrealizowane jako połączenia
sworzniowe. Wszystkie sworznie posiadają średnicę | .
- Na podstawie analizy sił (Rys 3, 4) wiadomo, że największe obciążenie występuje w
sworzniu łożyskowym dźwigni ramienia chwytaka i wynosi: | .
- Wybrano sworznie ze stali St5 o wytrzymałości na zginanie równej | . Warto
zaznaczyć, że każdy sworzeń jest ścinany w dwóch płaszczyznach.

Warunek wytrzymałościowy sworznia:

Gdzie:
- naprężenia ścinające;
– maksymalna siła poprzeczna tnąca;
- przekrój poprzeczny;
- średnica sworznia;
- naprężenia dopuszczalne na ścinanie.

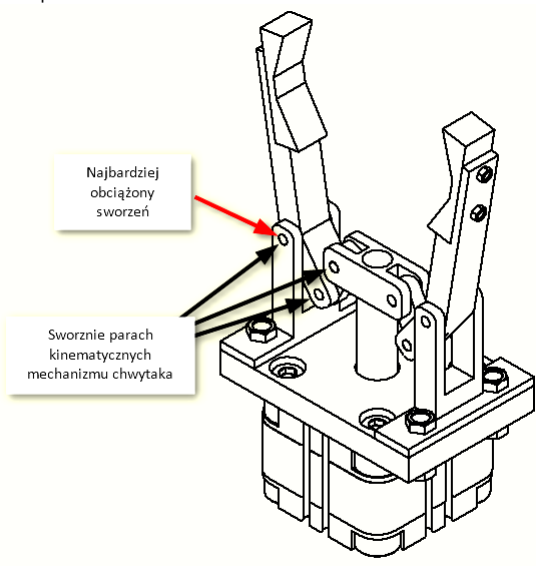
[picture p91: figure]

Rys. 10. Wskazanie sworzni w mechanizmie chwytaka.

Sprawdzenie warunku wytrzymałościowego na zginanie ramion chwytaka
Do sprawdzenia warunku wytrzymałościowego ramię chwytaka potraktowano jako belkę podpartą w dwóch punktach (przegubach) i obciążoną na końcu siłą . Rozpatrzymy położenie chwytaka w poz. a)(rys.2). W tym przypadku maksymalny moment gnący w ramieniu chwytaka występuje w przekroju A-A (rys. 7)

Moment gnący w przekroju A-A obliczymy ze wzoru:

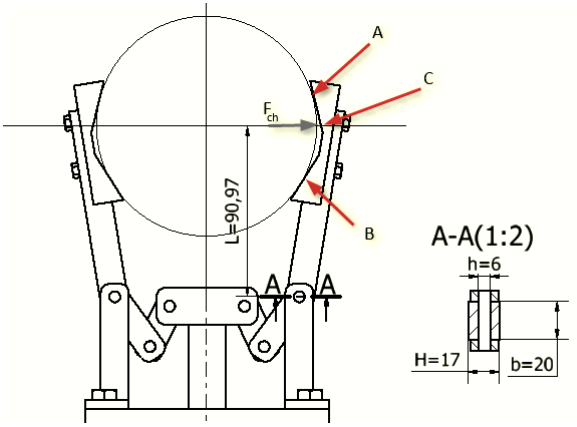
[picture p92: figure]

Rys.11. Model obliczeniowy ramienia chwytaka na zginanie. A, B - rzeczywiste miejsca, C -teoretyczny punkt przyłożenia siły chwytu.

Warunek wytrzymałościowy na zginanie ramienia chwytaka:

Gdzie:
– moment gnący;
– wskaźnik wytrzymałości przekroju na zginanie;
– wytrzymałość materiału na zginanie.

Jako materiał do wyrobu ramienia chwytaka wybrano stop aluminium PA6 (inne oznaczenia:
AlCu4MgSi (A), EN AW-2017A) o wytrzymałości na zginanie | .

Wskaźnik przekroju belki z uwzględnieniem otworu na sworzeń obliczono ze wzoru:

Moment gnący wyliczono ze wzoru:

90,97 mm

Powyższe obliczenia pokazują, że zaprojektowana konstrukcja chwytaka spełnia warunki wytrzymałościowe z dużym zapasem wytrzymałości. Oznacza to możliwość przenoszenia wałków o większej masie. Jest to możliwe dla wałków o mniejszej średnicy o odpowiednio większej długości.

Obliczanie maksymalnej możliwej siły uchwytu oraz maksymalnego ciężaru transportowanych przedmiotów.

Bilans mocy przy pominięciu tarcia, sił ciężkości i bezwładności jego elementów:

Gdzie: | F x S
·
- , | F | y ch 2 | ·

FS

- x
+ 2Fch
- y
= 0

, stąd
FS
- x
- - 2Fch
- y
= 0

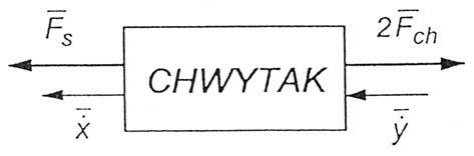
[picture p93: figure]

Rys. 12. Model chwytaka do wyznaczenia bilansu mocy chwilowych.

Na podstawie ostatniego wzoru oraz skorzystaniu z charakterystyki prędkościowej wyznaczono charakterystykę siłową.

Z Wykresu 3. za konieczną siłę siłownika napędowego przyjmujemy: | .

Kolejne obliczenia przeprowadzono dla pozycji chwytaka przy minimalnym rozwarciu szczęk (poz. b) rys. 2.).

Dla

,

(z Wykresu 2.)

–ramię zginania odczytano z programu SAM, dla pozycji b) z Rys. 2.

Można zauważyć, że również w tym przypadku naprężenia zginające ramię chwytaka są mniejsze od dopuszczalnych.

Obliczono maksymalny ciężar jaki można uchwycić za pomocą dobranego siłownika w pozycji
b) z Rys. 2.
Wówczas dla wałka o średnicy | maksymalna długość wynosi:
XI. | Projekt konstrukcyjny chwytaka P(O-O-O)

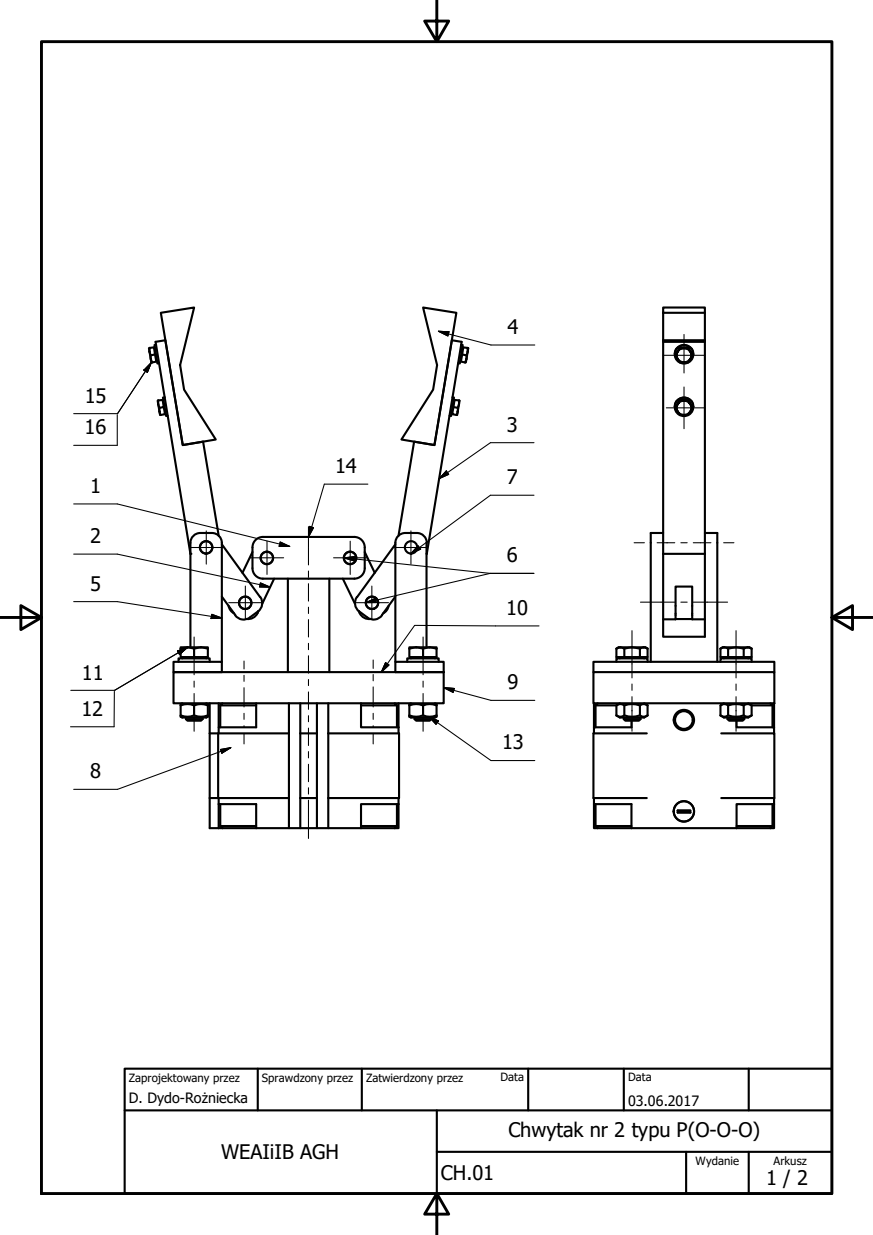
[picture p94: page 17]
WEAIiIB AGH; D. Dydo-Roniecka; Zaprojektowany przez; Sprawdzony przez; Zatwierdzony przez; Data; Wydanie; Arkusz

Chwytak nr 2 typu P(O-O-O)

Chwytak nr 2 typu P(O-O-O)

CH.01

WEAIiIB AGH

D. Dydo-Roniecka | 03.06.2017
Zaprojektowany przez | Sprawdzony przez | Zatwierdzony przez | Data

2 / 2

Wydanie | Arkusz

Data

16. | Podkáadka 4,3 | 4 | DIN 125 1-A
15. | ruba M4x8 | 4 | DIN EN 24017
14. | ruba M6x20 | 1 | DIN EN ISO 4762
13. | Podkáadka 8,4 | 4 | DIN 433-1A
12. | Nakrtka M8 | 4 | DIN 28673
11. | ruba M8x30 | 4 | DIN EN 24017
10. | ruba M10x30 | 4 | DIN-6912
9. | Koánierz mocujcy FUA-63 | 1 | festo.pl
8. | Siáownik AEVULQZ-63-10-P-A | 1 | festo.pl
7. | Sworze 2 | 2 | CH.01.07 | St5
6. | Sworze 1 | 4 | CH.01.06 | St5
5. | Wspornik | 2 | CH.01.05 | PA6
4. | Szczka | 2 | CH.01.04 | PA6
3. | Rami chwytaka | 2 | CH.01.03 | PA6
2. | Cigno | 2 | CH.01.02 | PA6
1. | Przedáuenie táoczyska z belk | 1 | CH.01.01 | PA6

Lista czci

Lp. | Nazwa przedmiotu

Licz.
szt.

Nr normy rysunku Materiaá Uwagi

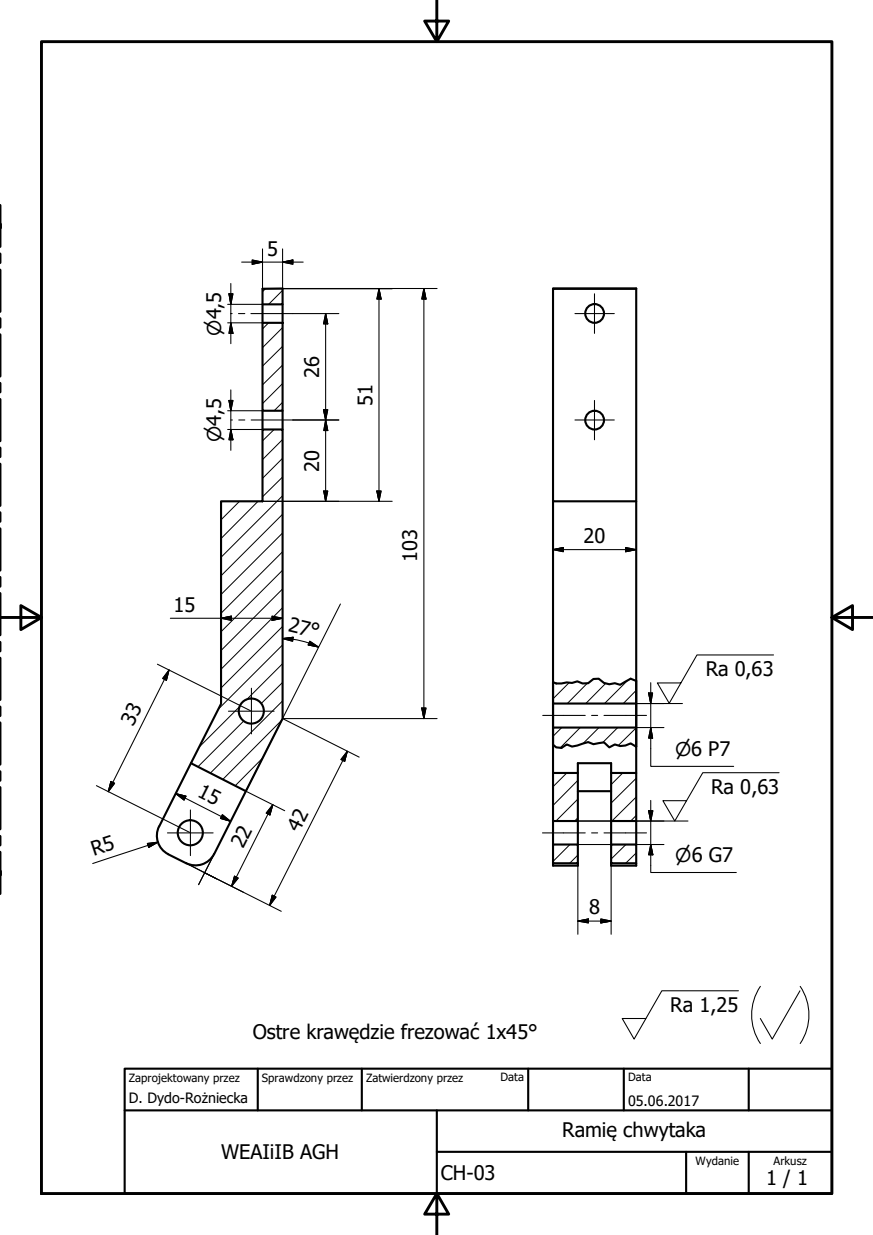
[picture p95: page 19]
Rami chwytaka; WEAIiIB AGH; D. Dydo-Roniecka; Zaprojektowany przez; Sprawdzony przez; Zatwierdzony przez; Data; Wydanie; Arkusz

Ostre krawdzie frezowaü 1x45°
