WykwalifikowanyProgramista2000/Moj_Chwd_Pytak/Fajne Chwytaki/Instrukcja wykonania chwytaka.pdf

Zapis i Podstawy Konstrukcji | Projekt techniczny chwytaka
Opracowali: H. Jaworowski, J. Felis | Strona | 1

PROJEKT TECHNICZNY CHWYTAKA

ZADANIE PROJEKTOWE: Zaprojektować chwytak do manipulatora przemysłowego wg zadanego schematu kinematycznego spełniający następujące wymagania:
a) w procesie transportu urządzenie chwytające ma za zadanie pobrać (uchwycić) obiekt w położeniu początkowym, trzymać go w trakcie trwania czynności transportowych
i uwolnić go w miejscu docelowym,
b) obiektem transportu są wałki i tuleje o zakresie średnic d =10 ÷100mm , długości
l = 20 ÷ 200mm z mosiądzu lub stali,
c) manipulator zasilany jest sprężonym powietrzem o ciśnieniu nominalnym
pn = 0,6 MPa .

Uwaga: Zakres zadania projektowego oraz przykład rozwiązania zostanie przedstawiony z obszernymi komentarzami pisanymi kursywą. Komentarzy tych nie należy przepisywać we własnym rozwiązaniu.

ZAKRES PROJEKTU

### 1. Obliczenie ruchliwości chwytaka na podstawie zadanego schematu

kinematycznego.

Wyznaczona ruchliwość chwytaka Ñwî (wzÛr 1) określa liczbę niezależnych koniecznych napędÛw chwytaka. W przypadku gdy w=1, napęd chwytaka jest realizowany za pomocą jednego silnika o ruchu liniowym lub obrotowym. W rozwiązywanym zadaniu projektowym zakładamy, że silnikiem napędowym będzie siłownik pneumatyczny.

### 2. Analiza zadania projektowego, ustalenie listy wymagań oraz przyjęcie modelu

obliczeniowego chwytaka.
a) wyznaczanie skoku siłownika, wymiarÛw elementÛw chwytaka, zakresu szczęk chwytaka oraz wymiarÛw i ciężaru obiektu manipulacji
Zadany schemat kinematyczny chwytaka należy narysować | w podziałce 1:1
na arkuszu formatu A4 lub A3 . Zakładając maksymalny skok | max | min ∆x = x | − x | tłoczyska
siłownika pneumatycznego oraz przyjmując wstępnie wymiary członÛw oznaczonych na schemacie kinematycznym, należy narysować ten schemat w dwÛch skrajnych położeniach, ktÛre określają zarazem minimalne i maksymalne rozwarcie końcÛwek chwytnych. Na tej podstawie możemy określić zakres rozwarcia szczęk chwytaka ∆y = 2( ymax − ymin ), i ustalić minimalne i maksymalne wymiary chwytanego obiektu. Należy przyjąć, że obiektem chwytanym jest wałek o przekroju kołowym. Jeżeli zakres przemieszczenia szczęk chwytaka uznamy za niewystarczający, należy zmienić wymiary członÛw oraz skok siłownika.
Po ostatecznym ustaleniu wymiarÛw możliwe jest określenie maksymalnej średnicy obiektu chwytanego dmax i na tej podstawie jego maksymalnego ciężaru Qmax (wzÛr 2).
b) wyznaczenie maksymalnej koniecznej siły chwytu Fch max i obliczenie wymiarÛw szczęki,
Wyznaczenie maksymalnej siły chwytu powinna poprzedzić analiza sposobu uchwycenia. W rozwiązywanym zadaniu projektowym przyjmiemy siłowy sposÛb uchwycenia przedmiotu. SposÛb ten polega na wywarciu odpowiedniego nacisku normalnego na transportowany obiekt, gwarantującego przeniesienie obiektu przy pomocy siły tarcia spełniającej warunek T > Qmax . Przy takim uchwyceniu obiektu decydujące znaczenie ma siła normalna N nacisku szczęk na obiekt oraz wspÛłczynnik tarcia µ wspÛłpracujących powierzchni, tzn. powierzchni szczęk chwytaka i obiektu transportowanego. Po określeniu siły normalnej obliczymy następnie maksymalną konieczną siłę chwytu Fch max (wzÛr 3).
Wstępny dobÛr geometrii chwytaka zakończymy wyznaczając wymiar Ñeî dla szczęki spełniający warunek e > emin (wzÛr 4). Spełnienie tego warunku gwarantuje prawidłowe uchwycenie szczękami chwytaka obiektu (wałka) o założonej średnicy maksymalnej, stycznie do jego powierzchni bocznej.
3. Wyznaczenie charakterystyki przesunięciowej chwytaka y f () x = p | .
Charakterystyka przesunięciowa chwytaka | y = fp () x określa zależność pomiędzy

rozwarciem końcÛwek chwytnych 2y a przemieszczeniem liniowym siłownika napędowego. Charakterystykę przesunięciową można otrzymać na drodze analitycznej, grafoanalitycznej, lub symulacji komputerowej. Charakterystyka przesunięciowa jest podstawą wyznaczenia
charakterystyki prędkościowej chwytaka f ( x ) F | .
4. Wyznaczenie charakterystyki prędkościowej chwytaka | ()
x

y f x v &

& =

Charakterystyka prędkościowa chwytaka () x

y f
v x | &
& = | określa stosunek prędkości koń-
cÛwki chwytnej y& do prędkości | tłoczyska siłownika x& (przełożenie kinematyczne)
w funkcji przemieszczenia siłownika x . Charakterystykę prędkościową analogicznie jak i przesunięciową można otrzymać na drodze analitycznej, grafoanalitycznej lub symulacji komputerowej. Charakterystyka prędkościowa daje możliwość wyznaczenia charakterystyki siłowej chwytaka fF () x .

### 5. Wyznaczenie charakterystyki siłowej

s

ch
F | F

F f ( x ) =

Charakterystyka siłowa chwytaka
s

ch
F | F
F f ( x ) = | określa stosunek siły chwytu Fch do si-

ły na tłoczysku siłownika Fs (przełożenie siłowe) w funkcji przemieszczenia siłownika x . Charakterystykę siłową można otrzymać na drodze grafoanalitycznej, analitycznej lub symulacji komputerowej oraz na podstawie charakterystyki prędkościowej chwytaka korzystając z

metody mocy chwilowych | 2f ( x )

1 f ( x )

v

F | = | .

Charakterystyka siłowa pozwala na określenie maksymalnej siły na tłoczysku siłownika Fs max potrzebnej do uzyskania maksymalnej niezbędnej siły chwytu Fchmax , co stanowi podstawę doboru siłownika. Charakterystyka siłowa pozwala ponadto określić korzystny ze względu na wartość siły chwytu zakres skoku siłownika.

Uwaga: Obliczenia wymagane w pkt. 3÷5 można przeprowadzać rÛżnymi metodami (grafoanalityczna, analityczna, symulacja komputerowa). W celu uniknięcia błędÛw obliczenia należy wykonać w każdym przypadku dwiema metodami, z ktÛrych jedną traktujemy jako podstawową a drugą jako sprawdzającą i wÛwczas obliczamy tylko wybrane wartości parametrÛw. W przypadku charakterystyki siłowej dodatkową metodą sprawdzającą jest metoda mocy chwilowych (pkt. 6).
W przypadku traktowania metody grafoanalitycznej jako podstawowej obliczenia należy przeprowadzić dla co najmniej czterech rÛżnych położeń chwytaka w tym dla dwÛch położeń skrajnych (maksymalne i minimalne rozwarcie szczęk chwytaka) a uzyskane wyniki aproksymować odpowiednimi charakterystykami. Można w tym celu wykorzystać dostępne programy komputerowe np. Excel.
Przy wyznaczaniu charakterystyki siłowej chwytaka należy przeprowadzić obliczenia statyczne pomijając siły ciężkości i bezwładności elementÛw chwytaka oraz pomijając tarcie w jego parach kinematycznych. Tarcie występuje jedynie pomiędzy szczękami chwytaka a uchwyconym obiektem.

### 6. Sprawdzenie metodą mocy chwilowych charakterystyki siłowej chwytaka na

podstawie jego charakterystyki prędkościowej | () 2f () x 1 f x
| v
F | = | dla jednego

zadanego położenia i porÛwnanie wynikÛw.

### 7. Obliczenia wytrzymałościowe chwytaka przy maksymalnych obciążeniach:

a) sprawdzenie warunku wytrzymałościowego na zginanie ramion chwytaka
b) sprawdzenie warunku wytrzymałościowego na ścinanie dla najbardziej obciążonego sworznia.
Obliczenia wytrzymałościowe zostaną przeprowadzone dla wybranych elementÛw konstrukcji i pozwolą określić ich minimalne wymiary w analizowanych przekrojach. Nie oznacza to jednak, że dokładnie te wymiary należy przyjąć w konstrukcji chwytaka. W ostatecznym doborze wymiarÛw elementÛw chwytaka należy zachować właściwe proporcje wymiarowe uzasadnione rÛwnież względami konstrukcyjnymi jak: zastosowanie typowych elementÛw, kształtownikÛw, łożysk, elementÛw złącznych, unikanie zbędnej obrÛbki elementÛw, prostota konstrukcji itp.

### 8. Obliczenie wymaganych parametrÛw napędu pneumatycznego chwytaka i jego

dobÛr.
DobÛr siłownika pneumatycznego przeprowadzamy na podstawie obliczonej maksymalnej siły wymaganej na tłoczysku siłownika Fs max oraz wartości wymaganego skoku. W projektowanym chwytaku możemy wykorzystać siłowniki dostępne w handlu (wg katalogÛw firm). Możliwe jest rÛwnież zaprojektowanie własnego siłownika zintegrowanego z konstrukcją chwytaka.

### 9. Wykonanie rysunku złożeniowego chwytaka oraz rysunkÛw wykonawczych

zadanych części.
Rysunki konstrukcyjne (złożeniowy i wykonawcze) stanowią zasadniczą część projektu konstrukcyjnego chwytaka. Do zaliczenia pracy wymagane jest wykonanie rysunku złożeniowego chwytaka wraz ze specyfikacją podzespołÛw i części oraz rysunku wykonawczego jednej wybranej części o średnim stopniu złożoności. Można rÛwnież uznać, że będą spełnione minimalne wymagania w przypadku wykonania rysunku złożeniowego w postaci aksonometrycznego schematu konstrukcyjnego wraz z odpowiednim rysunkiem wykonawczym wykonanym w rzutach prostokątnych. Schemat konstrukcyjny jest rysunkiem konstrukcyjnym
na | ktÛrym | występują | wszystkie | podstawowe | elementy ale | są | narysowane
w uproszczonej formie geometrycznej, bez szczegÛłÛw.
Studenci mogą wykonywać rysunki konstrukcyjne z wykorzystaniem programu Auto-CAD. Jednak podstawową formą rysowania jest rysowanie ręczne.

PRZYKŁAD 1. ROZWIĄZANIE ZADANIA PROJEKTOWEGO

Zadany schemat kinematyczny chwytaka typu P-(O-O-P)

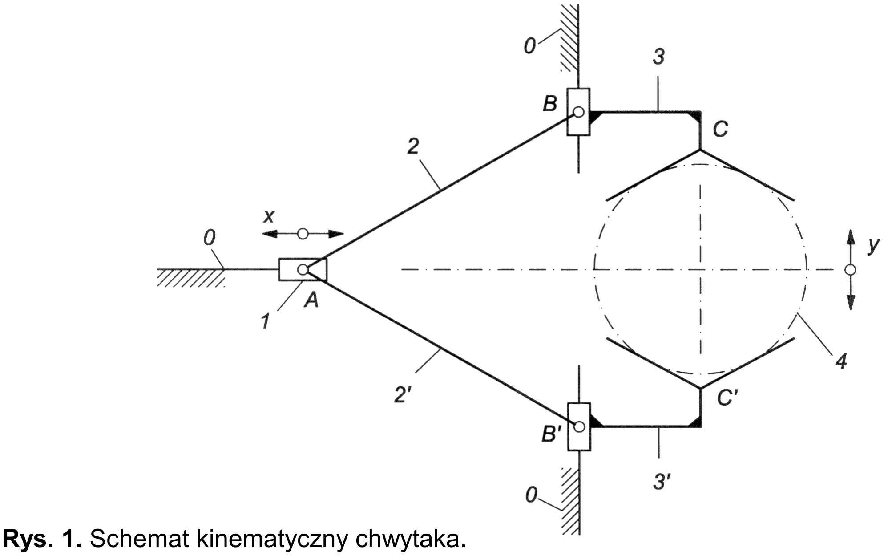
[picture p96: figure]
Rys. 1. Schemat kinematyczny chwytaka.

### 1. OBLICZENIE RUCHLIWOŚCI CHWYTAKA

w = 3n − 2p5 − p4 | (1)
gdzie: w - ruchliwość chwytaka,
n - liczba członÛw ruchomych,
p5 - liczba par kinematycznych klasy piątej obrotowych i postępowych,
p4 - liczba par klasy czwartej.

Dla powyższego schematu chwytaka mamy:
n = 5, p5 = ( )( )( )( )( )( )( ) 0,1 , 1,2 , 1,2' , 2,3 , 2' ,3' , 3,0 , 3' ,0 = 7, p4 = 0 w = 3 ⋅5 − 2 ⋅7 = 1

Ruchliwość w=1 oznacza, że do napędu chwytaka zastosujemy jeden siłownik pneumatyczny o ruchu liniowym.

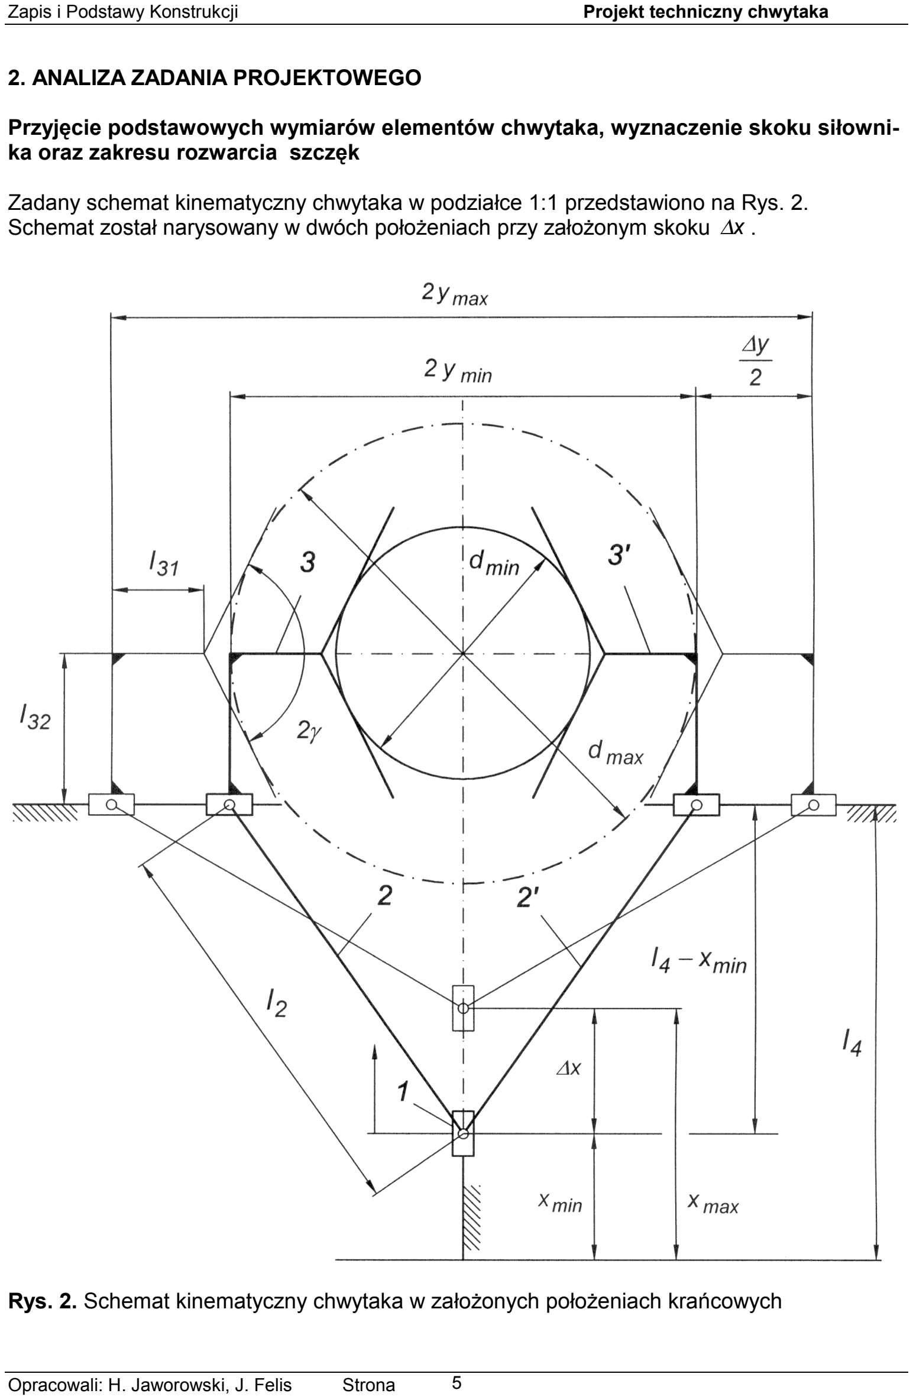
[picture p97: page 5]

### 2. ANALIZA ZADANIA PROJEKTOWEGO

Przyjęcie podstawowych wymiarÛw elementÛw chwytaka, wyznaczenie skoku siłownika oraz zakresu rozwarcia szczęk

Zadany schemat kinematyczny chwytaka w podziałce 1:1 przedstawiono na Rys. 2. Schemat został narysowany w dwÛch położeniach przy założonym skoku ∆x .

Rys. 2. Schemat kinematyczny chwytaka w założonych położeniach krańcowych

Uwaga: Można przyjmować skoki suwaka 1 mechanizmu chwytaka rÛwne wartościom typowych skokÛw siłownikÛw.

Przykładowo typowe skoki dla jednego z siłownikÛw typu ADVU firmy Festo wynoszą 1÷400 mm a dla tzw. siłownikÛw krÛtkoskokowych typ ADV odpowiednio 4÷80 mm. Przyjęcie skoku suwaka identycznego ze skokiem typowego siłownika upraszcza konstrukcje chwytaka ponieważ nie będą wymagane dodatkowe konstrukcyjne ograniczenia skoku.

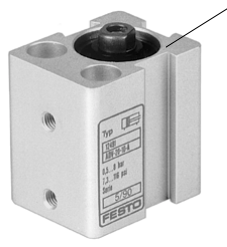
[picture p98: figure]

a) b)

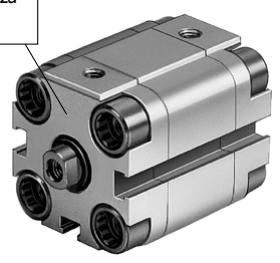
[picture p99: figure]

Rys 3. Siłowniki firmy FESTO a) typu ADV b) typu ADVU,

Ostatecznie na podstawie analizy geometrycznej na podstawie schematu Rys. 2 do dalszych obliczeń przyjęto:

l | x | , l , l , l , , d | , d | .
x | , x | , x x | x | , y | , y | , y 2( y | y | ),
4 | min | 2 | 31 32 | min | max
min | max | max | min | min | max | max | min
γ
∆ | ∆
−
= | − | = | −

Uwaga: xmin - jest to odległość centralnego punktu suwaka w pozycji maksymalnie cofniętej do wybranej bazy montażowej np. gÛrnej powierzchni siłownika. W obliczeniach charakterystyk chwytaka wartość xmin można przyjmować dowolnie.

Maksymalny ciężar obiektu transportowanego obliczono ze wzoru:

γ

### π = max ⋅

2
max
max | l
4
d Q | [N] | (2)
gdzie: max l | [m] - maksymalna długość chwytanego obiektu,
γ [N/m³
| ] ñ ciężar właściwy materiału transportowanego.

Ta powierzchnia może
być traktowana jako baza
montażowa

Wyznaczenie maksymalnej koniecznej siły chwytu Fch max i minimalnego wymiaru szczęki

Dane: dmax - maksymalna średnica obiektu manipulacji (wałka, tulei),
Qmax - maksymalny ciężar obiektu manipulacji,
µ - wspÛłczynnik tarcia między szczękami chwytaka a obiektem (µ=0,2÷0,3),
n = 2 - wspÛłczynnik przeciążenia chwytaka (wspÛłczynnik ten wynika z uwzględnie-nia siły bezwładności oddziaływującej na obiekt transportowany w chwili rozruchu manipulatora, przyjęto, że chwytak doznaje wtedy przyspieszenia rÛwnego g)
2γ - kąt nachylenia szczęk chwytaka.

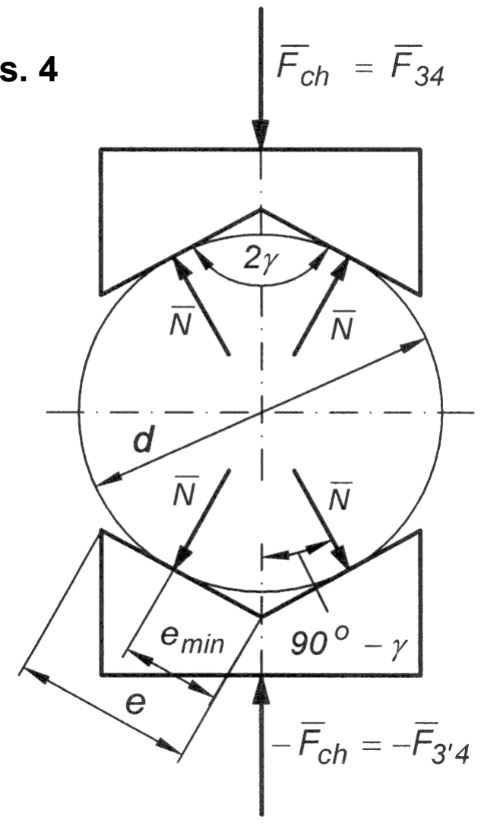
[picture p100: figure]

Transportowany obiekt chwytany jest w pozycji jak na Rys. 4

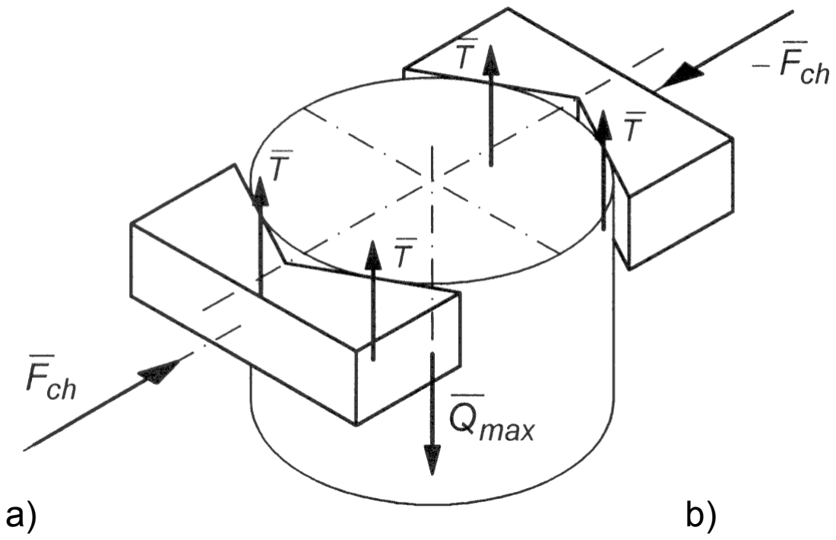
[picture p101: figure]

Rys. 4. Układ sił działających na chwytak
a) rozkład sił tarcia podczas chwytania obiektu
b) rozkład sił normalnych podczas chwytania obiektu

Wyznaczenie siły chwytu
F | 2N cos(90 | ) ⁰
ch = | − γ , | γ | 2 sinγ F
2 cos(90 | )
F N | ch
0
ch | = − = | , | γ
µ µ | 2 sin
F T | N | ch ⋅ = | = | .

Dla prawidłowego uchwycenia transportowanego elementu musi być spełniony warunek:

Q n
sin
2F 4T | ch | ≥ ⋅ ⋅ = | γ

µ
stąd siła chwytu | µ

γ
2

Q nsin Fch

⋅ ≥ | oraz | µ

γ
2
Q | nsin F | max
ch max

⋅ ≥

(3)

Wyznaczenie minimalnego wymiaru szczęki

2emin

d tgγ = | stąd | 2tgγ
d
emin = | oraz | 2tgγ

d
e > emin = | (4)

### 3. WYZNACZENIE CHARAKTERYSTYKI PRZESUNIĘCIOWEJ CHWYTAKA

Charakterystyka przesunięciowa chwytaka: y = fp () x | (5)

gdzie:
x - przesunięcie zespołu napędowego (tłoczyska siłownika pneumatycznego),
y - przesunięcie końcÛwek chwytnych
fp () x - przełożenie przesunięciowe mechanizmu chwytaka.

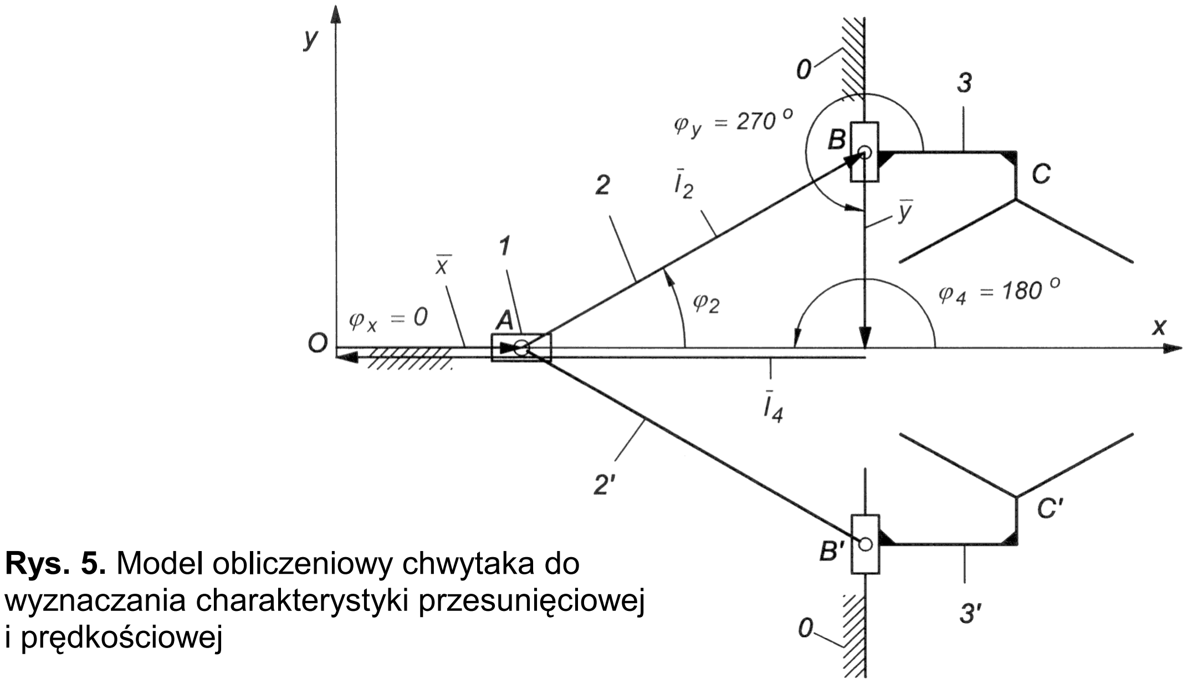
[picture p102: figure]
Rys. 5. Model obliczeniowy chwytaka do; i prędkościowej

wyznaczania charakterystyki przesunięciowej

Dane: | () | 0
4 | 4

0 x = x t , ϕx = 0, l2 , ϕy = 270 , l , ϕ = 180
Wyznaczymy:ϕ2 , y, ϕ&2 , y& , oraz charakterystykę przesunięciową y f () x = p

Zadanie zostanie rozwiązane metodą analityczną

W celu rozwiązania zadania metodą analityczną przyjmujemy układ wspÛłrzędnych Oxy. W schemat kinematyczny mechanizmu wpisujemy zamknięty wielobok wektorowy. Oznaczamy kąty jakie tworzą wektory z osią x układu wspÛłrzędnych. Dla przyjętego wieloboku możemy napisać rÛwnanie wektorowe:
l 0

4

l 1

### ∑ l = = , x + l 2 + y + l 4 = 0

Rozwiązanie:
x cosϕ x + l2 cosϕ2 + y cosϕy + l4 cosϕ4 = 0
x sinϕ x + l2 sinϕ2 + y sinϕy + l4 sinϕ4 = 0
x + l2 cosϕ2 − l4 = 0
l2 sinϕ2 − y = 0 | (6)

Na podstawie (6) mamy:

l cos | l x 2 | ϕ2 = 4−
l2 sinϕ2 = y | stąd: | ( | )² 2
4

2
l2 = l − x + y
ostatecznie charakterystyka przesunięciowa chwytaka: | ( | )²
4
2 y = ± l2 − l − x | (7)

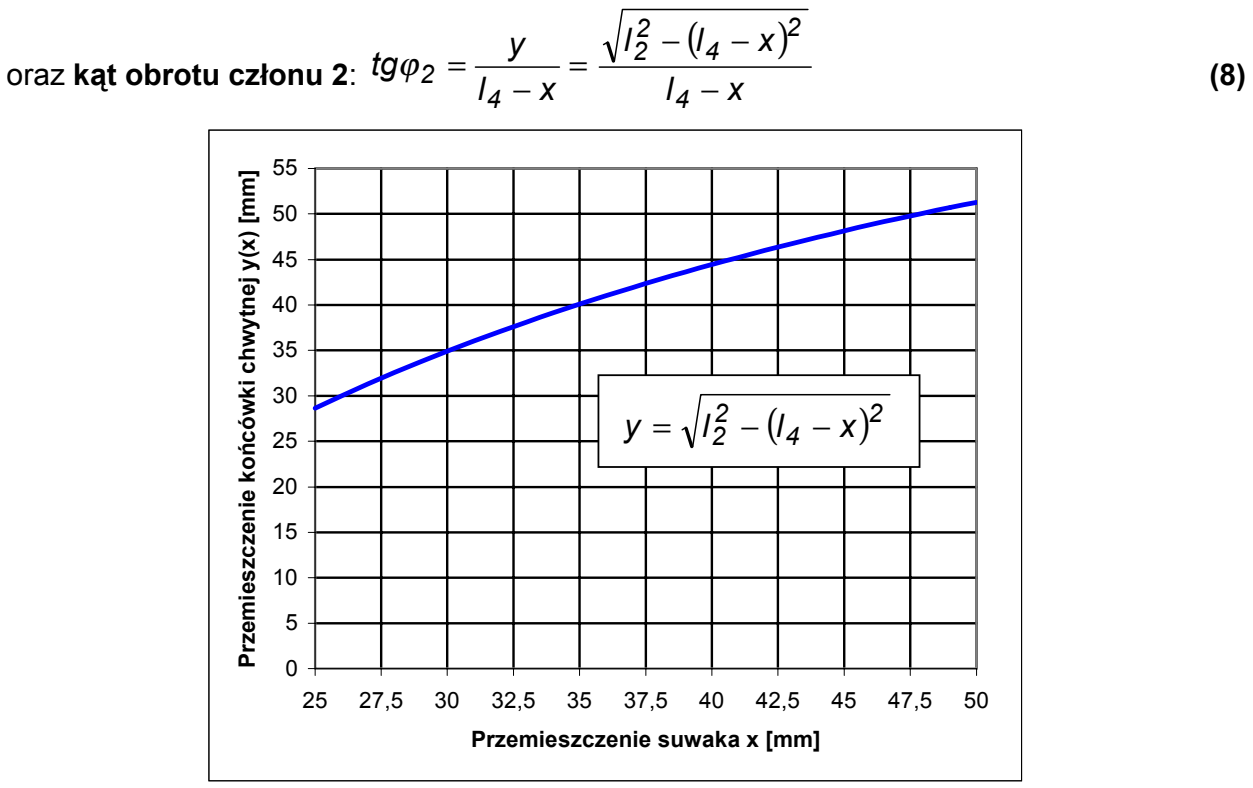
[picture p103: figure]
oraz kąt obrotu członu 2:; Przemieszczenie suwaka x [mm]; Przemieszczenie końcÛwki chwytnej y(x) [mm]

Rys. 6. Charakterystyka przesunięciowa chwytaka (Excel)

### 4. WYZNACZENIE CHARAKTERYSTYKI PRĘDKOŚCIOWEJ CHWYTAKA

Charakterystyka prędkościowa chwytaka ()
x

y f x v &

& =

Charakterystykę prędkościową otrzymujemy obliczając pochodną względem czasu wyrażenia (7).

( )

x
l | l | x
l | x
y | 2

4

2
2
& | 4 | &
− −
− = ± | lub | ()
( | )²
4

2
2

4
v
l | l | x
l | x
x

y f x
− −

− = = &
&
(9)

gdzie: x&,y& odpowiednio prędkość tłoczyska i prędkość końcÛwki chwytnej

Charakterystykę prędkościową można rÛwnież wyznaczyć na podstawie analizy kinematycznej mechanizmu chwytaka przeprowadzonej metodą wektorową nazywaną metodą planÛw prędkości. Metoda ta polega na zapisaniu rÛwnań wektorowych określających prędkości charakterystycznych punktÛw mechanizmu, a następnie ich rozwiązaniu wykreślnym. Zależności geometryczne wynikające z planÛw prędkości mogą rÛwnież w przypadku prostych mechanizmÛw stanowić podstawę do wyprowadzenia zależności analitycznych (w tym przypadku z pominięciem metody analitycznej stosowanej powyżej).

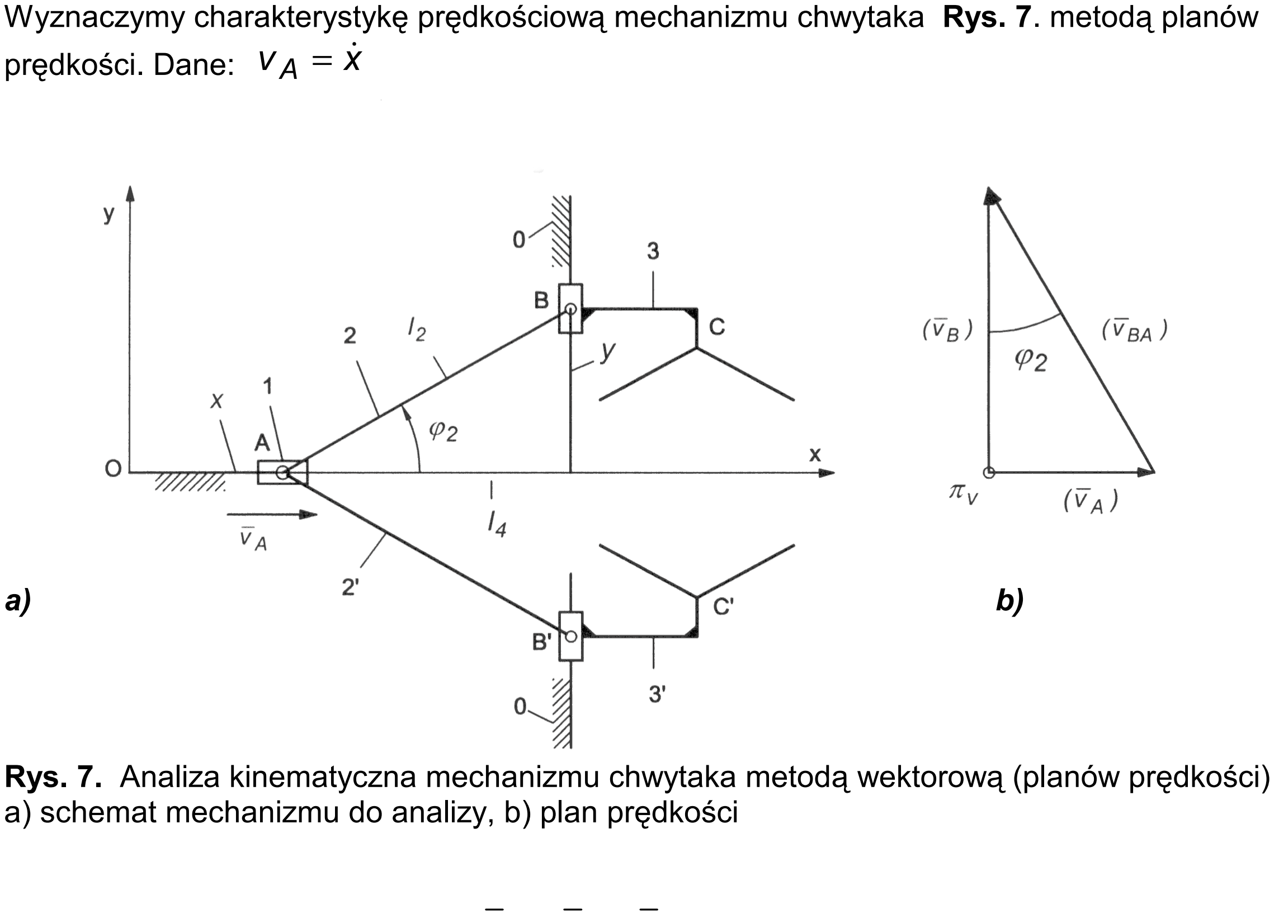
[picture p104: figure]
prędkości. Dane: vA = x&

Wyznaczymy charakterystykę prędkościową mechanizmu chwytaka Rys. 7. metodą planÛw

Rys. 7. Analiza kinematyczna mechanizmu chwytaka metodą wektorową (planÛw prędkości)
a) schemat mechanizmu do analizy, b) plan prędkości
RÛwnanie prędkości punktu B: IIy y IIx x | AB
vB | v A | vBA
− | − | ⊥
= | +
(10)
Przyjmujemy podziałkę rysunkową prędkości: | () A

A
| | V
v

v k = i rozwiązujemy wykreślnie rÛwna-

nie (10) (Rys. 7b).

Na podstawie Rys. 7a,b możemy wyprowadzić charakterystykę prędkościową chwytaka:
() | ()
() | ( | )²
4

2
2
4 | 4
2
A

B
A v

B v
v
l | l | x
l | x
y

l x ctg
v

v
v k

v k
x

y f x
− | −
− = − = = | = | = ϕ = &
&
(11)

Wzory (11) i (9) są identyczne co potwierdza poprawność przeprowadzonej analizy kinematycznej chwytaka.

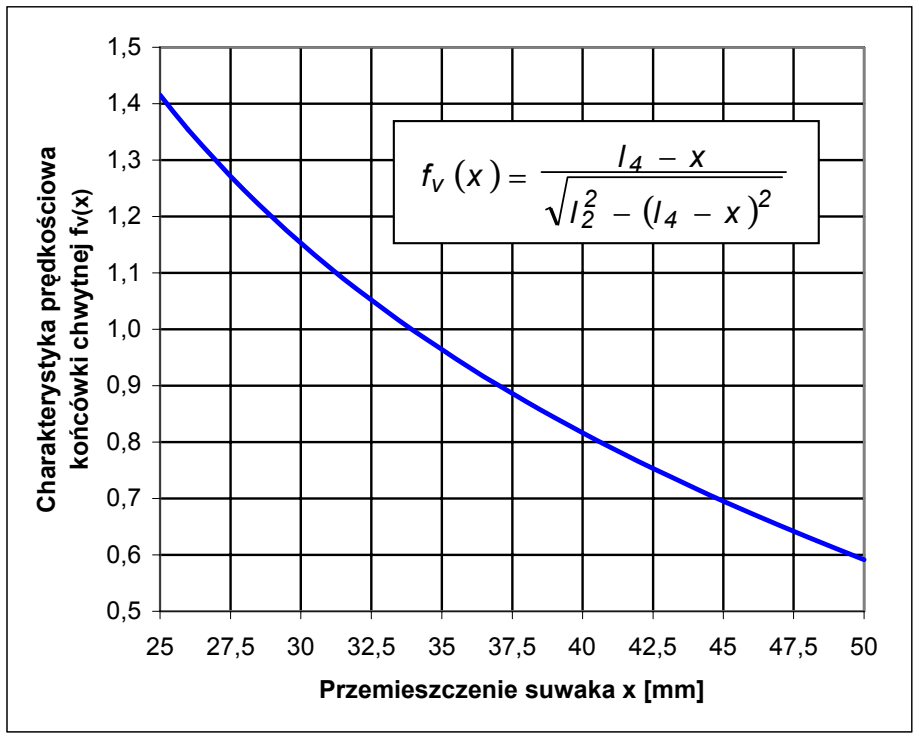
[picture p105: figure]
Przemieszczenie suwaka x [mm]; Charakterystyka pr; ędko; ściowa; ńcÛwki chwytnej fv(x)

Rys. 8. Charakterystyka prędkościowa chwytaka (Excel)

25 27,5 30 32,5 35 37,5 40 42,5 45 47,5 50

### 5. WYZNACZENIE CHARAKTERYSTYKI SIŁOWEJ CHWYTAKA

Charakterystyka siłowa (przełożenie siłowe) chwytaka: ()

s

ch
F | F
F f x = | (12)

gdzie: Fs - siła na wyjściu zespołu napędowego (siłownika) chwytaka, Fch - siła chwytu,
fF () x - przełożenie siłowe mechanizmu chwytaka.

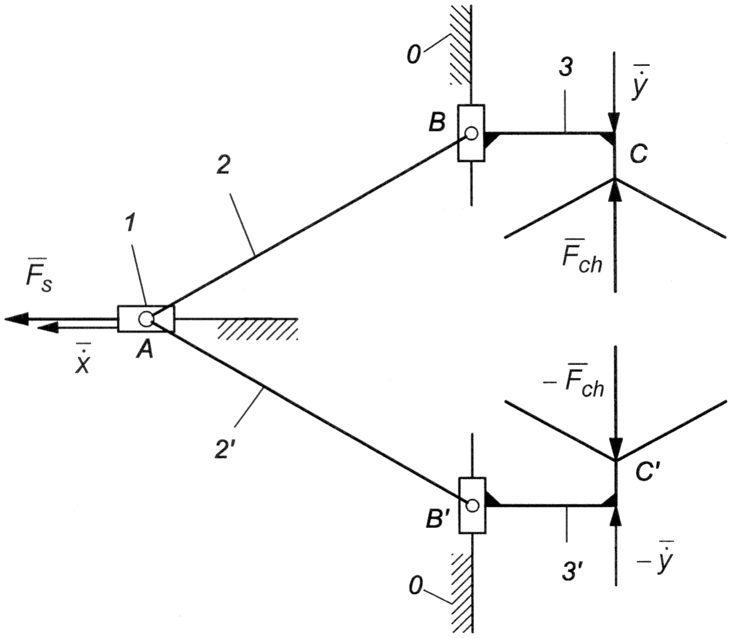
[picture p106: figure]

Rys. 9. Model obliczeniowy chwytaka do wyznaczenia charakterystyki siłowej

Ograniczymy się do analizy statycznej chwytaka pomijając siły ciężkości i siły bezwładności jego elementÛw oraz siły tarcia w parach kinematycznych. Zadanie rozwiążemy metodą grafoanalityczną opartą na wektorowym zapisie rÛwnań rÛwnowagi sił oraz analitycznym zapisie rÛwnań rÛwnowagi momentÛw sił. W tej metodzie analizę siłową rozpoczynamy od wyznaczenia układu sił działających na tzw. grupę strukturalną (w tym przypadku jest układ dwÛch członÛw oswobodzonych od podstawy oraz od członu napędzającego). Po wyznaczeniu sił w grupie strukturalnej przystępuje się do analizy siłowej członu napędzającego (suwaka-tłoczyska siłownika -1).
Ze względu na symetrię mechanizmu przeprowadzimy analizę sił tylko w grupie strukturalnej (2,3). Układ sił dla grupy (2í

, 3í
) będzie identyczny.
Metoda grafoanalityczna daje rozwiązanie graficzne dla jednego, wybranego położenia mechanizmu. Jeżeli chcemy określić siły w wielu położeniach mechanizmu musimy takie rozwiązanie wielokrotnie powtÛrzyć.
Zależności geometryczne wynikające z rozwiązania grafoanalitycznego stanowią w przypadku prostych mechanizmÛw podstawę do sformułowania analitycznych związkÛw określających siły w parach kinematycznych mechanizmu i opisujących jego charakterystykę siłową. Zostanie to wykorzystane w niniejszym przykładzie.

Analiza sił w grupie strukturalnej (2, 3)

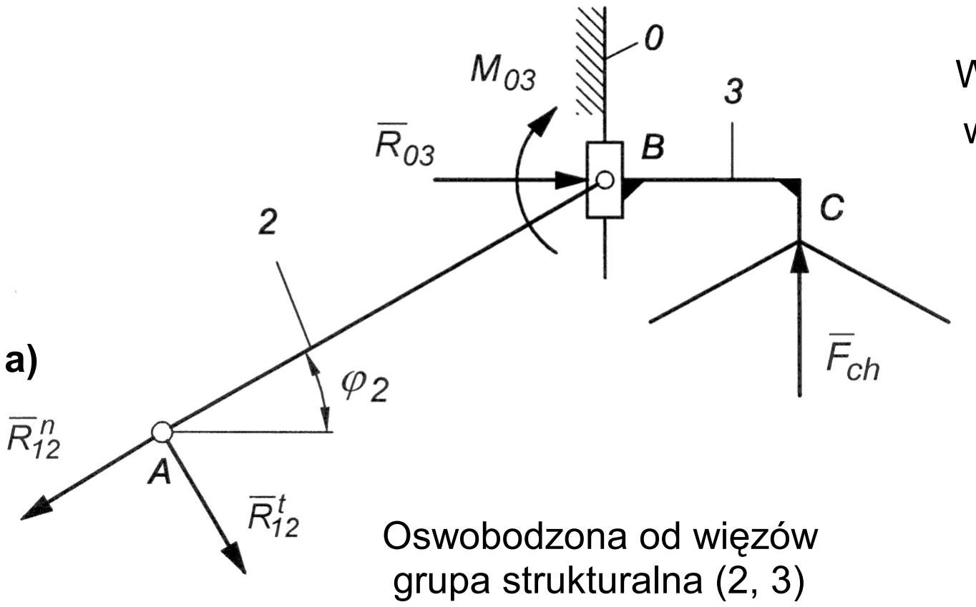
[picture p107: figure]
Oswobodzona od więzÛw grupa strukturalna (2, 3)

Wykreślne rozwiązanie rÛwnania (13) w podziałce kR

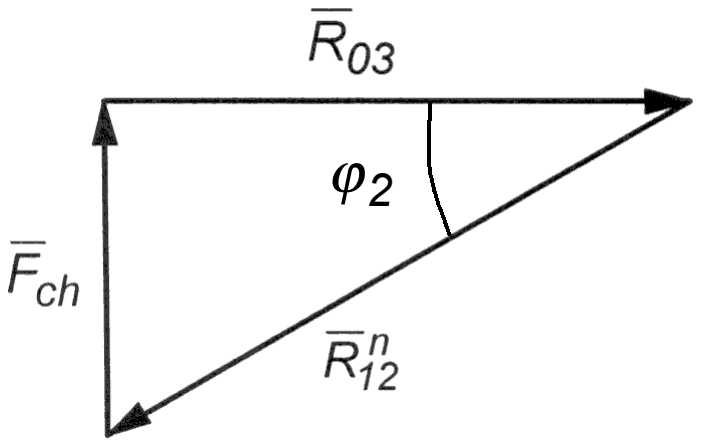
[picture p108: figure]

b)

Rys. 10. Analiza sił działających na człony grupy strukturalnej (2, 3)
a) oswobodzenie od więzÛw grupy strukturalnej , b) oraz graficzne rozwiązanie rÛwnania rÛwnowagi sił
P () 0 | R | R | R03 | Fch | 0
0

12

n ∑ i 2,3 = ⇒ 12 + | + | + | =
=

τ
(13)
∑MiB() 2 = 0 ⇒ R12 ⋅ AB = 0; R12 = 0 τ | τ | (14)
∑MiB() 3 = 0 ⇒ −M03 + FchBC = 0; | M03 = Fch ⋅BC | (15)

Analiza sił dla członu napędzającego 1

Wykreślne rozwiązanie rÛwnania (16) w podziałce kR

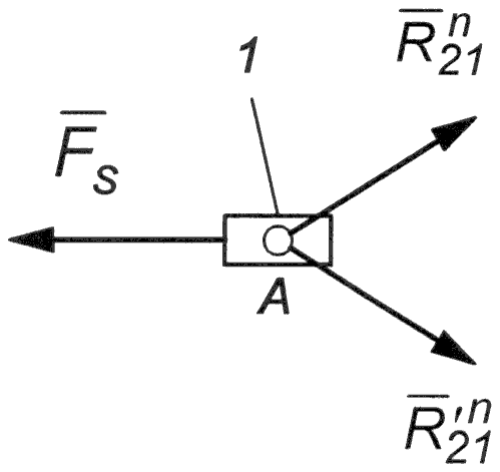
[picture p109: figure]
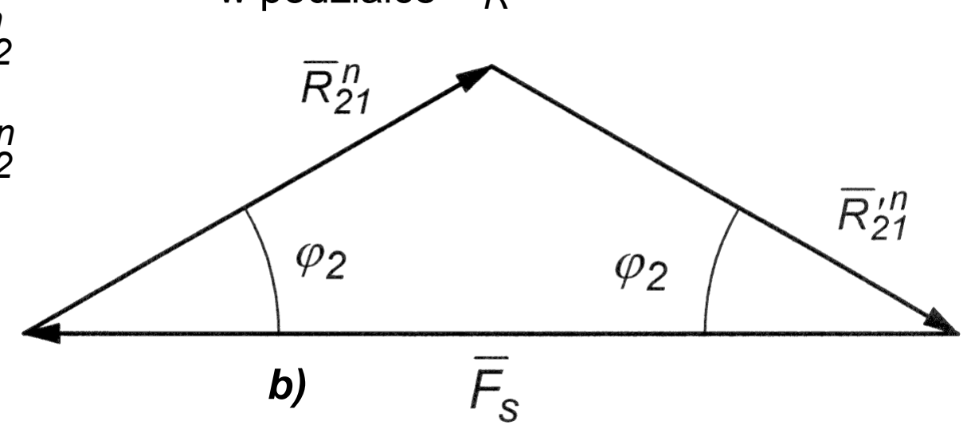
[picture p110: figure]

a) b)

Rys. 11. Analiza sił dla członu napędzającego 1.
a) oswobodzenie od więzÛw członu 1, b) graficzne rozwiązanie rÛwnania rÛwnowagi sił
P () 0 | F | R | R | 0 ' n
21
n ∑ i 1 = ⇒ s + 21 + | = | (16)

Na podstawie rÛwnania (16) rozwiązanego wykreślnie na Rys. 11b otrzymaliśmy wartość i zwrot siły Fs siłownika niezbędnej do uchwycenia przedmiotu z siłą Fch w położeniu mechanizmu jak na rysunku.

R12 = 0 τ

n
12

n R21 = −R

n
12

### n R21′ = −R ′

Zależności analityczne

Na podstawie Rys. 10b mamy: | 2
n | ch
12 | sin

F R
ϕ =
Na podstawie Rys. 11b mamy: | 2 | ch | 2
| n
s | 21 F = 2R cosϕ = 2 ⋅F ⋅ctgϕ
stąd charakterystyka siłowa: | () | ( | )
2( | ) l | x
l | l | x
2

tg
F

F f x

4

2
4

2
2 2
s

ch
F | −
− | − = | = | = ϕ | (17)

### 6. SPRAWDZENIE CHARAKTERYSTYKI SIŁOWEJ CHWYTAKA METODĄ MOCY

CHWILOWYCH

RÛwnanie mocy chwilowych dla chwytaka

Dla dowolnego chwytaka bilans mocy chwilowych przy pominięciu tarcia, sił ciężkości oraz bezwładności jego elementÛw ma postać:

Nwe + Nwy = 0 , gdzie | Nwe = Fs ⋅ x&, Nwy = 2Fch ⋅ y& | (18)
czyli: | Fs ⋅ x& + 2Fch ⋅ y& = 0 | stąd: | Fs ⋅ x& − 2Fch ⋅ y& = 0 | (19)

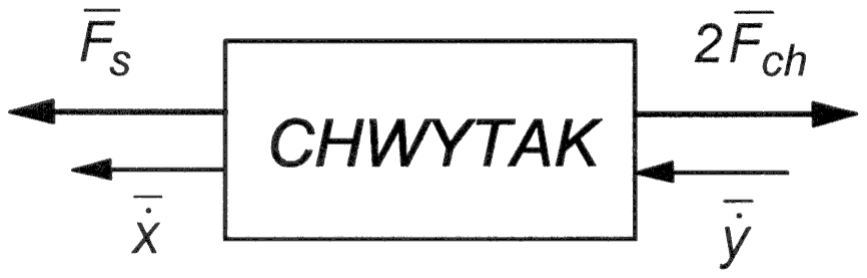
[picture p111: figure]

Rys. 12. Model chwytaka do wyznaczenia bilansu mocy chwilowych

Na podstawie (19) można wyznaczyć charakterystykę siłową przy pomocy charakterystyki

prędkościowej ponieważ zachodzi zależność: | f ( x ) 2y

x
F

F
F
s

ch = = &

&

# lub () 2f () x

1 f x

v

F | = | (20)

Obliczanie charakterystyki siłowej chwytaka na podstawie jego charakterystyki prędkościowej metodą mocy chwilowych

Podstawiając zależność (9) do wzoru (20) otrzymamy:
() | ()
( | )
2( | ) l | x
l | l | x
2

tg
2f x

1 f x

4

2
4

2
2 2
v
F | −
− − = | = | = ϕ | (21)

Na podstawie rÛwnania mocy chwilowych otrzymaliśmy zatem charakterystykę siłową mechanizmu chwytaka.
RÛwnania (17) i (21) mają identyczną postać co potwierdza poprawność przeprowadzonej analizy siłowej.

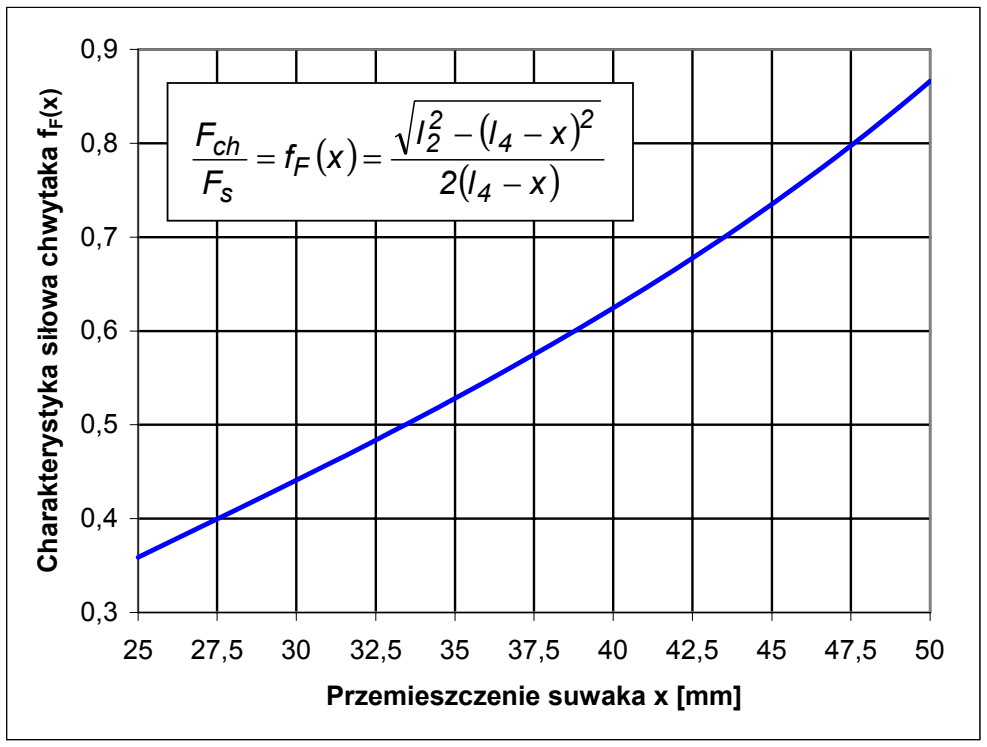
[picture p112: figure]
Przemieszczenie suwaka x [mm]; Charakterystyka siłowa chwytaka fF(x)

Rys. 13. Charakterystyka siłowa chwytaka (Excel)

### 7. OBLICZENIA WYTRZYMAŁOŚCIOWE CHWYTAKA

Obliczenia wytrzymałościowe przeprowadzamy przyjmując wstępnie rodzaj materiału i wymiary przekroju obciążonych elementÛw. Wymiary te należy przyjmować w oparciu o proporcje zaobserwowane w istniejących konstrukcjach chwytakÛw. Po sprawdzeniu warunku wytrzymałościowego można dokonać korekty wymiarÛw.

Sprawdzenie warunku wytrzymałościowego na zginanie ramion chwytaka

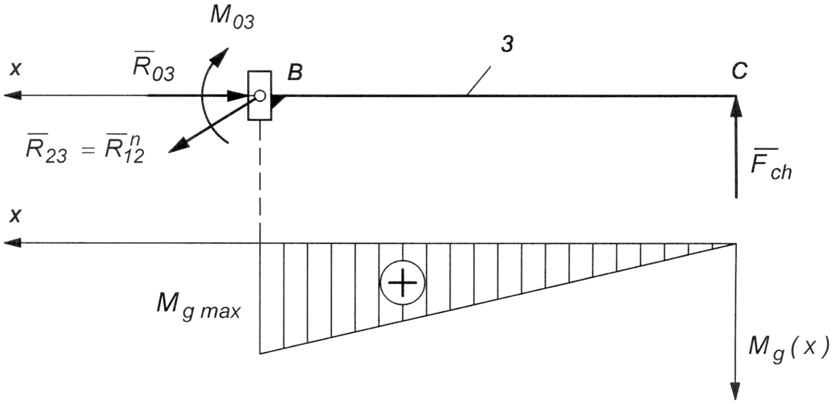
[picture p113: figure]

Rys. 14. Model obciążenia i wykres momentÛw gnących dla ramienia chwytaka

Maksymalny moment gnący występuje w punkcie B i wynosi: Mg max = M03 = Fch ⋅BC

Przyjmujemy przekrÛj prostokątny ramienia chwytaka o wskaźniku wytrzymałości na

zginanie: | 6

bh W

2
g =

Warunek wytrzymałościowy na zginanie ramienia chwytaka ma postać:

g 2

ch
g

g max
g max | k
bh

6F BC
W

M
≤ ⋅ σ | = | = | (22)

gdzie: kg - wytrzymałość materiału ramienia na zginanie

Sprawdzenie warunku wytrzymałościowego na ścinanie dla najbardziej obciążonego sworznia

Przyjmujemy, że połączenie elementu 3 (suwaka z ramieniem) oraz elementu 2
(dźwigni)następuje przy pomocy sworznia, ktÛry przenosi siłę | n R12 | działającą
w przegubie B. Sworzeń ten jest ścinany. Średnicę sworznia należy przyjmować w oparciu o wymiary przekrojÛw łączonych członÛw, uwzględniając osłabienie przekroju otworem pod sworzeń. Celowe jest prowadzenie obliczeń rÛwnocześnie z konstruowaniem mechanizmu.

Warunek wytrzymałościowy na ścinanie sworznia w punkcie B ma postać:

t 2

ch

n
t max | 12
max | k
d

4F
A

R
A
F = | = | = | ≤
π
τ | (23)
gdzie: | 4

d A

2
= π ñ powierzchnia przekroju sworznia, d- średnica sworznia,

t k - naprężenia dopuszczalne na ścinanie materiału sworznia.

W przypadku ścinania sworznia w dwu płaszczyznach przyjmujemy | 4

d A 2

2
= π .

### 8. OBLICZANIE WYMAGANYCH PARAMETR”W NAPĘDU PNEUMATYCZNEGO

CHWYTAKA

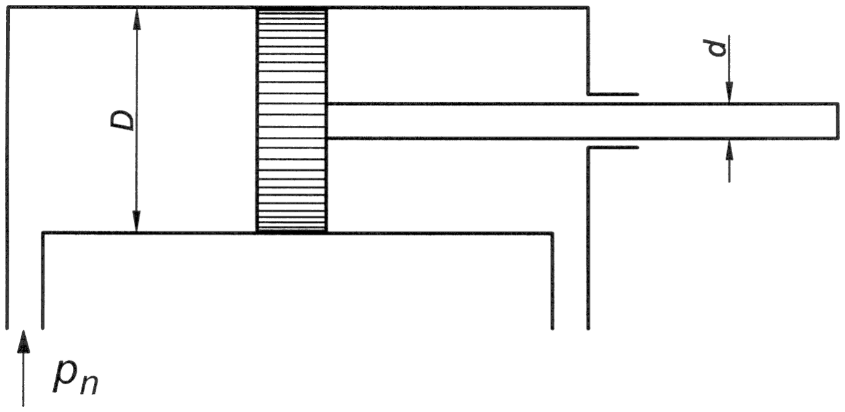
[picture p114: figure]

Rys. 15. Model siłownika pneumatycznego dwustronnego działania.

Teoretyczna siła pchająca cylindra pneumatycznego: | n

2
tp | p 4
D P | π = | (24)
Teoretyczna siła ciągnąca napędu pneumatycznego: | n
2 | 2
tc | p 4
(D | d ) P | − = π | (25)

gdzie: pn = 0,6MPa - ciśnienie nominalne zasilania

Zasada doboru siłownika: Pt | Pw | k Fs max ≥ | = ⋅ | (26)

gdzie: Pt - teoretyczna siła pchająca lub ciągnąca siłownika

Pw - obliczona wymagana siła na tłoczysku

k = 1,2 ÷1,5 - wspÛłczynnik przeciążenia

Fs max - maksymalna siła na tłoczysku siłownika potrzebna do uzyskania maksymalnej niezbędnej siły chwytu, ktÛrą wyznaczamy ze wzoru:

| F | | min

ch max
s max | f ( x )
F F | = | (27)
Uwaga: Obliczona wymagana siła na tłoczysku siłownika Pw | k Fs max = ⋅ | jest podstawą do-
boru siłownika z katalogu firmowego lub przy projektowaniu własnego. Zalecane jest jednak projektowanie chwytaka na bazie siłownika dobranego z katalogu firmowego.

### 9. RYSUNKI KONSTRUKCYJNE CHWYTAKA

Zakładając, że mamy przyjęte lub obliczone podstawowe parametry geometryczne oraz dobrany napęd (siłownik), możemy przystąpić do kształtowania postaci konstrukcyjnej członÛw chwytaka. Jeżeli jako napęd stosujemy siłownik handlowy to pozostałą część konstrukcji należy posadowić na siłowniku wykorzystując w tym celu bazę montażową jaką posiada. Należy ukształtować element konstrukcyjny na ktÛrym posadowione będą pary kinematyczne występujące w mechanizmie chwytaka. Ten element (podstawa) będzie mocowany do siłownika za pomocą łącznikÛw śrubowych. Człon napędowy mechanizmu chwytaka (suwak) będzie posadowiony bezpośrednio na tłoczysku siłownika czyli nie będzie wymagał dodatkowego prowadzenia. Pamiętając o tym, że chwytak jest obciążony przestrzennym układem sił (siła obciążająca Qmax działa prostopadle do płaszczyzny mechanizmu) należy konstruować elementy mechaniczne o odpowiedniej sztywności rÛwnież w kierunku poprzecznym. Dotyczy to w szczegÛlności łożysk i prowadzeń suwakÛw.
Ostateczny kształt konstrukcji zależy od wiedzy, wyobraźni i inwencji konstruktora. Należy wykorzystywać gotowe elementy (handlowe) jak łączniki śrubowe, pierścienie sprężyste sworznie, kołki, łożyska, kształtowniki itp. ponieważ upraszcza to konstrukcję i zmniejsza jej koszty.
Rozwiązanie konstrukcyjne rozpoczynamy od rzutu głÛwnego chwytaka na rysunku złożeniowym nakładając na narysowany w podziałce 1:2, 1:1 lub 2:1 schemat kinematyczny mechanizmu elementy geometrii członÛw oraz umiejscawiając siłownik pneumatyczny (rys.16) . Następnie wprowadzimy trzeci wymiar rysując elementy konstrukcyjne w kolejnych rzutach (rys. nr CHW.01.00). W przypadku konstruowania z użyciem programu AutoCAD można zacząć od rysunku siłownika pneumatycznego w przestrzeni trÛjwymiarowej (rys.17), a następnie nakładać kolejne elementy mechaniczne w postaci brył w celu utworzenia trÛjwymiarowego rysunku złożeniowego. Rzuty prostokątne chwytaka otrzymamy automatycznie. Rysunek wykonawczy niezależnie od narzędzi konstruowania należy narysować dla jednej części o średnim stopniu złożoności.

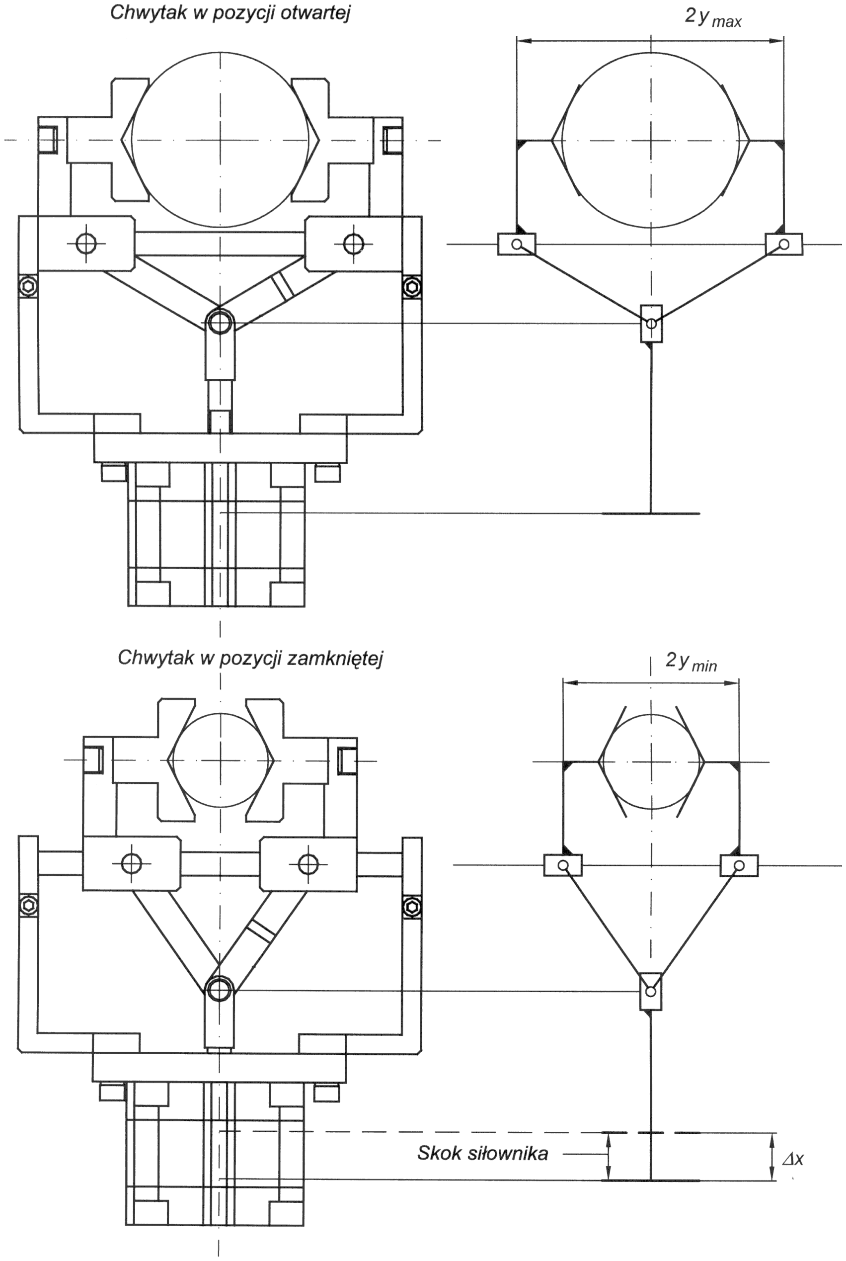
[picture p115: figure]

Rys. 16. Konstruowanie chwytaka na podstawie schematu kinematycznego.

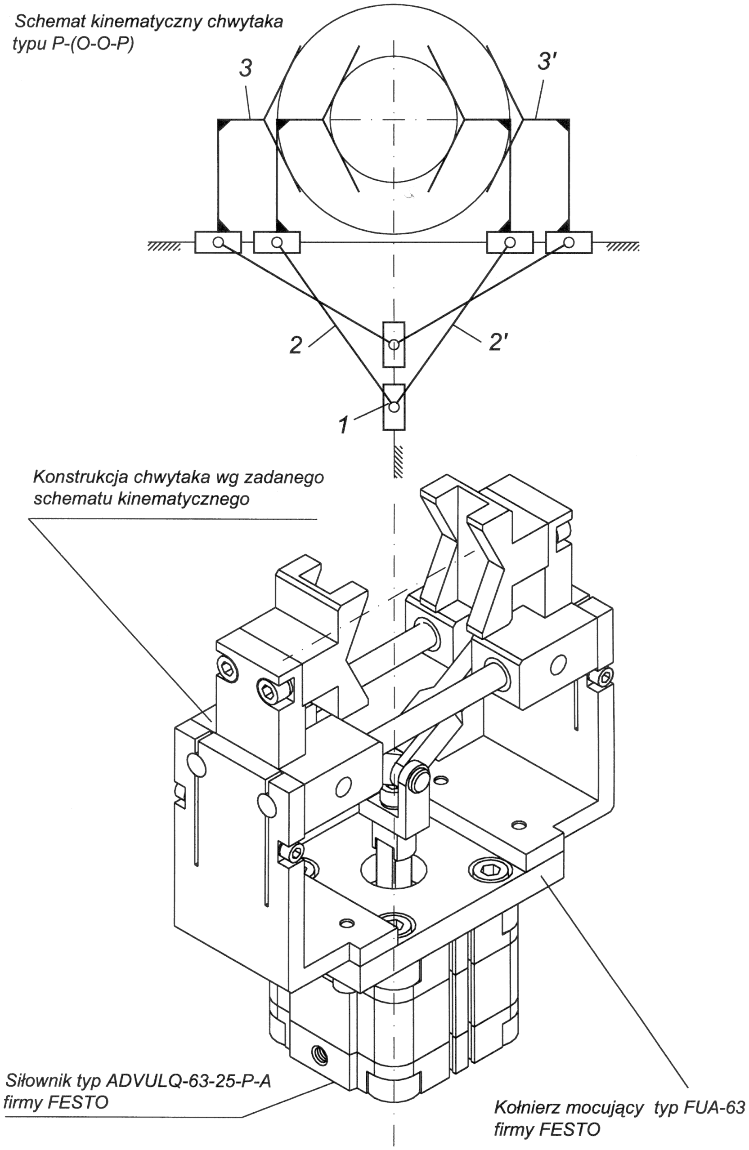
[picture p116: figure]

Rys. 17. Konstrukcja chwytaka typu P-(O-O-P) napędzanego siłownikiem pneumatycznym w AutoCAD. Rysunek w takiej postaci nie jest wymagany w ramach projektu

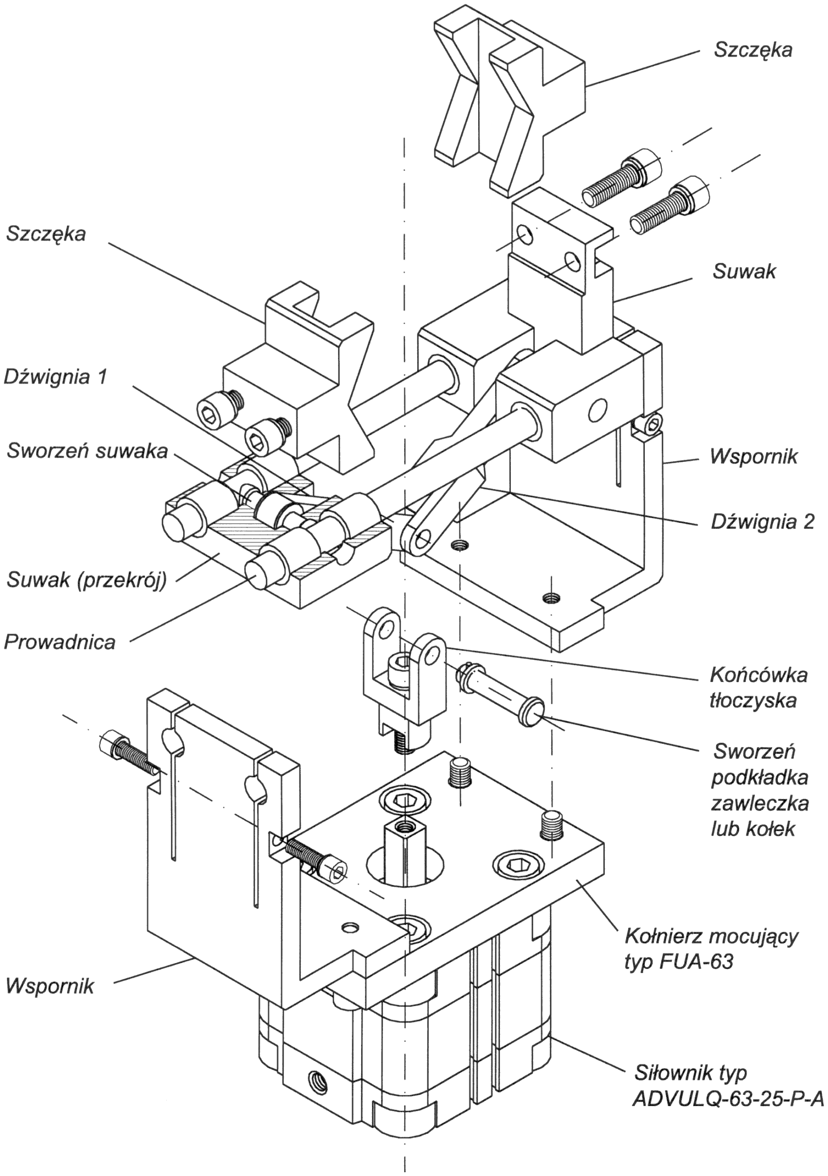
[picture p117: figure]

Rys. 18. Podzespoły i elementy konstrukcyjne chwytaka w AutoCAD Rysunek w takiej postaci nie jest wymagany w ramach projektu

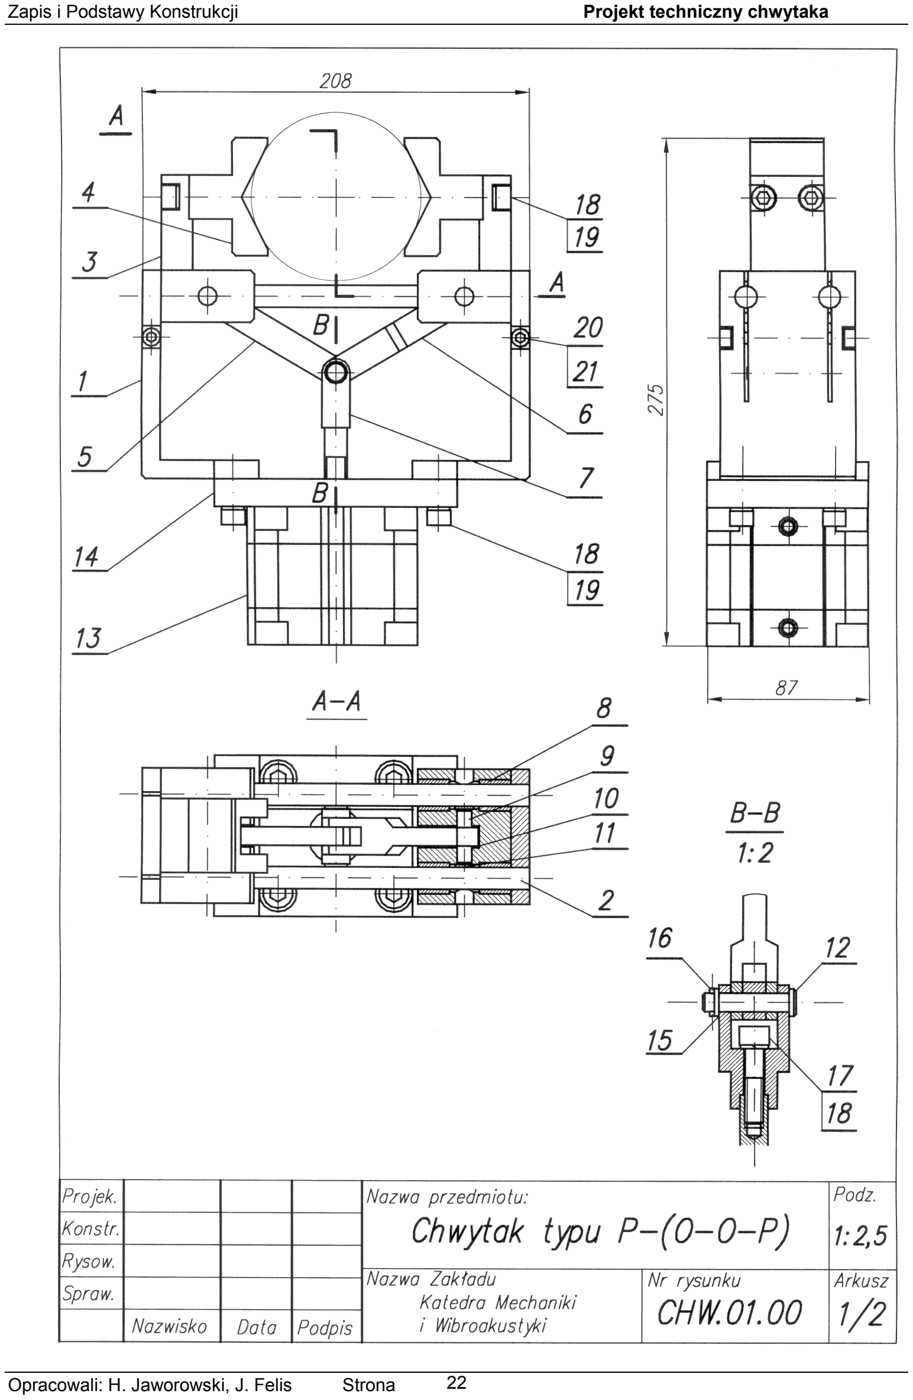
[picture p118: page 22]
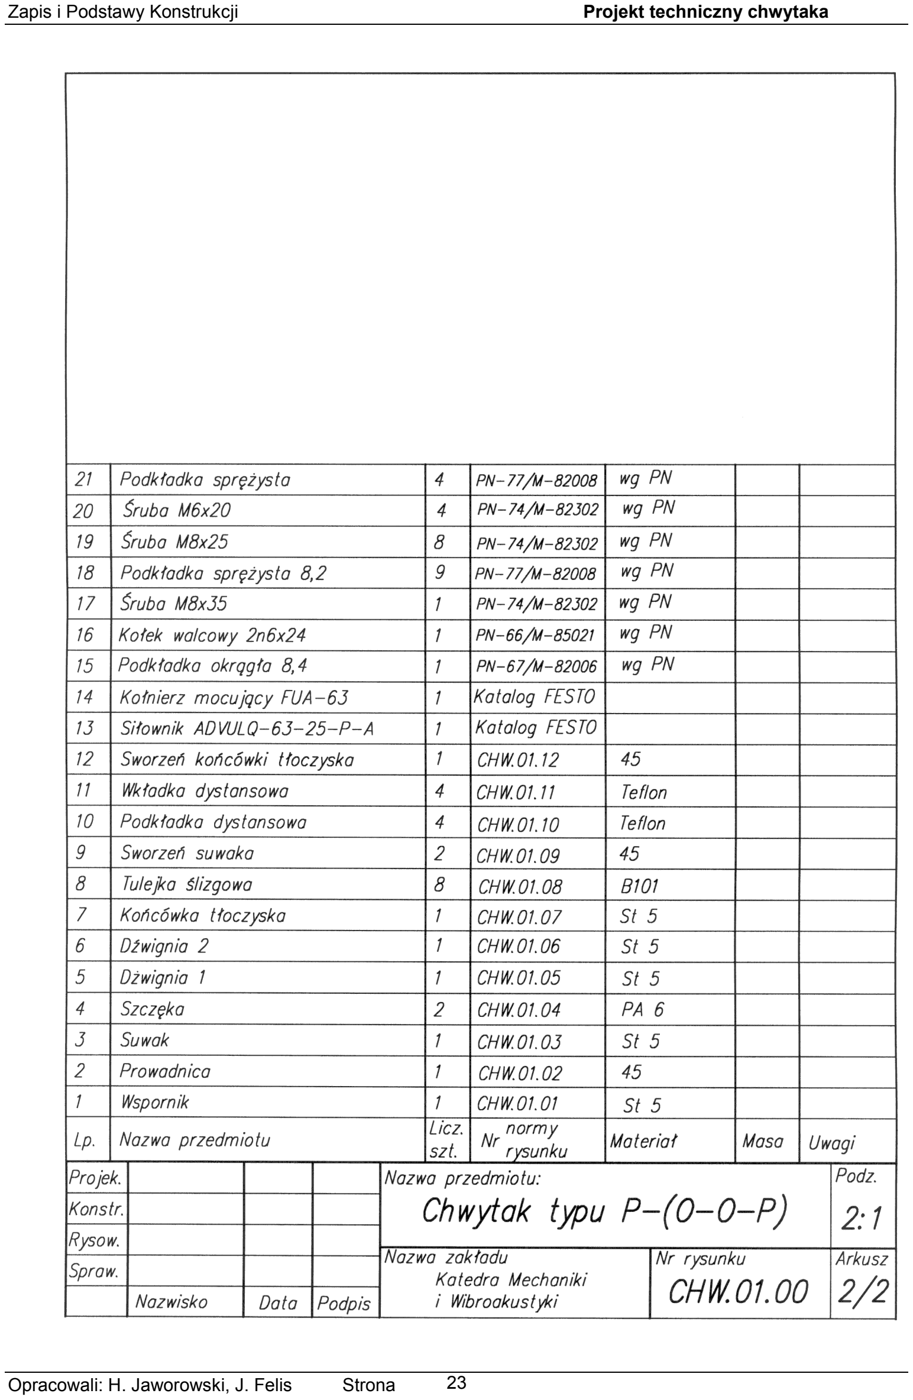
[picture p119: page 23]
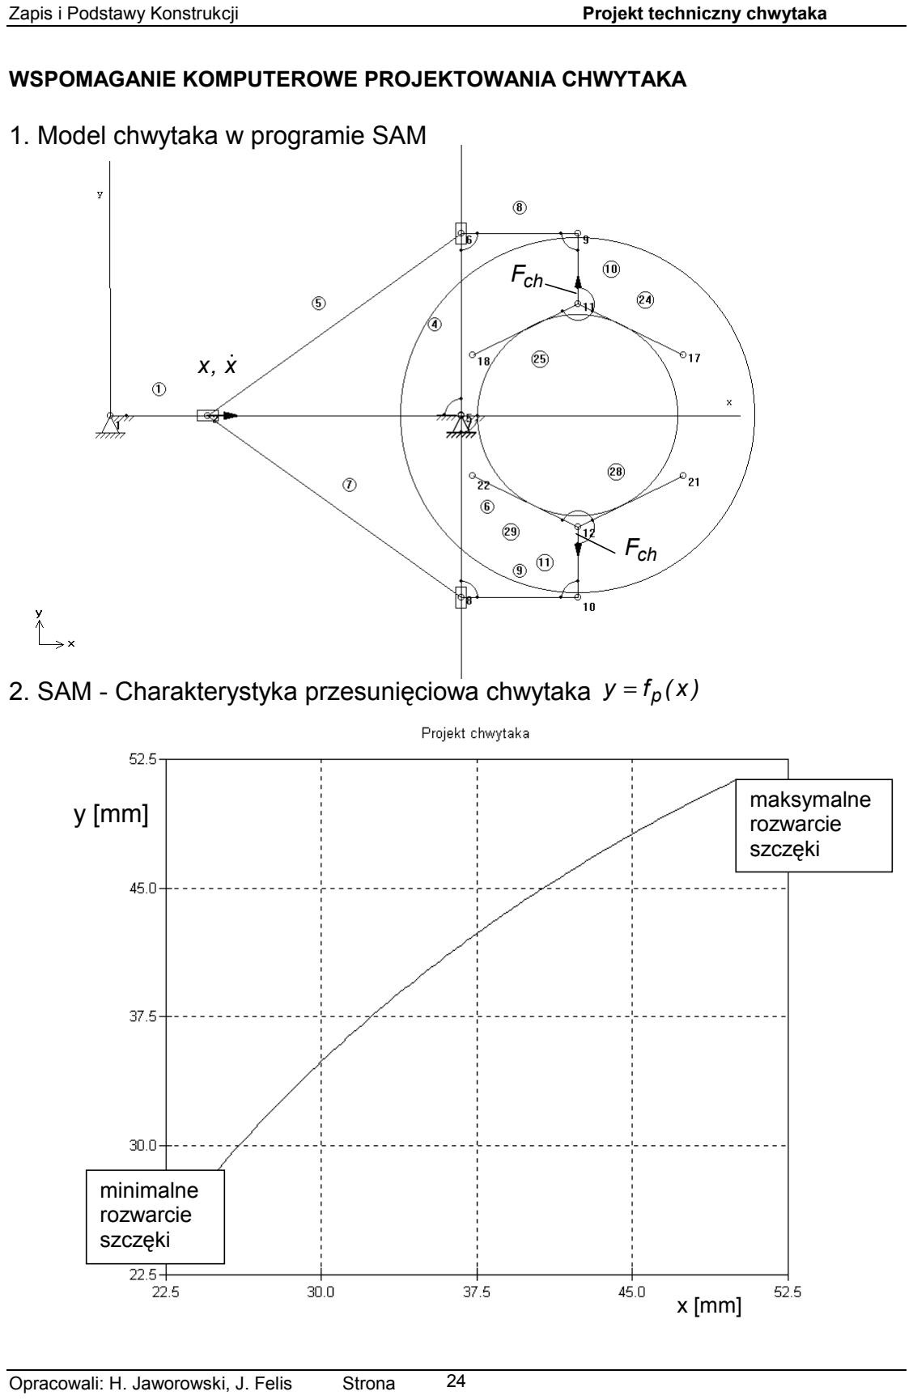
[picture p120: page 24]

minimalne
rozwarcie
szczęki

maksymalne
rozwarcie
szczęki

WSPOMAGANIE KOMPUTEROWE PROJEKTOWANIA CHWYTAKA

1. Model chwytaka w programie SAM
2. SAM - Charakterystyka przesunięciowa chwytaka y f ( x ) = p

y [mm]

x [mm]

Fch

Fch

x, x&

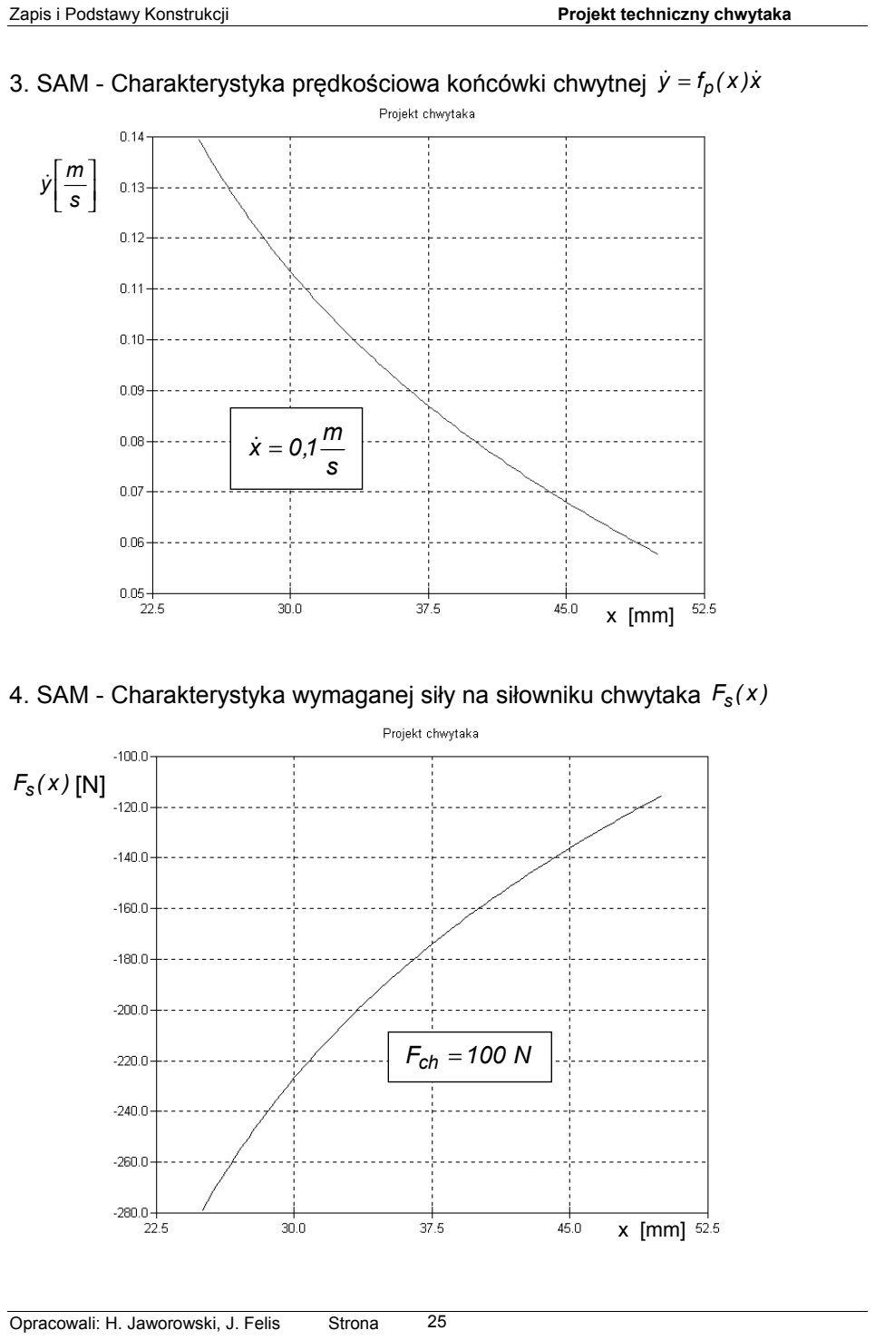
[picture p121: page 25]

Fch = 100 N

3. SAM - Charakterystyka prędkościowa końcÛwki chwytnej y& = fp( x )x&

x [mm]

4. SAM - Charakterystyka wymaganej siły na siłowniku chwytaka F ( x ) s

F ( x ) s [N]

x [mm]

s

m
y&

s

m
x& = 0,1
