WykwalifikowanyProgramista2000/Moj_Chwd_Pytak/Front.PNG

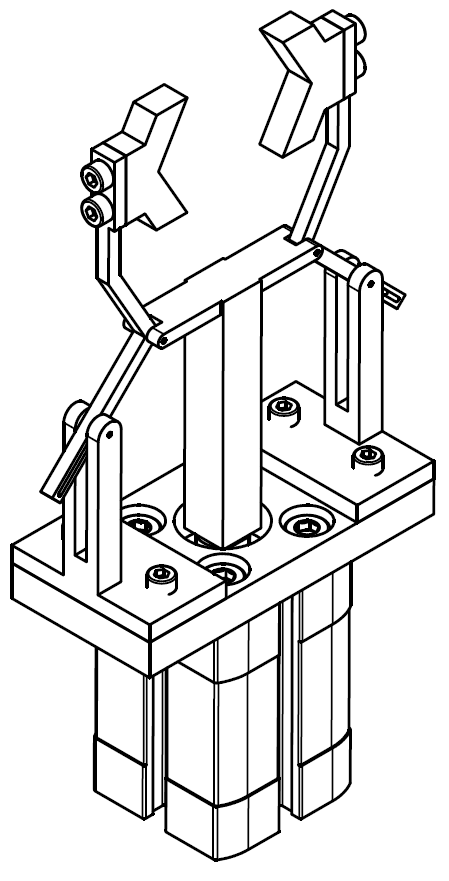
Front.PNG
