WykwalifikowanyProgramista2000/Moj_Chwd_Pytak/Obrazki/Rys 2 paint.png

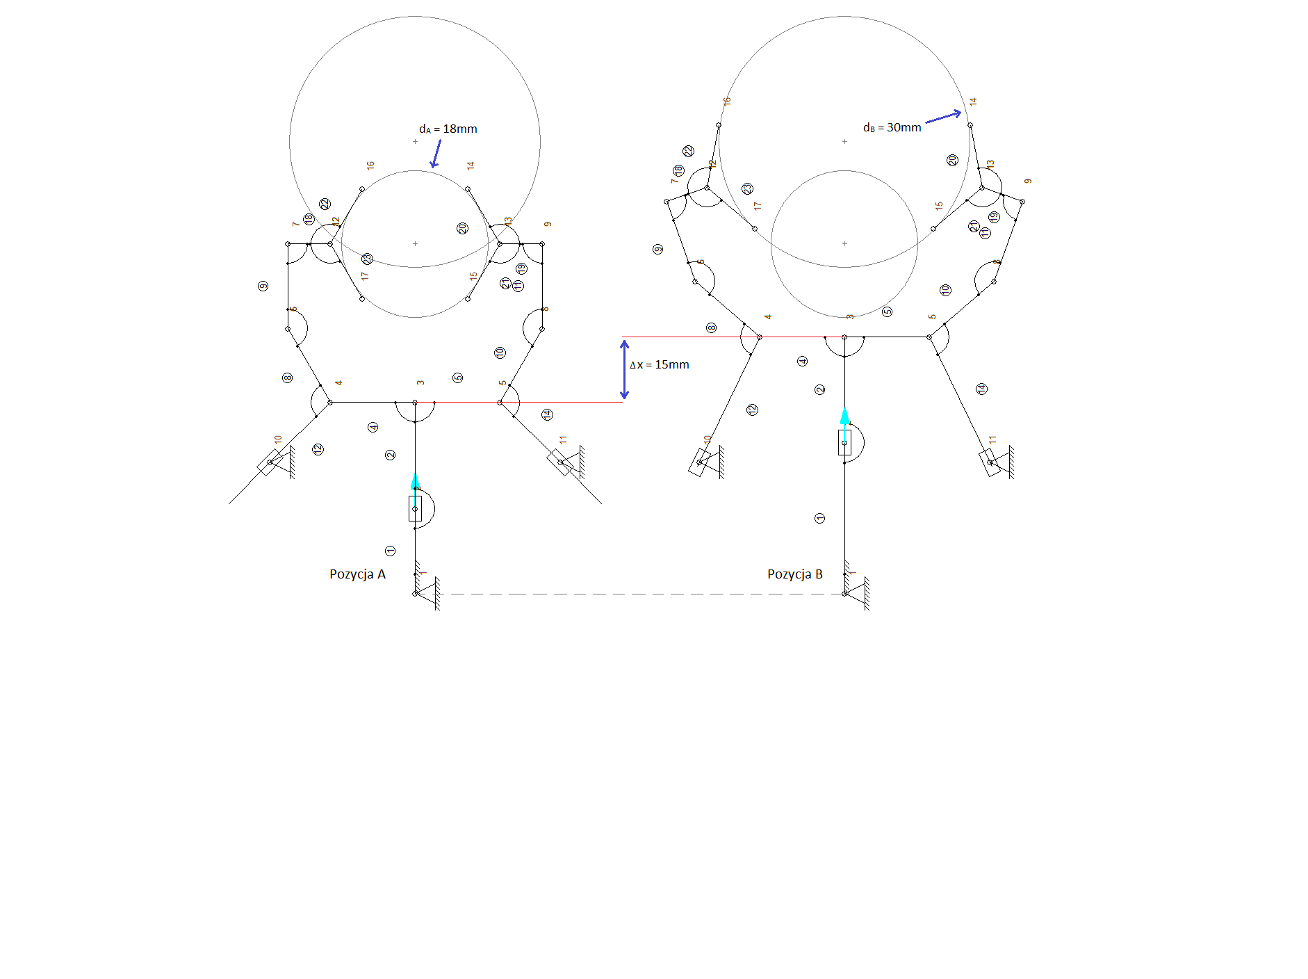
Obrazki/Rys 2 paint.png
