WykwalifikowanyProgramista2000/Moj_Chwd_Pytak/wzor tabelki 2.PNG

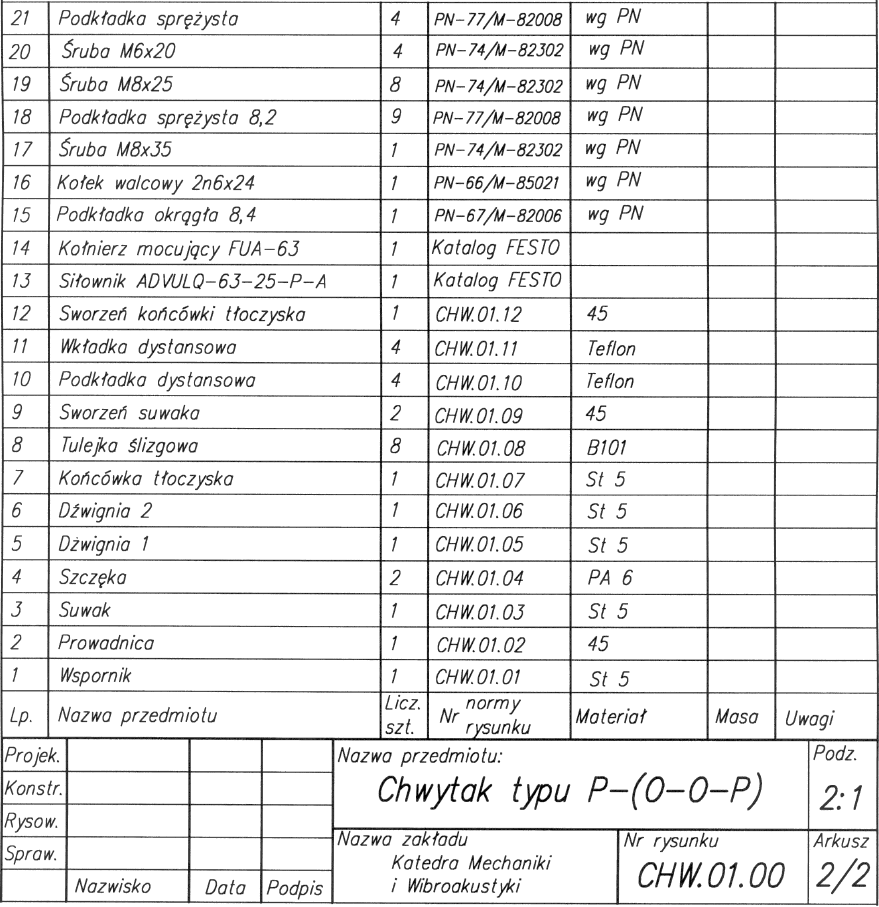
wzor tabelki 2.PNG
