WykwalifikowanyProgramista2000/Moj_Chwd_Pytak/(list of files, cad)

Other CAD files:
Fajne Chwytaki/chwytak_nr.10/chwytak.dwg
Inventorowe chwytaki/Rysunki/Chwytak-20-001 Rysunek główny.dwg
Fajne Chwytaki/chwytak_nr.10/chwytak.0002.dwg
Inventorowe chwytaki/Rysunki/OldVersions/Chwytak-20-001 Rysunek główny.0005.dwg
Inventorowe chwytaki/Ciągaczka.ipt
Inventorowe chwytaki/Gotowy chwytak.iam
Inventorowe chwytaki/Kołnierz z siłownikiem.iam
Inventorowe chwytaki/Kołnierz/537247 FNC-20---(F).ipt
Inventorowe chwytaki/Kołnierz/537247 FNC-20.iam
Inventorowe chwytaki/Kołnierz/DIN-6912 - M5x20(F).ipt
Inventorowe chwytaki/Kołnierz/OldVersions/DIN-6912 - M5x20(F).0001.ipt
Inventorowe chwytaki/MOJ KOLNIERZ.ipt
Inventorowe chwytaki/OldVersions/Ciągaczka.0009.ipt
Inventorowe chwytaki/OldVersions/Gotowy chwytak.0009.iam
Inventorowe chwytaki/OldVersions/MOJ KOLNIERZ.0005.ipt
Inventorowe chwytaki/OldVersions/Podstawka.0007.ipt
Inventorowe chwytaki/OldVersions/Prototyp 1.0001.iam
Inventorowe chwytaki/OldVersions/Ramię z łapką.0004.iam
Inventorowe chwytaki/OldVersions/Ramię♥.0008.ipt
Inventorowe chwytaki/OldVersions/test.0006.iam
Inventorowe chwytaki/OldVersions/Łapka.0004.ipt
Inventorowe chwytaki/PIN.ipt
Inventorowe chwytaki/Podstawka.ipt
Inventorowe chwytaki/Prototyp 1.iam
Inventorowe chwytaki/Ramię z łapką.iam
Inventorowe chwytaki/Ramię♥.ipt
Inventorowe chwytaki/Silownik/536233 ADN-15-P---(Z).ipt
Inventorowe chwytaki/Silownik/536233 ADN-15-P-A_(KS).ipt
Inventorowe chwytaki/Silownik/536236 ADN-20-15-A-P-A---(asm_0).iam
Inventorowe chwytaki/Silownik/OldVersions/536233 ADN-15-P---(Z).0001.ipt
Inventorowe chwytaki/Silownik/OldVersions/536233 ADN-15-P-A_(KS).0001.ipt
Inventorowe chwytaki/Silownik/OldVersions/536236 ADN-20-15-A-P-A---(asm_0).0001.iam
Inventorowe chwytaki/Łapka.ipt
