WykwalifikowanyProgramista2000/Moj_Chwd_Pytak/DO DRUKU/4 Chwytak - 20 - 002 Rysunek ramienia.pdf

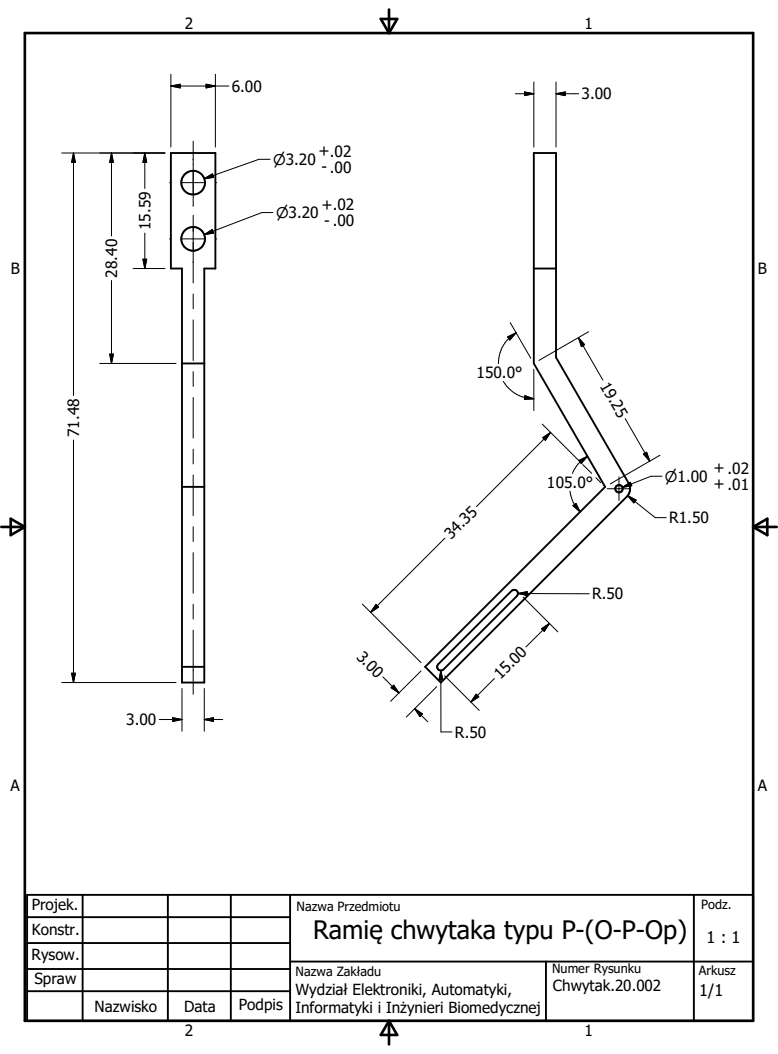
[picture p125: page 1]

Projek. | | | | Nazwa Przedmiotu Ramię chwytaka typu P-(O-P-Op) | Podz. 1 : 1
Konstr.
Rysow.
Spraw

Nazwa Zakładu Wydział Elektroniki, Automatyki, Informatyki i Inżynieri Biomedycznej | Numer Rysunku Chwytak.20.002 | Arkusz

Nazwisko | Data | Podpis
