WykwalifikowanyProgramista2000/Moj_Chwd_Pytak/DO DRUKU/2 Chwytak-20-001 Rysunek główny 1.pdf

1

2

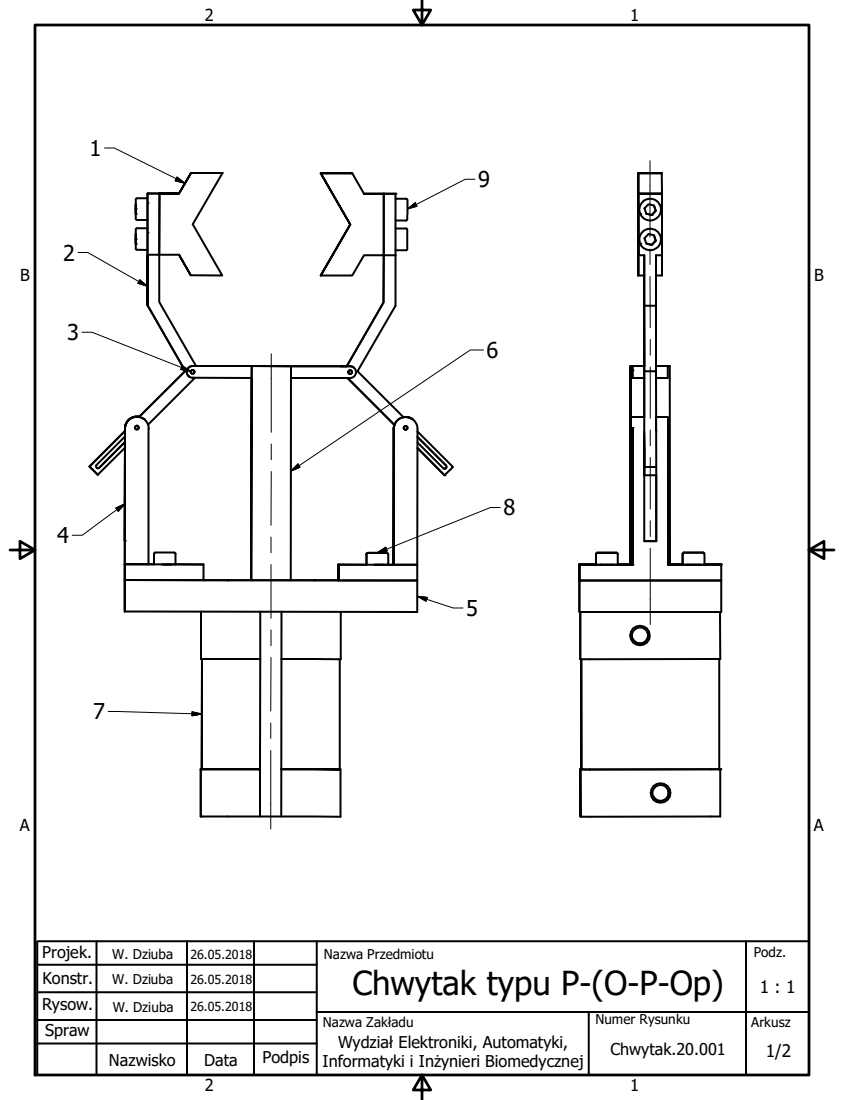
[picture p126: page 1]
Projek.; Konstr.; Rysow.; Spraw; Nazwisko; Data; Podpis; Podz.; Numer Rysunku; Chwytak.20.001; Arkusz; W. Dziuba

Nazwa Przedmiotu
Chwytak typu P-(O-P-Op)

Nazwa Zakáadu
Wydziaá Elektroniki, Automatyki,
Informatyki i Inynieri Biomedycznej
