WykwalifikowanyProgramista2000/Moj_Chwd_Pytak/Inventorowe chwytaki/Rysunki/Front.pdf

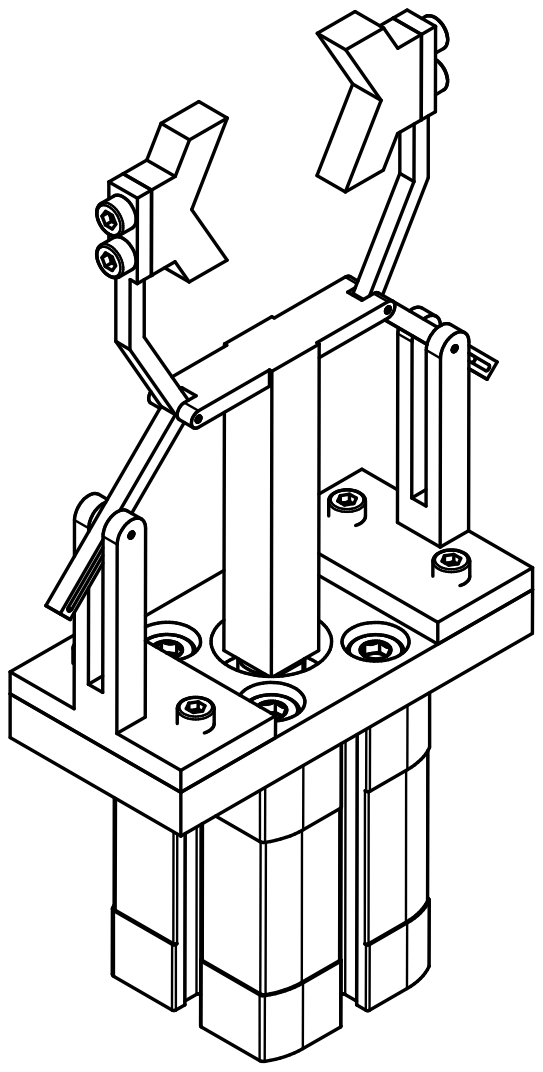
[picture p127: page 1]
