WykwalifikowanyProgramista2000/Moj_Chwd_Pytak/Inventorowe chwytaki/Rysunki/Realistik.pdf

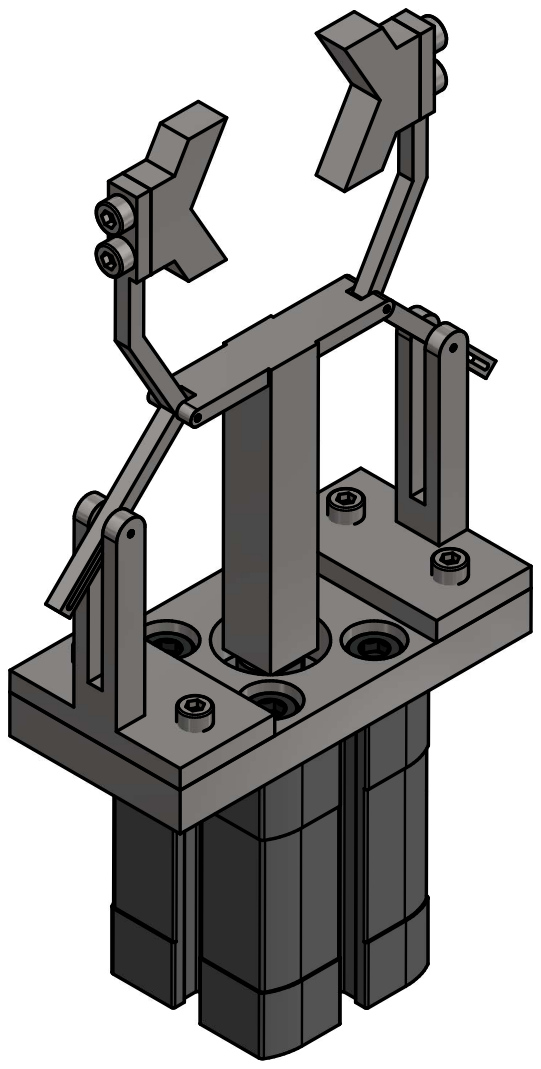
[picture p128: page 1]
