WykwalifikowanyProgramista2000/Moj_Chwd_Pytak/(commit log)

2018-05-25 Dodano obliczenia i rozwiązano aż do doboru pneumatycznego sterownika
    [Charakterystyka przemieszczeniowa analitycznie - policzone + wykres.xlsx]
2018-05-26 Jes progres
    - dodano nowe fajne chwytaki
    - dodano modele cad elementów
    - dodano karty danych elementów
    - ogólny progres
    [Charakterystyka przemieszczeniowa analitycznie - policzone + wykres.xlsx]
2018-05-26 Wykonano wszystko oprócz zginania ramion i projektu w inwentorze :)
    Nienawidzę ścinania sworzni >:[
    [174376 FNC-32---(F).ipt, 174376 FNC-32.iam, 536267 ADN-15-P---(Z).ipt, 536267 ADN-15-P-A_(KS).ipt, 536270 ADN-32-15-A-P-A---(asm_0).iam, DIN-439-B - M10x1_25(F).ipt, DIN-6912 - M6x18(F).ipt]
2018-05-29 Naprawiono błędy i dodano właściwe siłownik i kołnierz
    [536203 ADN-15-P---(Z).ipt, 536203 ADN-15-P-A_(KS).ipt, 536206 ADN-12-15-A-P-A---(asm_0).iam, 537245 FNC-12---(F).ipt, 537245 FNC-12.iam, DIN-6912 - M4x16(F).ipt]
2018-05-29 Dodano Model w inventorze i skończono obliczenia
    [174376 FNC-32---(F).ipt, 174376 FNC-32.iam, 536203 ADN-15-P---(Z).ipt, 536203 ADN-15-P-A_(KS).ipt, 536206 ADN-12-15-A-P-A---(asm_0).iam, 536233 ADN-15-P---(Z).0001.ipt, 536233 ADN-15-P---(Z).ipt, 536233 ADN-15-P-A_(KS).0001.ipt]
2018-05-29 Reorganizacja plików, naprawa błędów w edycji tekstu
    [Charakterystyka przemieszczeniowa analitycznie - policzone + wykres.xlsx, Charakterystyki analitycznie policzone + wykresy.xlsx]
2018-05-29 Dodano rysunek główny chwytaka oraz listę części
    Oznacza to że został tylko jeden rysunek do zrobienia i gotowe
    [Chwytak-20-001 Rysunek główny.dwg, Gotowy chwytak.0008.iam, Gotowy chwytak.iam, chwytak.0002.dwg, chwytak.dwg, test.iam]
